Chamil1983/SM-GE3222M-Smart-Energy-Monitor/Examples/README.md

**SM-GE3222M ESP32 ATM90E32/ATM90E36 Smart IoT Power Energy Monitor**

------------

**NEW FIRMWARE**: [**Released**](https://github.com/Chamil1983/SM-GE3222M-Smart-Energy-Monitor/blob/main/Firmware_Released/) is an Integrated Firmware for SM-GE3222M Power Energy Monitor SDK Boards

*** IMPORTANT: This folder contains the IPEM Example Source Code. This is not the real Code Only for Reference

  Remember!
  - Set the BOARD to ESP32, 'WEMOS D1 MINI ESP32' DEV Module (or similar).
  - You may set the BAUD rate to 921600 to speed up flashing.
  - The SDK does NOT need external power to flash.  It will take Power from the USB 5V.

  This test code is OPEN SOURCE and formatted for easier viewing.  Although it is not intended for real-world use, it may be freely used, or modified as needed.
  It is distributed on an "AS IS" BASIS, WITHOUT WARRANTIES OR CONDITIONS OF ANY KIND, either express or implied.

We value our Customers, Users of our designs, and STEM Communities, all over the World. Should you have any other questions, or feedback to share with others, please feel free to:

***Chamil Vithanage, Microcode Embedded Solutions, Australia.***

Electronics Engineer | Software Developer | R&D Support | RF Engineering | Product Certification and Testing
