Chamil1983/SM-GE3222M-Smart-Energy-Monitor/Firmware_Released/SM_GE3222M_V2_Project_Scope_Architecture.docx

SM-GE3222M Smart Energy Monitor
V2.0 Firmware & VB.NET Integration Scope

Project Scope and Architecture Definition (Pre-Implementation)
Date: 20 Feb 2026

# 1. Purpose and Scope

This document defines the complete end-to-end scope for the ESP32-based SM-GE3222M Energy Meter V2.0 firmware and its VB.NET application integration. It is intended to be finalized before coding begins, ensuring consistent architecture, interfaces, register maps, and validation/diagnostics behavior.

- Firmware target: ESP32 (Arduino framework, FreeRTOS tasks).
- Energy IC driver: EnergyATM90E36.h/.cpp MUST remain unchanged from V1.0.
- Hardware configuration and calibration defaults MUST match V1.0 Definitions.h baseline.
- Modbus TCP is removed completely. Modbus RTU only.
- Ethernet TCP/IP is used for general TCP JSON communications today; future BACnet/IP will reuse Ethernet stack.
- Web UI is optional but supported; it must consume the same runtime data model as Modbus and TCP.

# 2. Key Design Constraints

- Do not modify EnergyATM90E36.h/.cpp (bit-identical to V1.0).
- SPI pins for ATM90E36: CS=GPIO5, SCK=GPIO18, MISO=GPIO19, MOSI=GPIO23.
- MCP23017 I2C address 0x20 with interrupt outputs: INT_A=GPIO25, INT_B=GPIO26.
- DHT22 sensor input: DHTPIN=GPIO4.
- DC voltage sensing (ADC1): DCV_IN=GPIO36.
- LCD: 20x4 LiquidCrystal_I2C address 0x27.
- Stable networking priority: Ethernet -> WiFi STA-only -> AP-only fallback (no mode flapping).
- Single source of truth runtime data model shared across LCD, Web, TCP JSON, and Modbus RTU.

# 3. Hardware Configuration

All pins and peripherals below are authoritative for V2.0 and must match the V1.0 baseline where applicable.

Subsystem | Device / Interface | Pins / Address | Notes / Ownership
MCU | ESP32 | - | Arduino framework, FreeRTOS tasks
Energy IC | ATM90E36 (SPI) | CS=5, SCK=18, MISO=19, MOSI=23 | SPIBus initializes pins; driver unchanged
I/O Expander | MCP23017 (I2C) | Addr 0x20; INT_A=25; INT_B=26 | All expander IO via MCP23017Hal
LCD | LiquidCrystal_I2C | Addr 0x27; 20x4 | LCDManager uses shared I2C bus
Sensor | DHT22 | GPIO4 | DHT22Service only; timed reads (>=2s)
Analog Sense | DC Voltage ADC | GPIO36 (ADC1) | DcVoltageService + AdcHal; filtered & scaled
Buttons | Mode, Set | GPIO32, GPIO33 | Debounced; UI events
Ethernet | W5500 (SPI or dedicated) | per board | General TCP/IP today; future BACnet/IP
Wi-Fi | ESP32 radio | - | STA-only or AP-only; no dual mode

MCP23017 logical channel assignment (example as per V1 baseline):

MCP Pin Index | Signal | Direction / Use
0 | RELAY_2 | Output
1 | RELAY_1 | Output
2 | WIFI_LED | Output
3 | RUN_LED | Output
4 | FLT_LED | Output
5 | MODBUS_LED | Output
11 | CF4 | Input (pulse)
12 | CF3 | Input (pulse)
13 | CF2 | Input (pulse)
14 | CF1 | Input (pulse)

# 4. Proposed Firmware Directory Structure

The V2.0 project remains within the existing Arduino sketch structure and adds modular code under src/.

SM_GE3222M/
SM_GE3222M.ino (thin: boot + scheduler start)
Definitions.h (V1 baseline: calibration + hardware constants)
EnergyATM90E36.h/.cpp (UNTOUCHED driver)
data/ (SPIFFS web assets)
include/
PinMap.h
GlobalTypes.h
Version.h
ModbusRegMap.h (constants only)
src/
core/
SystemManager.h/.cpp (boot phases, SAFE MODE, orchestrator)
TaskScheduler.h/.cpp (cooperative tick scheduler)
TimerManager.h/.cpp
EventBus.h/.cpp (optional)
hal/
BoardConfig.h/.cpp (authoritative pins/feature flags)
SPIBus.h/.cpp (SPI pin init: 18/19/23 + CS5)
I2CBus.h/.cpp (shared Wire + mutex)
MCP23017Hal.h/.cpp (IO + interrupt capture)
AdcHal.h/.cpp (ADC1 reads + filtering helpers)
GPIOManager.h/.cpp (buttons, esp gpio)
energy/
EnergyMeter.h/.cpp (wraps unchanged driver; validates readings)
Calibration.h/.cpp (apply + store validation)
EnergyAccumulator.h/.cpp (persistent totals)
sensors/
DHT22Service.h/.cpp (GPIO4)
DcVoltageService.h/.cpp (GPIO36)
comm/
EthernetManager.h/.cpp (general TCP/IP + link status)
WiFiManager.h/.cpp (STA-only/AP-only; fallback policy)
TcpJsonLinkService.h/.cpp (ESP32 <-> VB TCP JSON)
ModbusRTUServer.h/.cpp (Modbus RTU only; no Modbus TCP)
ModbusMap.h/.cpp (getters/setters wired to SystemContext)
WebServerManager.h/.cpp (optional HTTP/WS)
APIServer.h/.cpp (JSON endpoints for Web)
display/
LCDManager.h/.cpp (LiquidCrystal_I2C 0x27, 20x4)
LEDIndicator.h/.cpp (status patterns)
storage/
SPIFFSManager.h/.cpp (mount + file helpers)
ConfigManager.h/.cpp (/config.txt compatible)
NVStorage.h/.cpp (optional NVS mirror)
DataLogger.h/.cpp (event log ring buffer)
diagnostics/
Logger.h/.cpp (ring buffer + levels)
ErrorHandler.h/.cpp (codes, severity, recovery policy)
HealthMonitor.h/.cpp (reboot loop detect, heap checks)
WatchdogManager.h/.cpp (task liveness + WDT feed)

# 5. Proposed V2.0 Firmware Architecture

Architecture is layered to prevent cross-coupling, eliminate blocking behavior, and ensure one data model feeds all interfaces.

+--------------------------------------------------------------+
| Application Layer |
| LCD UI | Web UI (optional) | TCP JSON Link | Modbus RTU |
+-------------------------+------------------------------------+
| Services Layer |
| EnergyService | SensorServices | ConfigStore | Diagnostics |
+-------------------------+------------------------------------+
| Hardware Abstraction Layer |
| SPIBus | I2CBus | MCP23017Hal | AdcHal | GPIOManager |
+-------------------------+------------------------------------+
| Platform / OS (ESP32 Arduino) |
| FreeRTOS tasks, WDT, WiFi/Ethernet stacks, SPIFFS |
+--------------------------------------------------------------+

Key rules:

- Only HAL modules access hardware buses (SPI/I2C/ADC/GPIO).
- Only service modules update the SystemContext runtime model.
- UI and protocols are read-only consumers of SystemContext except via controlled command APIs.
- No I2C or SPI operations inside ISRs; ISRs only set flags for tasks.

# 6. Firmware Data Flow Block Diagram

+--------------------+
| ConfigManager |
| /config.txt + CRC |
+----------+---------+
|
v
+-------------+ +--------------+--------------+ +------------------+
| ATM90E36 IC | --> | EnergyMeter (driver wrapper) | --> | |
+-------------+ +--------------+--------------+ | |
| | |
v | |
+-------------+ +--------------+--------------+ | SystemContext |--> LCDManager
| DHT22 | --> | DHT22Service (timed reads) | ----> | (single truth) |--> WebServer/APIServer
+-------------+ +--------------+--------------+ | |--> TcpJsonLinkService
| | |--> ModbusRTUServer
v | |
+-------------+ +--------------+--------------+ | |
| ADC GPIO36 | --> | DcVoltageService (filter) | ----> | |
+-------------+ +--------------+--------------+ +------------------+
^
|
+--------------+--------------+
| MCP23017Hal (INTA/INTB) |
| pulse + DI capture + DO set |
+-----------------------------+

Data update policy: energy/sensors/network tasks write to SystemContext; protocol/UI tasks read only.

# 7. Communication Protocol V2 (TCP JSON, Backward Compatible)

TCP protocol is newline-delimited JSON frames. It remains backward compatible by preserving existing keys used by the VB.NET application, while adding optional V2 fields.

- Transport: TCP socket over Ethernet or WiFi (STA/AP).
- Framing: UTF-8 JSON per line (\n). No binary framing required.
- Compatibility: V1 keys are preserved; V2 adds optional fields under 'v2' object where needed.
- Reliability: sequence counters + acknowledgements for commands; reconnect safe.

Message types (minimum set):

Type | Direction | Purpose | Required Fields
hello | ESP32 -> VB | Device identity and capabilities | fw, hw, mac, mode, features
status | ESP32 -> VB | Network + health snapshot | uptime, net, rssi, heap, errors
readings | ESP32 -> VB | Energy + sensor readings | seq, ts, energy{}, sensors{}
config | VB -> ESP32 / ESP32 -> VB | Get/set config snapshot | action=get|set, payload{}
cmd | VB -> ESP32 | Command execution | id, name, args{}
ack | ESP32 -> VB | Acknowledgement for cmd/config | id, ok, code, msg
error | ESP32 -> VB | Asynchronous fault notification | code, severity, where

## 7.1 TCP Protocol Sequence Diagram (ESP32 ↔ VB.NET)

VB.NET ESP32
| |
|--- TCP connect ------------------------------->|
|<-- hello {fw,hw,mac,features} -----------------|
|--- config {action:'get'} --------------------->|
|<-- config {action:'snapshot',payload:{...}} ---|
| |
|<-- status {net,heap,uptime,errors[]} ----------| (periodic 1-5s)
|<-- readings {seq,ts,energy{},sensors{}} -------| (periodic publish interval)
| |
|--- cmd {id:101,name:'setRelay',args:{...}} --->|
|<-- ack {id:101,ok:true} ----------------------|
| |
|--- cmd {id:102,name:'saveConfig'} ------------>|
|<-- ack {id:102,ok:true} ----------------------|
| |
|<-- error {code:'NET-002',severity:'WARN'} -----| (async if needed)
| |
|--- TCP close / reconnect --------------------->|

## 7.2 Multi-Client Architecture (Normal Operation)

+-------------------+
| VB.NET Client |
+---------+---------+
| TCP JSON
v
+----------------------+------------------------+
| ESP32 Communication Layer |
| TcpJsonLinkService | ModbusRTUServer | WebUI |
+-----------+-------------------+---------------+
| |
v v
SystemContext SPIFFS/Web assets
^
|
Energy/Sensors/Network tasks

# 8. Configuration & Storage Architecture

Configuration storage is designed for safety (CRC + validation), backward compatibility (same filenames), and low risk of corruption.

- Primary store: SPIFFS files (same filenames as V1): /config.txt, /Calibration_1.txt.. /Calibration_4.txt.
- Each file includes a V2 header (version + CRC) while preserving V1 key names and layout.
- Validation and defaulting: missing keys -> defaults; invalid keys -> revert default + raise CFG warning/error.
- Optional NVS mirror (NVStorage) may cache validated config for quicker boot; SPIFFS remains authoritative for export/import.

SPIFFS
/config.txt
- device settings (network, ports, publish interval, feature enables)
- V2 header: version, CRC32, timestamp
/Calibration_1..4.txt
- calibration blocks (register-style values)
- V2 header: version, CRC32, timestamp
/eventlog.bin (optional)
- ring buffer of diagnostics/events
/totals.bin (optional)
- persistent energy totals + CRC

Write policy to reduce wear:

- Only write on explicit user command (save config) or controlled periodic commit for totals (e.g., every 5-15 minutes).
- Atomic update pattern: write temp file then rename to target to avoid partial writes.
- CRC check on read; if CRC fails -> load defaults and set persistent error flag.

# 9. Error Handling & Diagnostics Architecture

V2 introduces structured error codes, severity levels, recovery policies, and observability across LCD, Modbus, and TCP JSON.

Category | Examples | Severity | Recovery Policy
BOOT | boot timeout, reboot loop | FATAL/ERROR | enter SAFE MODE; limit services; require manual reset for some
CFG | missing key, CRC fail | WARN/ERROR | default values; persist error; continue
ENERGY | ATM90E36 init fail, invalid readings | ERROR/FATAL | retry with backoff; degrade mode; show error
NET | STA connect fail, ETH link down | WARN | fallback policy: ETH->STA->AP
I2C/SPI | bus timeout, MCP missing | ERROR | retry; isolate IO; continue with limited function
MODBUS | RTU framing errors, overload | WARN | throttle; increment counters
SENS | DHT timeout, ADC overrange | WARN | keep last valid; mark stale

Error source -> ErrorHandler (code + severity + context)
-> Logger (ring buffer)
-> HealthMonitor (counters, reboot loop detect)
-> Expose to:
- LCD status page (human readable)
- Modbus IR: last_error_code, boot_phase, counters
- TCP JSON: async 'error' frames

# 10. FreeRTOS Task Architecture

Tasks are non-blocking and use a cooperative scheduler tick where possible; long operations are broken into state machines.

Task | Owner Module | Priority | Period/Trigger | Core | Notes
BootTask | core/SystemManager | High | One-shot state machine | Any | Phased init with timeouts
MCPInterruptTask | hal/MCP23017Hal | High | INT_A/INT_B flags | Any | Reads INTCAP; updates DI/pulses
EnergyReadTask | energy/EnergyMeter | Med-High | 200-500 ms | Any | Updates MeterReadings
DHT22Task | sensors/DHT22Service | Low | 2 s | Any | Timed reads; no blocking loops
DCVTask | sensors/DcVoltageService | Low-Med | 200-500 ms | Any | ADC oversample + filter
NetworkTask | comm/*Manager | Med | State machine | Any | ETH->STA->AP fallback
TcpJsonTask | comm/TcpJsonLinkService | Med | Publish interval + socket events | Any | Frames + ACK
ModbusRTUTask | comm/ModbusRTUServer | Med | 10-50 ms tick | Any | RTU only
WebTask (optional) | comm/WebServerManager | Low-Med | event-driven | Any | HTTP endpoints
LCDTask | display/LCDManager | Low | 250-500 ms | Any | Draw diffs only
HealthTask | diagnostics/HealthMonitor | Low | 1-5 s | Any | Heap + reboot loop detect
WDTFeedTask | diagnostics/WatchdogManager | High | 100-250 ms | Any | Feeds only if tasks healthy

# 11. Boot Sequence Diagram

PHASE 0 Reset reason + minimal logger
PHASE 1 SPIFFS mount + load config + load calibration (CRC validate)
PHASE 2 HAL init (SPI pins, I2C, ADC, GPIO, attach INT_A/INT_B)
PHASE 3 MCP23017 init + interrupt-on-change setup + clear captures
PHASE 4 LCD init (0x27, 20x4) + buttons + boot UI
PHASE 5 Energy IC init (unchanged driver) + retry/backoff + safe mode rules
PHASE 6 Sensors start (DHT22 + DCV)
PHASE 7 Network start (ETH -> STA -> AP fallback)
PHASE 8 Start services: TCP JSON, Modbus RTU, optional Web UI
RUN Periodic read/update + diagnostics + watchdog

SAFE MODE entry conditions (examples):

- Energy IC fails init after N retries OR repeated reboot loop detected.
- SPIFFS mount fails or configuration CRC repeatedly invalid.
- In SAFE MODE: allow AP-only + minimal web/config + diagnostics; disable high-rate sampling; keep Modbus RTU optional.

# 12. Modbus RTU Register Map Overview

Modbus TCP is removed. This map is for Modbus RTU using emelianov/modbus-esp8266. Encoding follows V1-style scaled int32 across 2 registers.

- Float-style values: int32 scaled by 10 across two 16-bit registers (low word first).
- uint32 counters: two registers (low word first).
- Bitfields: uint16.
- IPv4: two registers (A<<8|B, C<<8|D).
- MAC: three registers.

Block | Type | Range (hex) | Contents
Input Registers | 3x (RO) | 0x0000-0x009F | V1 energy + RMS/THD/angles (unchanged)
Input Registers | 3x (RO) | 0x00B0-0x00BF | Sensors: DHT22, DCV, statuses
Input Registers | 3x (RO) | 0x00C0-0x00CF | IO: relays/DI bitmaps, CF pulse counters
Input Registers | 3x (RO) | 0x00D0-0x00DF | Network runtime: mode, IPs, RSSI
Input Registers | 3x (RO) | 0x00E0-0x00EF | Diagnostics: uptime, heap, last error
Holding Registers | 4x (RW) | 0x0000-0x0048 | Calibration arrays (stride=2)
Holding Registers | 4x (RW) | 0x0080-0x0088 | Calibration config (MMode0/1 thresholds)
Holding Registers | 4x (RW) | 0x0200-0x0210 | Modbus RTU & COM settings
Holding Registers | 4x (RW) | 0x0300-0x0384 | Identity strings + MAC + board features
Holding Registers | 4x (RW) | 0x0400-0x040C | Ethernet config (DHCP/static, port)
Holding Registers | 4x (RW) | 0x0500-0x052C | WiFi STA config (SSID/pass + IP)
Holding Registers | 4x (RW) | 0x0600-0x0623 | WiFi AP config (SSID/pass + channel + IP)
Holding Registers | 4x (RW) | 0x0700-0x0704 | Web + TCP JSON link settings
Holding Registers | 4x (RW) | 0x0800-0x0849 | Logging, commands, event log window
Holding Registers | 4x (RW) | 0x0850-0x0854 | Pulse output settings (V1 compatible)

Detailed constants are implemented in include/ModbusRegMap.h and consumed by src/comm/ModbusMap.* getters/setters.

# 13. Implementation Scope & Feature Matrix (V1.0 → V2.0)

Area | V1.0 | V2.0 Target | Status in V2 Plan | Notes
Energy IC driver | Working but tightly coupled | Driver unchanged; wrapper + validation | Must keep driver identical | EnergyATM90E36.* untouched
Calibration | SPIFFS text, limited validation | CRC + versioning + atomic writes | Planned | Backward compatible filenames
Networking | Unstable switching | ETH -> STA-only -> AP-only stable | Planned | No mode flapping
Web UI | Partial/unstable | Optional HTTP using shared model | Planned | No blocking in web task
VB comms | Mixed / evolving | TCP JSON V2 + backward keys | Planned | Sequence + ACK
Modbus | RTU + sometimes TCP | RTU only (TCP removed) | Mandatory | Uses emelianov/modbus-esp8266
MCP23017 IO | Basic polling | Interrupt-driven capture + IO shadow | Planned | INT_A=25 INT_B=26
Sensors | Not unified | DHT22 + DCV via services | Added | GPIO4 + GPIO36
Diagnostics | Ad-hoc logs | Error codes + health monitor + event log | Added | Exposed via Modbus + TCP
WDT stability | WDT triggers observed | Non-blocking state machines + liveness checks | Key goal | WatchdogManager gates feed

# 14. Implementation Roadmap

Roadmap is phased to deliver stability first, then features, while keeping the driver unchanged.

Phase | Primary Deliverables | Validation / Tests | Exit Criteria
Phase A - Foundations | Directory structure, SystemContext, Logger, ErrorHandler, SPIFFS config loader (CRC) | Boot without reset; config load + defaulting; basic serial logs | Stable boot, no WDT, correct pin init
Phase B - Hardware HAL + IO | SPIBus pins fixed; I2CBus; MCP23017Hal + INT handling; GPIO + buttons | Interrupt fires; pulse counters increment; outputs controllable | No I2C lockups; stable ISR->task handoff
Phase C - Energy layer | EnergyMeter wrapper, retries/backoff, reading validation; accumulator | Energy readings update at rate; invalid reads flagged; totals persist | No boot halt; readings consistent with V1
Phase D - Sensors | DHT22Service + DcVoltageService; add to model + Modbus | DHT reads every 2s without blocking; DCV filtered | Sensor statuses and values visible
Phase E - Comms | NetworkManager ETH->STA->AP; TCP JSON link; Modbus RTU map; optional Web | Reconnect tests; multi-client; command/ack tests; Modbus scan | VB stable connect; Modbus consistent; no resets
Phase F - Diagnostics hardening | HealthMonitor, WDT gating, event log; performance tuning | Soak test 24-72h; simulated network drops; heap stability | Meets metrics; no watchdog resets

# 15. Improvement Metrics Summary

Quantitative targets to confirm V2.0 improvements:

Metric | Baseline (V1 typical) | V2 Target | How to Measure
Boot time to stable services | Variable; may halt/reset | < 20 s to RUN state | Timestamp logs per boot phase
WDT resets | Observed in web/network tasks | 0 resets in 72h soak | Reset reason counter + event log
WiFi STA reconnect time | Unstable | < 10 s after AP/STA loss | NetworkTask timing + VB status frames
Ethernet link recovery | N/A/variable | < 5 s after link restore | ETH status + IP lease time
Heap minimum | Drops under load | > 40 KB minimum free heap | HealthMonitor min heap register
CPU load | High during polling | Stable under 60% peak | Profiler counters / loop timing
Energy read cadence | Jittery during comms | Consistent +/- 10% | Sequence timestamps

# 16. End-to-End Communication Sequence Diagrams

## 16.1 Normal Operation (ETH active)

BOOT -> NetworkTask selects Ethernet -> TCP JSON server starts -> Modbus RTU ready
VB connects:
1) hello + capabilities
2) config snapshot (optional)
3) periodic status + readings
Commands:
- VB sends cmd (e.g., set relay / save config)
- ESP32 validates -> applies -> ack
Modbus RTU:
- PLC/HMI polls energy (IR 0x0000..0x009F) and sensors/net/diag blocks
Web UI (optional):
- Browser reads /api/status and /api/readings (same SystemContext)

## 16.2 Multi-Client (VB + Web + Modbus RTU)

Clients:
- VB.NET (TCP JSON) (high-level control + config + graphs)
- PLC/HMI (Modbus RTU) (industrial integration)
- Browser (HTTP) optional (service UI)
All clients read the same SystemContext snapshot.
Write operations are serialized through command handlers:
VB cmd/config -> CommandQueue -> SystemManager applies -> ack -> optional persist

# Appendix A. JSON Frame Examples (V2 compatible)

hello:
{"type":"hello","fw":"2.0.0","hw":"GE3222M-A","mac":"C8:2E:A3:F5:7D:DC","features":{"eth":1,"wifi":1,"dht22":1,"dcv":1,"lcd":1,"mcp":1}}

readings:
{"type":"readings","seq":1234,"ts":1739960000,
"energy":{"uA":2305,"uB":2310,"uC":2298,"iA":120,"iB":110,"iC":98,"pT":3520},
"sensors":{"tC":285,"rh":520,"dcv":123}
}

cmd:
{"type":"cmd","id":101,"name":"setRelay","args":{"ch":1,"on":true}}

ack:
{"type":"ack","id":101,"ok":true}

# Appendix B. Modbus Blocks Summary

Use include/ModbusRegMap.h for full constants. Key blocks:

- IR 0x0000-0x009F: V1 energy block (unchanged).
- IR 0x00B0-0x00BF: sensors (DHT22, DCV).
- IR 0x00C0-0x00CF: IO (bitmaps + CF pulse counters).
- IR 0x00D0-0x00DF: network runtime.
- IR 0x00E0-0x00EF: diagnostics.
- HR blocks: calibration (0x0000+), config, identity, network settings, logging, commands.

End of document.
