Chamil1983/SM-GE3222M-Smart-Energy-Monitor/Firmware_Released/Updated_Implementation_Plan_SM_GE3222M_V2_W5500_BACnet.docx

Updated Implementation Plan for SM_GE3222M_V2

W5500 EthernetManager + BACnet/IP Integration + Device/Binary/Analog Object Extensions

This document captures the updated implementation plan for integrating a W5500 Ethernet module, BACnet/IP services, expanded BACnet Device metadata, additional Binary Input and Binary Output object mappings, GPIO36 ADC-based DC voltage monitoring, RTC/time exposure, and communication interface configuration and monitoring for the SM_GE3222M_V2 energy meter firmware project.

The plan is designed to fit within the current project structure, protect existing Web UI behavior, and preserve overall firmware stability under continuous load.

# 1. Scope Update Summary

The implementation scope includes the following major additions and updates:

- New EthernetManager.h/.cpp for W5500 Ethernet on shared SPI bus (MISO GPIO19, MOSI GPIO23, SCK GPIO18, CS GPIO14; INT and RST not connected).
- BACnet/IP over W5500 Ethernet (UDP port 47808) with transport health monitoring, auto-rebind, and load-safe processing.
- Refactored BACnetDriver and BACnetIntegration layers aligned to the SM_GE3222M_V2 project architecture.
- Expanded BACnet Device Object metadata including identity, firmware/application versions, and Object_List.
- Custom MESA vendor properties for device identity, network addressing, AP details, and runtime service information.
- Additional Binary Output objects for MCP Port-A LEDs (WiFi, Run, Fault, Modbus Activity).
- Additional Binary Input objects for MCP Port-B signals (IRQ1, IRQ2, ATM_WARN, CF1, CF2, CF3, CF4).
- New Analog Input object for scaled DC voltage at GPIO36 (VP / ADC1_CH0).
- RTC/time exposure using ESP32 system time and existing NTP synchronization infrastructure.
- Communication interface configuration and monitoring section for Modbus, WiFi (Station and AP), and Ethernet settings, including IP/Subnet/Gateway/DNS and MAC addresses.

# 2. Design Goals and Constraints

The design goal is to add Ethernet and BACnet/IP functionality without destabilizing existing energy meter sampling, logging, Modbus services, or Web UI behavior.

- No changes to frontend Web UI files (data/index.html, dashboard.js, style.css).
- No forced migration of existing Web or TCP JSON services to Ethernet in this phase.
- BACnet/IP must remain stable under continuous polling and mixed traffic.
- W5500 and ATM90E36 share the SPI bus and must be synchronized to prevent transaction collisions.
- Implementation should be project-native and compatible with the current task and module structure.

# 3. Critical Hardware and Bus Considerations

The W5500 Ethernet controller shares the SPI bus with the ATM90E36 metering IC. The ATM90E36 uses one SPI mode/speed profile while W5500 typically uses a different profile. Unsynchronized access can corrupt meter reads or network transfers.

Planned mitigation: extend and reuse the existing SPIBus arbitration (mutex-based) so all W5500 transactions are protected by the same SPI bus lock mechanism used by the meter path.

Signal | Pin | Notes
SPI MISO | GPIO19 | Shared SPI bus line
SPI MOSI | GPIO23 | Shared SPI bus line
SPI SCK | GPIO18 | Shared SPI bus line
W5500 CS | GPIO14 | Ethernet chip select
W5500 INT | Not connected | Polling mode only
W5500 RESET | Not connected | Software recovery only

# 4. Architecture Overview

The architecture is split into a transport manager, a BACnet core driver, and a project-specific integration layer.

- EthernetManager: initializes and supervises W5500, tracks link/IP state, manages UDP socket lifecycle for BACnet, and performs software recovery.
- BACnetDriver: handles BACnet/IP packet processing, discovery (Who-Is / I-Am), property read/write services, request validation, and runtime statistics.
- BACnetIntegration: maps SM_GE3222M_V2 data structures and hardware status/control points to BACnet Device/AI/BI/BO objects, including new LEDs, diagnostic inputs, and GPIO36 DC voltage AI.
- RTC / Time Layer: uses ESP32 system time and existing NTPSync infrastructure to provide timestamps and BACnet time properties.

# 5. EthernetManager.h/.cpp Implementation Plan

EthernetManager will be a project-native driver wrapper for the W5500 Ethernet controller using the Arduino Ethernet and EthernetUDP APIs, with explicit SPI protection and state recovery.

## 5.1 Primary Responsibilities

- Initialize SPI and W5500 with project pin definitions from PinMap.h (CS on GPIO14).
- Support DHCP and static addressing modes.
- Detect link status and debounce link changes.
- Track valid IP state and detect IP changes (especially after DHCP renewal).
- Provide BACnet UDP bind/read/write wrappers and socket restart logic.
- Implement software recovery when link/IP/UDP failures persist (no hardware reset pin available).
- Expose runtime status and counters for diagnostics and BACnet vendor properties.

## 5.2 Proposed Public API

Representative interface (planned):

bool begin(const EthernetConfig& cfg);
void update();

bool isInitialized() const;
bool isLinkUp() const;
bool isIpReady() const;

IPAddress localIP() const;
IPAddress subnetMask() const;
IPAddress gatewayIP() const;
IPAddress dnsServerIP() const;
String macAddressString() const;

bool ensureBacnetUdpBound(uint16_t port);
void closeBacnetUdp();
int bacnetUdpRead(uint8_t* buf, size_t len, IPAddress& remoteIp, uint16_t& remotePort);
bool bacnetUdpSend(const uint8_t* data, size_t len, const IPAddress& dstIp, uint16_t dstPort);

bool consumeLinkChangedFlag();
bool consumeIpChangedFlag();

const EthernetStatus& status() const;

## 5.3 Recovery Strategy

- Poll Ethernet.linkStatus() and IP state in update().
- If link drops: mark UDP as invalid, increment counters, and wait for link restoration.
- If link restores: verify IP (DHCP or static), rebind BACnet UDP, and notify BACnet layer to re-announce I-Am.
- If UDP bind fails repeatedly: close socket, reinitialize Ethernet interface, and retry with backoff.
- All SPI operations are guarded by SPIBus lock/unlock to prevent conflicts with metering operations.

# 6. BACnetDriver Refactor Plan (SM_GE3222M_V2)

The attached BACnetDriver developed previously will be refactored to remove KC868-specific assumptions and align to the SM_GE3222M_V2 architecture and data model.

## 6.1 Refactor Objectives

- Remove legacy project dependencies and direct global references.
- Use EthernetManager as the transport provider for BACnet/IP over W5500.
- Retain useful BACnet features: Who-Is, I-Am, ReadProperty, WriteProperty (for supported objects), duplicate request cache, and vendor properties.
- Ensure non-blocking packet processing and bounded work per cycle to remain watchdog-safe under continuous load.
- Expose runtime statistics (rx, tx, errors, duplicate hits, last client address, restarts).

## 6.2 BACnet Services in This Phase

Service | Support | Notes
Who-Is | Yes | Respond with I-Am when device instance matches / unicast or broadcast request
I-Am | Yes | On discovery and periodic announce (configurable interval)
ReadProperty | Yes | Device, AI, BI, BO core properties and custom MESA vendor properties
WriteProperty | Partial | BO Present_Value writes (relay and LED objects), selected writable vendor properties
COV / SubscribeCOV | No (Phase 2) | Can be added later if required for true asynchronous updates

## 6.3 Continuous Load Stability Measures

- Bound max processed packets per cycle (configurable, e.g. 4).
- Drop oversized or malformed packets with error counters.
- Use duplicate request cache to avoid repeated heavy processing.
- Rebind UDP on Ethernet link/IP change events.
- Periodic I-Am re-announcement after transport recovery.

# 7. BACnetIntegration Plan (Project Mapping Layer)

BACnetIntegration is the project-specific adapter that maps energy meter measurements, GPIO states, network status, and time information into BACnet objects and properties.

## 7.1 Data Sources

- EnergyMeter snapshot (phase voltages, currents, powers, frequency, power factor, energy totals).
- GPIOManager (relays, MCP Port-A LED states, MCP Port-B diagnostic inputs).
- SMNetworkManager (WiFi station/AP state and addresses).
- EthernetManager (Ethernet MAC/IP/Subnet/Gateway/DNS, link state, health counters).
- NTPSync / ESP32 system time (time validity and formatted date/time).
- ADC reader for GPIO36 (scaled DC voltage input).

## 7.2 Control Outputs (Writes)

- BO1..BO2 writes map to Relay 1 and Relay 2 via GPIOManager.
- BO3..BO6 writes map to MCP Port-A LED outputs (WiFi, Run, Fault, Modbus LED) when remote override is enabled.
- Future extension point for external time sync writes (e.g., from .NET application).

# 8. BACnet Device Object Plan (Expanded Metadata)

The Device object will expose both standard BACnet identity properties and custom MESA vendor properties for commissioning, diagnostics, and future .NET integration.

## 8.1 Standard Device Properties

Property | Source / Notes
Object_Identifier | Configurable BACnet device instance
Object_Name | Configurable via persistent settings
Description | Configurable via persistent settings
Location | Configurable via persistent settings
Vendor_Name | Constant: MESA / Microcode Embedded Systems and Automation
Vendor_Identifier | Configured constant
Model_Name | Constant or config (e.g. SM_GE3222M V2)
Serial_Number | Configurable or derived from unique ID / MAC fallback
Firmware_Revision | Firmware build/version constant
Application_Software_Version | Application version constant
Object_List | Generated from enabled objects at runtime
Protocol / APDU properties | Standard BACnet stack values

## 8.2 Custom MESA Vendor Properties (Expanded)

Vendor properties will be added on the Device object for easier integration with supervisory software and future .NET tooling.

Category | Vendor Property Examples | Notes
Identity | MAC Address, HW Version, Year Developed | Primary and interface-specific MACs can be exposed
Ethernet | IP, Subnet, Gateway, DNS1, DNS2, Link State | Updated live from EthernetManager
WiFi STA | STA MAC, STA IP, SSID, connection state | Read from SMNetworkManager
WiFi AP | AP SSID, AP Pass, AP IP, AP MAC | Security policy should mask password by default
BACnet | BACnet Port, Refresh Interval, Last Client IP, Health Summary | Useful for diagnostics
Time | DateTime string, Time Sync Status, Last Sync Unix | From system time / NTPSync

## 8.3 Security Note for AP Password Property

Exposing the AP password through BACnet is technically possible but sensitive. Recommended default behavior is to expose a masked string (e.g. ********) unless a commissioning-only configuration flag explicitly permits raw password readback.

# 9. BACnet Object Model (Updated)

The BACnet object model is meter-centric and extended with diagnostics and service indicators requested for this project.

## 9.1 Analog Input Objects (AI) - Core Meter Values

- AI1..AI3: Phase A/B/C Voltage
- AI11..AI13: Phase A/B/C Current
- AI21..AI23: Phase A/B/C Active Power
- AI31..AI33: Phase A/B/C Power Factor
- AI40..AI45: Total Power, Reactive Power, Apparent Power, Total PF, Frequency, Neutral Current
- AI50..AI52: Board / Ambient Temperature and Humidity (if available)
- AI60..AI63: Forward/Reverse Active and Reactive Energy totals

## 9.2 New Analog Input Object for DC Voltage

Object | Mapping | Type | Description
AI70 | GPIO36 (VP / ADC1_CH0) | Read-only Analog Input | Scaled DC voltage using divider ratio, gain, and offset calibration

AI70 will read raw ADC samples from GPIO36, apply averaging/filtering, convert to ADC pin voltage, and then apply divider and calibration factors to produce engineering units (Volts).

## 9.3 Binary Output Objects (Writable)

BO | Mapped Signal | Direction | Notes
BO1 | Relay 1 | Write/Read state | Maps to GPIOManager relay control
BO2 | Relay 2 | Write/Read state | Maps to GPIOManager relay control
BO3 | MCP_PORTA_WIFI_LED (GPA2) | Write/Read state | WiFi Status LED
BO4 | MCP_PORTA_RUN_LED (GPA3) | Write/Read state | Running LED (Green)
BO5 | MCP_PORTA_FLT_LED (GPA4) | Write/Read state | Fault LED (Red)
BO6 | MCP_PORTA_MODBUS_LED (GPA5) | Write/Read state | Modbus Activity LED

Recommended default behavior: LED BO writes are accepted only when a BACnet configuration flag (ledRemoteOverrideEnable) is enabled, so firmware-controlled status indication remains intact unless intentionally overridden.

## 9.4 Binary Input Objects (Read-only Status)

BI | Mapped Signal | Notes
BI1..BI8 | System / network / service status | Meter valid, WiFi connected, AP active, Ethernet link, BACnet active, Modbus active, time sync valid, etc.
BI20 | MCP_PORTB_IRQ_1 (GPB0) | Diagnostic input status
BI21 | MCP_PORTB_IRQ_2 (GPB1) | Diagnostic input status
BI22 | MCP_PORTB_ATM_WARN (GPB2) | ATM90E36 warning input
BI23 | MCP_PORTB_CF1 (GPB3) | Pulse state (read-only level)
BI24 | MCP_PORTB_CF2 (GPB4) | Pulse state (read-only level)
BI25 | MCP_PORTB_CF3 (GPB5) | Pulse state (read-only level)
BI26 | MCP_PORTB_CF4 (GPB6) | Pulse state (read-only level)

CF1..CF4 are exposed as level/status inputs in this phase. If pulse counting is required later, a Phase-2 extension can add counters or accumulator objects.

# 10. Data Structures (Additive, Project-safe)

To avoid breaking current firmware modules, the plan uses additive configuration and runtime structures. These can be added to DataTypes.h and persisted through ConfigManager as needed.

## 10.1 DeviceIdentityConfig

Planned structure:

struct DeviceIdentityConfig {
char objectName[48];
char description[96];
char location[64];

char vendorName[32];
uint16_t vendorIdentifier;

char modelName[32];
char serialNumber[32];

char firmwareRevision[24];
char appSoftwareVersion[24];

char hwVersion[16];
uint16_t yearDeveloped;
};

## 10.2 EthernetConfig and EthernetStatus

EthernetConfig stores persistent Ethernet and BACnet-over-Ethernet settings. EthernetStatus stores runtime state and counters (link, IP, UDP bound, recovery counts, and current addressing).

Representative fields (summary):

struct EthernetConfig {
bool enabled;
bool useDHCP;
char macAddress[18];
char ip[16];
char subnet[16];
char gateway[16];
char dns1[16];
char dns2[16];
bool bacnetEnabled;
uint16_t bacnetPort;
uint16_t bacnetRefreshMs;
bool bacnetBroadcastIAm;
uint16_t bacnetIAmIntervalSec;
};

struct EthernetStatus {
bool initialized;
bool hardwareDetected;
bool linkUp;
bool ipReady;
bool udpBound;
bool dhcpActive;
uint32_t lastLinkChangeMs;
uint32_t lastIpChangeMs;
uint32_t lastRecoveryMs;
uint16_t recoveryCount;
uint16_t linkDropCount;
uint16_t udpRebindCount;
uint16_t errorCount;
char macAddress[18];
char ip[16];
char gateway[16];
char subnet[16];
char dns1[16];
};

## 10.3 BACnetConfig (Extended)

Planned fields:

struct BACnetConfig {
bool enabled;
uint32_t deviceInstance;
uint16_t udpPort;
uint16_t objectRefreshMs;
bool periodicIAmEnabled;
uint16_t periodicIAmSec;
bool autoRecoverTransport;
uint16_t maxPacketsPerCycle;

bool exposeRawApPassword;
bool ledRemoteOverrideEnable;

bool enableDcVoltageAI;
bool enableMcpDiagnosticBIs;
bool enableLedBOs;
};

## 10.4 ADC Configuration and Runtime Data

Planned structures:

struct AdcConfig {
bool dcInputEnabled;
float dcAdcGain;
float dcAdcOffset;
float dcDividerRatio;
uint16_t dcFilterSamples;
};

struct AdcRuntimeData {
uint16_t raw;
float pinVoltage;
float scaledVoltage;
bool valid;
uint32_t lastUpdateMs;
};

## 10.5 RTC and BACnet Runtime Stats

RTCStatus tracks time validity, NTP state, and formatted date/time strings. BACnetRuntimeStats tracks packet counters, parse errors, duplicate request hits, and last client address.

Representative runtime stats (summary):

struct RTCStatus {
bool timeValid;
bool ntpEnabled;
bool ntpSynced;
uint32_t unixTime;
uint32_t uptimeSeconds;
char iso8601[25];
int16_t timezoneOffsetMin;
uint32_t lastSyncUnix;
};

struct BACnetRuntimeStats {
uint32_t rxPackets;
uint32_t txPackets;
uint32_t rxErrors;
uint32_t parseErrors;
uint32_t readPropertyCount;
uint32_t writePropertyCount;
uint32_t whoIsCount;
uint32_t iAmCount;
uint32_t duplicateReqHits;
uint32_t transportRestartCount;
uint32_t lastPacketMs;
uint32_t lastObjectRefreshMs;
char lastClientIP[16];
uint16_t lastClientPort;
};

# 11. RTC / Time Integration Plan

The project currently uses NTPSync and ESP32 system time rather than an external RTC IC. This is sufficient for Phase-1 BACnet time exposure and timestamped logging.

- Treat ESP32 system time + NTPSync as the firmware RTC source.
- Expose current date/time and sync status through BACnet vendor properties.
- Add timestamp fields (Unix time and ISO8601 string) to logs while keeping existing fields for backward compatibility.
- Reserve a future method for external time synchronization (e.g. from a .NET application).

# 12. Communication Interface Configuration and Monitoring Section (New)

A dedicated communication interface section will be added to the user-facing configuration/monitoring data model (backend-exposed and BACnet-readable in this phase) so operators can review and configure all active communications interfaces consistently.

## 12.1 Functional Goal

Provide one consolidated section where the user can configure and monitor all communication interfaces, including Modbus port parameters, WiFi station and AP settings, and Ethernet addressing details. This section also surfaces interface MAC addresses for Ethernet, WiFi Station, and WiFi AP.

## 12.2 Communication Interfaces Included

Interface | Configuration Items | Monitoring Items
Modbus Ports | Baud rate, parity, stop bits, slave ID, timeout, port enable, protocol mode | Link active, request count, error count, last activity, port status
WiFi Station (STA) | SSID, password, DHCP/static IP, subnet, gateway, DNS, hostname | Connected state, RSSI, IP, subnet, gateway, DNS, STA MAC, reconnect count
WiFi Access Point (AP) | AP SSID, AP password, AP IP, subnet, channel (if used), enable/disable | AP active state, client count (if available), AP IP, AP MAC
Ethernet (W5500) | DHCP/static IP, subnet, gateway, DNS1/DNS2, MAC address, BACnet port | Hardware detected, link state, IP state, Ethernet MAC, IP, subnet, gateway, DNS, recovery counters

## 12.3 BACnet Exposure Strategy for Communication Interface Section

In Phase-1, the communication interface section is primarily exposed for monitoring and partial configuration through BACnet vendor properties and Device object summaries. Full persistent write-back for every field can be completed in Phase-2.

- Read access: all interface status summaries and address information (including Ethernet / WiFi STA / WiFi AP MACs).
- Partial writes in Phase-1: selected BACnet settings and BO Present_Value controls.
- Phase-2 target: full writable and persistent communication settings through BACnet vendor properties and/or backend configuration endpoints, without changing existing Web UI frontend files.

## 12.4 Planned Data Model for Communication Section

Representative structure summary (conceptual):

struct CommInterfaceSummary {
// Modbus
bool modbusEnabled;
uint32_t modbusRxCount;
uint32_t modbusTxCount;
uint32_t modbusErrorCount;
uint32_t modbusLastActivityMs;
char modbusPortConfig[96];

// WiFi STA
bool staEnabled;
bool staConnected;
char staSSID[33];
char staIP[16];
char staSubnet[16];
char staGateway[16];
char staDNS1[16];
char staMac[18];
int8_t staRSSI;
uint32_t staReconnectCount;

// WiFi AP
bool apEnabled;
bool apActive;
char apSSID[33];
char apPassMasked[33];
char apIP[16];
char apMac[18];

// Ethernet
bool ethEnabled;
bool ethHardwareDetected;
bool ethLinkUp;
bool ethIpReady;
char ethIP[16];
char ethSubnet[16];
char ethGateway[16];
char ethDNS1[16];
char ethDNS2[16];
char ethMac[18];
uint16_t bacnetPort;
uint32_t ethRecoveryCount;
};

# 13. Configuration Storage Plan

Persistent settings should be extended in ConfigManager for BACnet identity, Ethernet settings, ADC calibration, and communication interface parameters.

- Device identity: Object Name, Description, Location, Vendor Identifier, Model Name, Serial Number, HW Version, Year Developed.
- BACnet behavior: device instance, UDP port, object refresh interval, periodic I-Am settings, packet-per-cycle limit, LED override flag, AP password exposure policy.
- Ethernet: enable, DHCP/static, IP/Subnet/Gateway/DNS, MAC (if user-configurable), BACnet port.
- ADC scaling: divider ratio, gain, offset, filter samples.
- Communication interface settings: Modbus port config, WiFi STA/AP config, and Ethernet config.

# 14. File-Level Implementation Plan

The following files are planned for addition or modification. All changes are backend/firmware side; Web UI frontend files remain untouched.

File | Action | Purpose
EthernetManager.h / EthernetManager.cpp | New | W5500 transport, link/IP state, UDP support, recovery
BACnetDriver.h / BACnetDriver.cpp | Revise | BACnet/IP core for SM_GE3222M_V2
BACnetIntegration.h / BACnetIntegration.cpp | Revise/New | Object mapping for meter data, LEDs, BIs, DC voltage AI, Device metadata
DataTypes.h | Revise (additive) | New config and runtime structs
ConfigManager.h / ConfigManager.cpp | Revise | Persistent storage for Ethernet/BACnet/identity/ADC settings
GPIOManager.h / GPIOManager.cpp | Revise | Helpers for MCP Port-A and Port-B read/write states
SPIBus.h / SPIBus.cpp | Revise | Explicit lock/unlock helpers for shared SPI transactions
TaskManager.h / TaskManager.cpp | Revise | Periodic service hooks for Ethernet and BACnet
SystemMonitor.h / SystemMonitor.cpp | Optional revise | Expose status and counters to diagnostics
DataLogger.h / DataLogger.cpp | Revise | Timestamp enhancements (Unix + ISO8601)
SM_GE3222M_V2.ino | Revise | Boot sequence init and periodic service calls
data/* (Web UI frontend) | No change | Preserve current UI files and behavior

# 15. Boot Sequence and Task Integration Plan

The implementation will be integrated into the existing phased boot structure without disrupting current WiFi/Web initialization.

## 15.1 Boot Phase Integration

- Phase 4 (Network): keep current WiFi STA/AP logic intact; initialize EthernetManager and report W5500 hardware/link/IP status.
- Phase 5 (Communications): initialize BACnetIntegration and BACnetDriver only when Ethernet is enabled and IP is ready; bind UDP port 47808.
- Loop / Task service: call EthernetManager.update() and BACnetIntegration/BACnetDriver update methods periodically with watchdog-safe timing.

## 15.2 Runtime Event Handling

- On Ethernet link change: update status, mark transport state changed, and request BACnet UDP rebind if needed.
- On IP change: refresh vendor properties and communication section summaries, then re-announce BACnet I-Am.
- On BACnet write to BOs: validate object and property, apply through GPIOManager, update object cache, and log write event.

# 16. Default Configuration Recommendations

Setting | Recommended Default | Rationale
Ethernet enabled | true | Enable W5500 path for BACnet/IP
Ethernet addressing | DHCP | Simplifies commissioning
BACnet enabled | true | Core feature target
BACnet UDP port | 47808 | Standard BAC0
Object refresh interval | 500 ms | Balance freshness and CPU load
Periodic I-Am | Enabled, 60 s | Discovery and health visibility
Max packets per cycle | 4 | Watchdog-safe under heavy polling
LED remote override | false | Preserve firmware-owned status indicators
Expose raw AP password | false | Security-safe default
DC voltage AI enabled | true | Useful diagnostic analog point

# 17. Testing and Validation Plan

Validation will focus on transport stability, SPI coexistence, BACnet behavior, and hardware mapping correctness.

1. Boot and detect W5500 hardware, verify link status, and confirm DHCP/static IP acquisition.
2. Stress concurrent meter reading and BACnet polling to confirm SPI arbitration prevents data corruption or timeouts.
3. Verify BACnet discovery (Who-Is / I-Am) using a BACnet explorer or .NET test client.
4. Verify ReadProperty for Device metadata, AI/BI/BO values, and custom MESA vendor properties.
5. Verify WriteProperty for BO1..BO6 behavior (with LED override policy enforced).
6. Verify MCP Port-B BI status mapping (IRQ1/2, ATM_WARN, CF1..CF4) against actual signal states.
7. Verify GPIO36 DC voltage AI scaling and calibration behavior.
8. Test Ethernet unplug/replug recovery, UDP rebind, and periodic I-Am after recovery.
9. Verify timestamp exposure (DateTime, sync status) and timestamped logging behavior.
10. Verify communication interface monitoring summaries show Modbus, WiFi, and Ethernet settings/status correctly.

# 18. Phased Implementation Plan

Phase | Focus | Deliverables
Phase A | Ethernet foundation | EthernetManager with W5500 init, link/IP monitoring, UDP bind support, recovery
Phase B | BACnet core refactor | SM_GE3222M_V2-aligned BACnetDriver with Who-Is/I-Am/ReadProperty/WriteProperty
Phase C | Project object mapping | BACnetIntegration for meter AIs, relay BOs, LED BOs, MCP diagnostic BIs, DC Voltage AI
Phase D | Device metadata and vendor properties | Expanded Device object and MESA properties (network, identity, AP, time)
Phase E | RTC and logging polish | Time validity, timestamp fields, runtime summaries
Phase F (optional) | Full comm settings persistence | Writable persistent Modbus/WiFi/Ethernet configuration via BACnet/backend APIs

# 19. What Will Not Change in This Plan

- No redesign or modification of existing Web UI frontend files.
- No removal of current WiFi AP/STA setup behavior.
- No forced conversion of Web services to Ethernet path in this phase.
- No COV implementation in Phase-1 unless explicitly requested later.

# 20. Summary

This updated implementation plan provides a structured path to integrate W5500 Ethernet and BACnet/IP into the SM_GE3222M_V2 energy meter firmware while preserving current project architecture and Web UI behavior. The plan expands the BACnet Device object metadata, adds LED and diagnostic GPIO mappings, introduces a scaled DC voltage analog input, and defines a communication interface configuration and monitoring section that covers Modbus, WiFi (Station and AP), and Ethernet settings and MAC addresses.

The approach is intentionally phased to reduce risk: transport stability and SPI arbitration first, BACnet core refactor second, project mapping and metadata next, then configuration persistence and advanced features.
