Chamil1983/SM-GE3222M-Smart-Energy-Monitor/Firmware_Released/GE3222M_LCD_20x4_UI_Page_Profile.pdf

# 20x4 I2C LCD UI Page Profile GE3222M Energy Meter (ESP32)

Buttons: MODE (GPIO32), SET (GPIO33)
Version: Proposal v1.1 | Date: 14 Feb 2026

### 1. Purpose

This document defines an efficient LCD page sequence, button behavior, timing, and operating steps for a 20x4 I2C LCD integrated into the GE3222M ESP32 energy metering firmware. The goal is fast field usability, minimal flicker, safe settings access with only two buttons, and clear guidance for boot/status/error display.

### 2. Hardware Mapping

Item | Signal | Notes
LCD | 20x4 HD44780 over I2C (PCF8574) | Typical address 0x27 or 0x3F; I2C speed 100 kHz recommended
MODE Button | GPIO32 (Mode_Button) | Active-low to GND with internal pull-up; short=next page, long=menu
SET Button | GPIO33 (Set_Button) | Active-low to GND with internal pull-up; short=toggle/edit, long=save/confirm

### 3. Button Behavior

### 3.1 Press Types and Debounce

- Debounce: 40 ms (edge-based press event)
- Short press: 40 ms to 1.2 s
- Long press: >= 1.2 s
- Combo hold (MODE + SET): 3.0 s (quick action)

### 3.2 RUN Mode Actions

Input | Action
MODE short | Next page
MODE long | | Enter Settings/Menu mode (or exit back to RUN if already in menu)
SET short | | Page-specific toggle (e.g., kW/kVA/kvar)
SET long | | Page-specific confirm action (used sparingly
in RUN mode)
MODE+SET hold 3 s | | Quick Action: Reset Trip Energy (kWh trip) via confirmation screen

### 3.3 SETTINGS Mode Actions

- MODE short: move selection down / next item
- SET short: select item / enter edit / increment toggle
- SET long: save / confirm
- MODE long: exit Settings (prompts to save if there are unsaved changes)

### 4. LCD Refresh Timing and Anti-Flicker Rules

To avoid flicker on HD44780 LCDs, redraw only the lines that changed (string cache per row). Use timed refresh windows per page type and force redraw on button events.

### 4.1 Recommended Refresh Intervals

Page Type | Update Interval | Notes
Live measurements (V/I/P/PF/F) | 250-500 ms | Fast but stable; consider smoothing P and I
Energy totals / counters | 1 s | kWh changes slowly; reduces I2C traffic
Network / system health | 1-2 s | IP/MAC/heap do not need fast refresh
Settings/menu pages | Event-driven | Redraw immediately after button event

### 4.2 Screen Timeout Rules

- If no button press for 60 s in Settings, auto-return to RUN without saving (unless user confirmed save).
- If a confirmation screen is open, timeout after 15 s and cancel automatically.

### 5. RUN Mode Page Sequence (20x4 Layouts)

Pages are ordered by typical field usage. MODE short cycles through pages in a loop. Line 1 is a compact header (device + state + time).

### 5.1 Page 1: Live Summary (Default)

GE3222M RUN 12:34

V:230.4 I: 5.23A

P: 1.20kW PF:0.98

E:1234.56kWh F:50.0

Button | Behavior
MODE short | Next page
SET short | Toggle P view: kW -> kVA -> kvar (cycles)

Notes:

- Default after boot and after Settings timeout.
- If a value is invalid, display '--' placeholders.

### 5.2 Page 2: Phase Detail (L1/L2/L3 or Single Phase)

PHASE L1 (rot 2s)

V:231.2 I:3.10A

P:0.71kW PF:0.95

THD-V:2.1 THD-I:3.6

Button | Behavior

MODE short | Next page
SET short | Freeze/unfreeze phase rotation

Notes:

- If 3-phase: rotate L1/L2/L3 every 2 s unless frozen.
- If single-phase: always show L1.

### 5.3 Page 3: Energy Totals

ENERGY TOTALS

Import: 1234.56 kWh

Export: 12.34 kWh

Today: 3.21 kWh

Button | Behavior
MODE short | Next page
SET short | Toggle counter: Today -> Week -> Month
SET long | Reset selected counter (opens confirmation screen)

Notes:

- Counters are software totals derived from daily snapshots.
- If export energy is unused, show 0.00 or hide the line.

### 5.4 Page 4: Demand and Peaks

DEMAND / PEAKS

Pavg(15m): 0.95kW

Pmax Today:1.80kW

Imax Today:8.20A

Button | Behavior
MODE short | Next page
SET short | Change averaging window: 5m -> 15m -> 30m

Notes:

- Track peaks with timestamps in NVS if available.

### 5.5 Page 5: I/O Status (Relays / Inputs / Alarm)

I/O STATUS

DO:1=ON 2=OFF 3=ON 4=OFF

DI:1=0 2=1 3=0 4=0

Alarm: NONE

Button | Behavior
MODE short | Next page
SET short | Toggle view set if needed (DO1-8 <-> DO9-16)

Notes:

- RUN mode is view-only for outputs for safety.
- If outputs > 4, rotate display sets every 2 s.

### 5.6 Page 6: Network Status

NETWORK

ETH:192.168.1.50 UP

WiFi:OFF AP:OFF

VB:TCP8088 OK MQTT:OFF

Button | Behavior

MODE short | Next page
SET short | Toggle info view (IP/MAC/Ports)

Notes:

- Show one active primary link (Ethernet preferred).
- If disconnected, show DOWN + last error code.

### 5.7 Page 7: System Health

SYSTEM

Uptime: 02:15:33

Heap: 142k Min:120k

WDT:OK Log:128/200

Button | Behavior
MODE short | Next page
SET short | Clear Last Error display (if implemented)

Notes:

- Heap and min-heap are key for diagnosing resets.
- Log usage must match configured ring buffer capacity.

### 6. SETTINGS Mode (Menu + Edit + Confirm)

Settings mode is entered using MODE long press. Editing is guarded because only two buttons are available.

### 6.1 State Model

- RUN: normal operation pages
- MENU: list of categories
- EDIT: editing a field
- CONFIRM: destructive actions (hold-to-confirm)

### 6.2 Menu Layout Example

SETTINGS > NETWORK

### 1 DHCP: ON

### 2 IP: 192.168.1.50

### 3 Port: 8088 4 Back

Interaction:

- MODE short: move highlight
- SET short: toggle/select
- SET long: save (in EDIT)
- MODE long: exit (save prompt if dirty)

### 6.3 Confirmation Screen (Safety)

RESET TRIP ENERGY?

Hold SET 3s to confirm

MODE = Cancel

### 7. Step-by-Step User Operation with Timing

Step | Action | Timing | LCD Feedback
1 | Cycle pages (RUN) | MODE short (<1.2 s) | Header updates instantly; data updates per page interval
2 | Enter Settings | MODE long (>=1.2 s) | Header changes to SETTINGS; highlight item 1
3 | Navigate menu | MODE short | Highlight moves to next item
4 | Select item / edit | SET short | Enter EDIT or toggle field
5 | Save edit | SET long (>=1.2 s) | Show 'Saved' for 1 s

then return to MENU

6 | Cancel / Exit | MODE long | Return to RUN; if dirty, prompt Save/Discard
7 | Quick reset trip | MODE+SET hold 3 s | Open confirmation screen

### 8 Confirm destructive

| action | Hold SET 3 s on confirm screen | Perform action; show 'Done' for 1 s

### 8. Boot-Up LCD Display Sequence (Recommended)

A clear boot sequence helps installers confirm hardware state without a serial monitor.

Phase | LCD Lines (Example) | Duration | Notes
Splash | GE3222M BOOT FW:vX.Y Build:yyyy Init... | 800 ms | Show product + firmware version
Storage | Loading Config... NVS: OK
| 500-1500 ms | If NVS error: show NVS FAIL and continue with defaults
Meter IC | ATM90E36 Init... METER: OK
| 500-2000 ms | If fail: show SAFE MODE and continue UI/network
Network | ETH:UP 192.168.1.50 WiFi:OFF AP:OFF
| 800-1500 ms | Show active primary link
Services | WEB:80 TCP:8088 MQTT:OFF
| 800-1500 ms | Confirm VB connection port
Run | Switch to RUN page 1 Immediate | Default operational display

### 9. Error and Alarm Display Rules

When errors occur, keep the UI readable and actionable.

- Non-fatal errors: display a short message on the bottom line for 3 s, then return to normal page rendering.
- Fatal errors should be avoided; prefer SAFE MODE with network + UI available.
- Alarm present: show 'Alarm: <code>' on Page 5 and add a small '!' indicator in the header of all pages.
Condition | Message (20x4) | Display Time | Recommended Action
ATM90E36 init fail | METER FAIL SAFE MODE | Sticky | Check SPI wiring/power; allow UI/network to remain active
NVS open fail | NVS FAIL Defaults used | 3 s | Recreate namespaces; optionally erase NVS on next boot
VB link down | VB: DOWN | 3 s | Verify IP/port and client/server direction
MQTT connect fail | MQTT: FAIL | 3 s | Auto-retry in background; check broker settings

### 10. Formatting Guidelines (20 characters per line)

- Use fixed field widths to keep values aligned (e.g., 'V:230.4' and 'I: 5.23A').
- Right-align units where possible; avoid long labels.
- Use placeholders for invalid values: '--.-', '--.--', or '---' to indicate missing data.
- Avoid full-screen clears; update only the changed lines.

### 11. Implementation Notes (Recommended Firmware Structure)

- ButtonManager: debounced edge detection + long-press timers
- LCDManager: setLine(row, text) with per-row cache to avoid flicker
- UIStateMachine: RUN/MENU/EDIT/CONFIRM states
- Metering task updates a MeterSnapshot structure; UI reads snapshots only (no SPI reads in UI).

### 12. Appendix: Suggested Abbreviations

Label | Meaning

V Voltage (Vrms)

I Current (Arms)

P Active power (kW)

PF | Power factor

E Energy (kWh)

THD | Total Harmonic Distortion (%)
Pavg | Average power (demand window)
