Chamil1983/SM-GE3222M-Smart-Energy-Monitor/Pictures/Main Board.pdf

Current Transformers Can be Used:
20A/25mA SCT-006

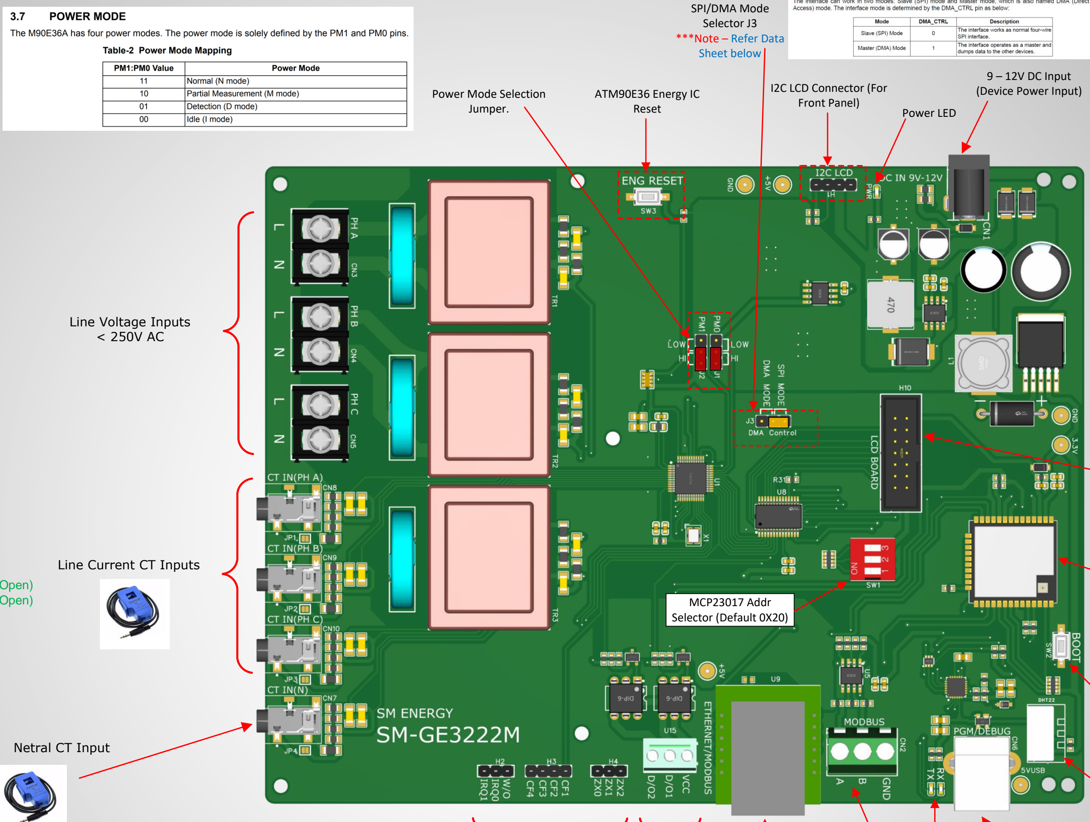
[picture p8: figure]
Line Voltage Inputs < 250V AC; Line Current CT Inputs; Netral CT Input; I2C LCD Connector (For Front Panel); 9 – 12V DC Input (Device Power Input); Power LED; ATM90E36 Energy IC Reset; SPI/DMA Mode Selector J3 ***Note – Refer Data Sheet below; Power Mode Selection Jumper.; MCP23017 Addr Selector (Default 0X20)

30A/1V SCT-013-030 (JP1,JP2 and JP3 jumper Should be Open) 50A/1V SCT-013-050 (JP1,JP2 and JP3 jumper Should be Open) 80A/26.6mA SCT-010
100A/50mA SCT-013-000
120A/40mA: SCT-016
200A/100mA SCT-024
200A/50mA SCT-024

*** Note: JP1,JP2 and JP3 jumper Links Should be open When using Voltage output type current sensors. For Current Output types above jumpers should be shorted.

ATM90E36 Interrupts
For External System
Refer Data Sheet below

*** Note: Refer Atmel M90E36A Datasheet for more information.Use the Link below https://ww1.microchip.com/downloads/en/DeviceDoc/Atmel-46004-SE-M90E36A-Datasheet.pdf

Meter Digital Outputs
For External System
***VCC < 80V DC

USB Connector (Programming and Debugging With Arduino) MODBUS Connector

Ethernet/MODBUS Interface
Connector
Can be configured with ARDUINO or Meter software

USB TX/RX Status
LEDs

DHT22 Temperature
and Humidity Sensor

ESP32 GPIO0
Boot (Programming/
Firmware Update)

ESP32 Module

Front Panel IDC
connector

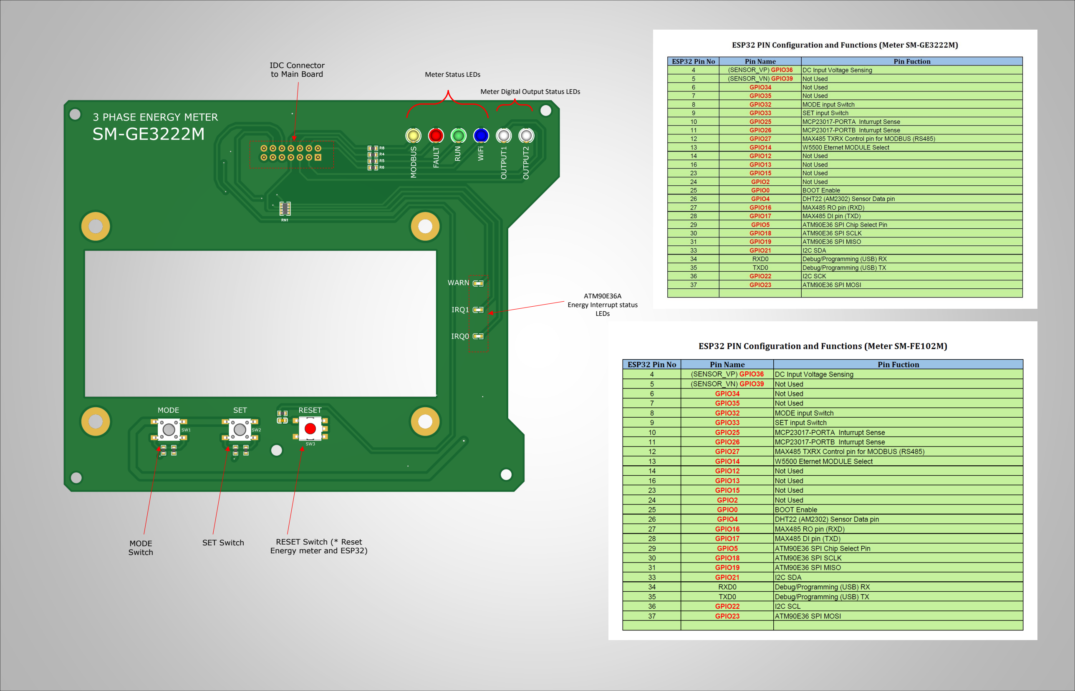
[picture p9: page 2]

MODE
Switch
SET Switch | RESET Switch (* Reset Energy meter and ESP32)

ATM90E36A
Energy Interrupt status
LEDs

IDC Connector
to Main Board | Meter Status LEDs

Meter Digital Output Status LEDs
