Chamil1983/SM-GE3222M-Smart-Energy-Monitor/Pictures/3D_PCB_Energy Meter SM-GE3222M V1.0_2024-06-16.png

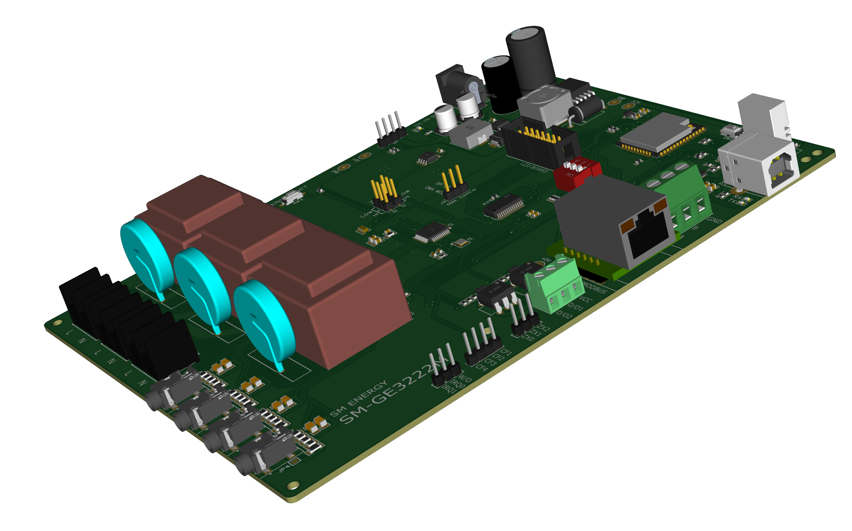
Pictures/3D_PCB_Energy Meter SM-GE3222M V1.0_2024-06-16.png
