Chamil1983/SM-GE3222M-Smart-Energy-Monitor/Pictures/3D_PCB_SM-GE3222M Front Panel_1.png

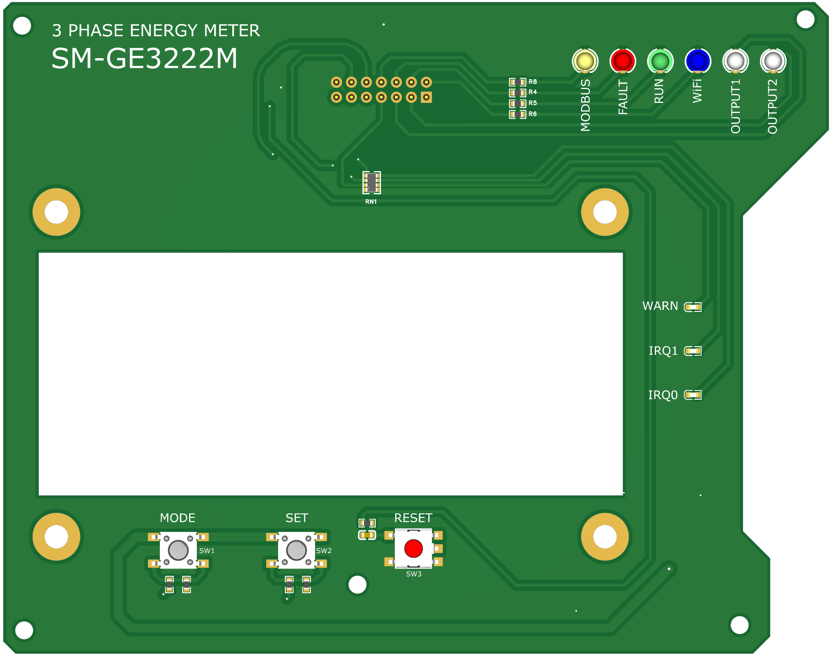
Pictures/3D_PCB_SM-GE3222M Front Panel_1.png
