Chamil1983/SM-GE3222M-Smart-Energy-Monitor/Pictures/20240523_065521.jpg

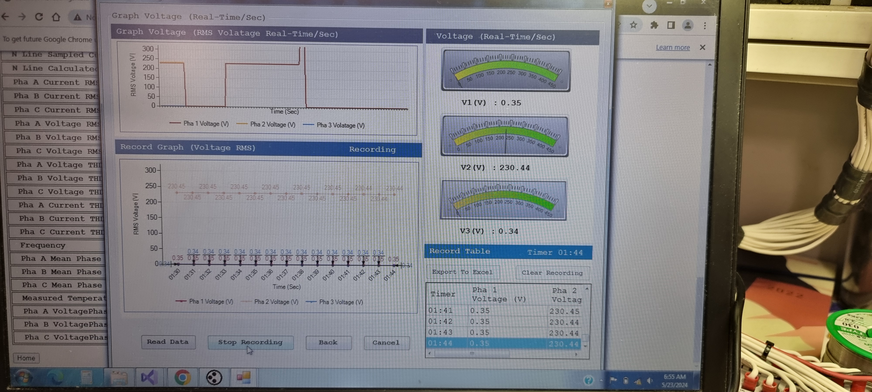
Pictures/20240523_065521.jpg
