Chamil1983/SM-GE3222M-Smart-Energy-Monitor/Pictures/ESP32 Pin Config.png

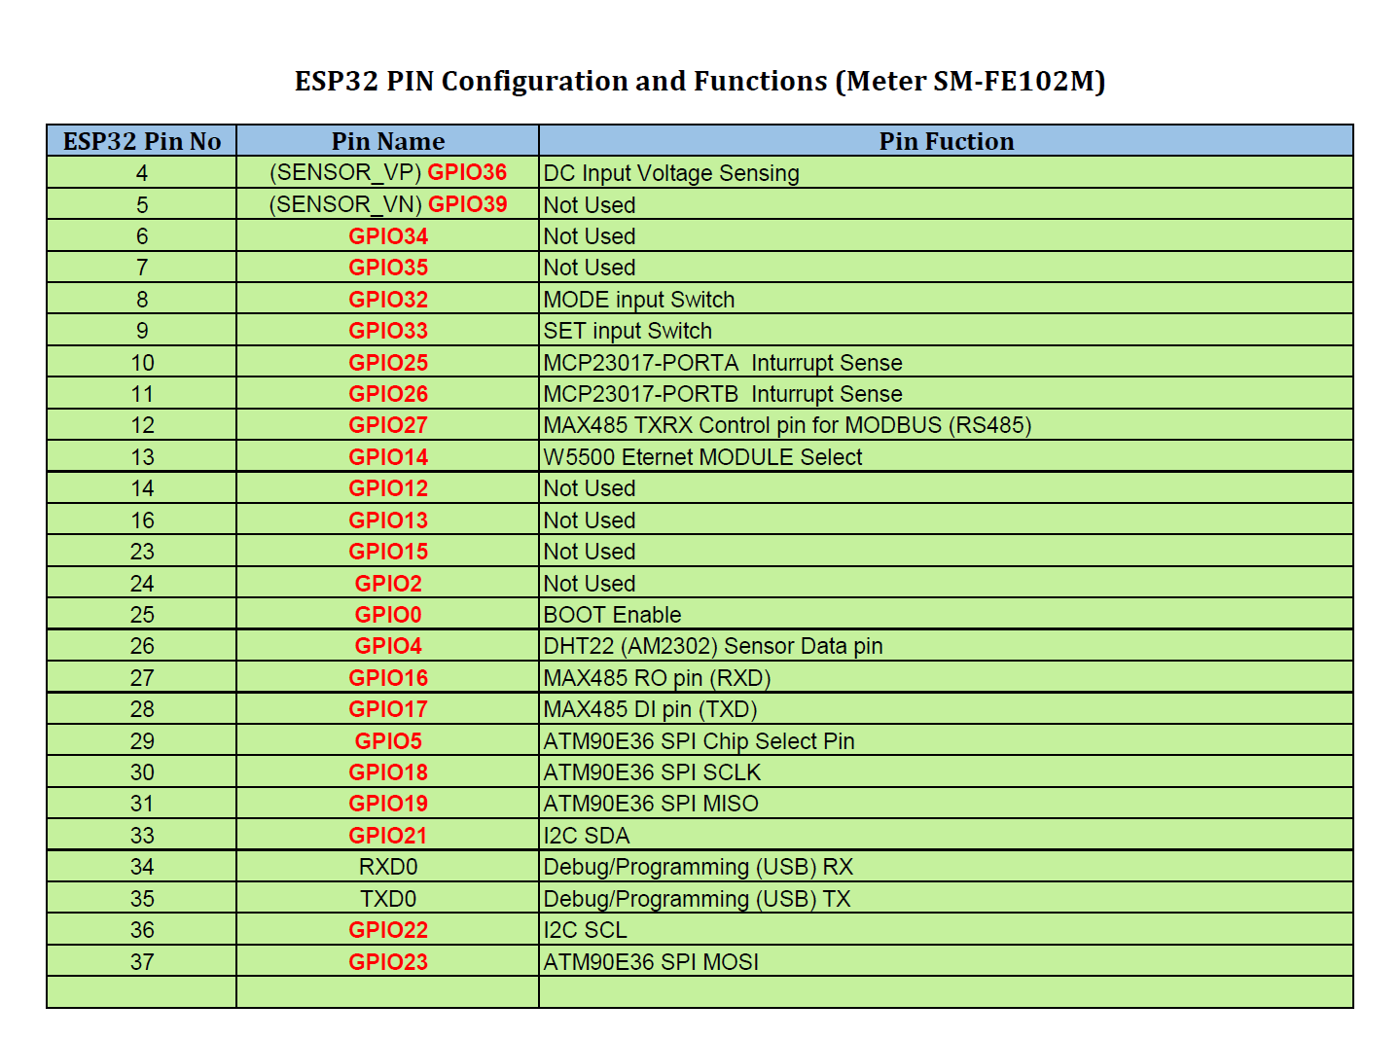
Pictures/ESP32 Pin Config.png
