Chamil1983/SM-GE3222M-Smart-Energy-Monitor/Pictures/IMG_1.jpg

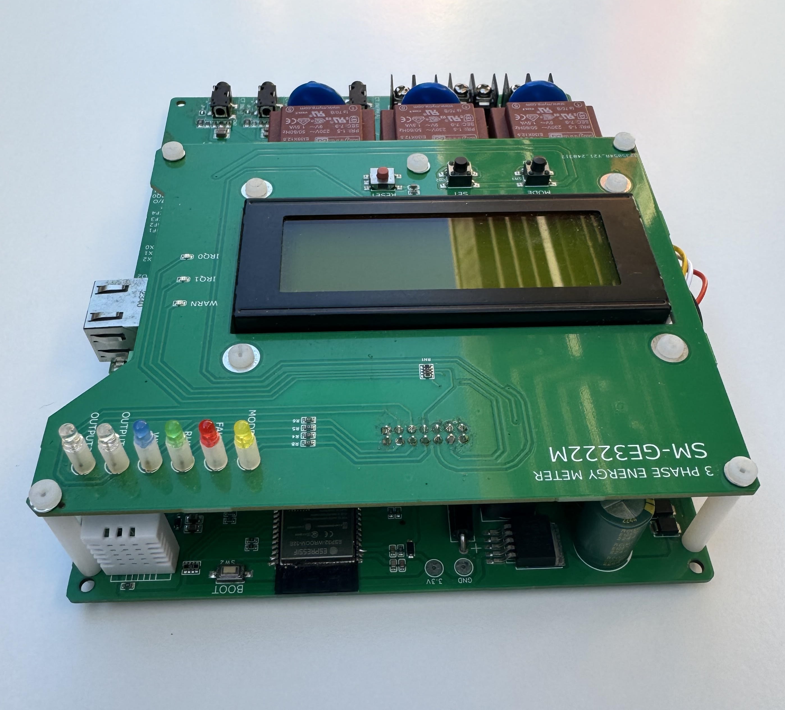
Pictures/IMG_1.jpg
