Chamil1983/SM-GE3222M-Smart-Energy-Monitor/Pictures/IMG_2.jpg

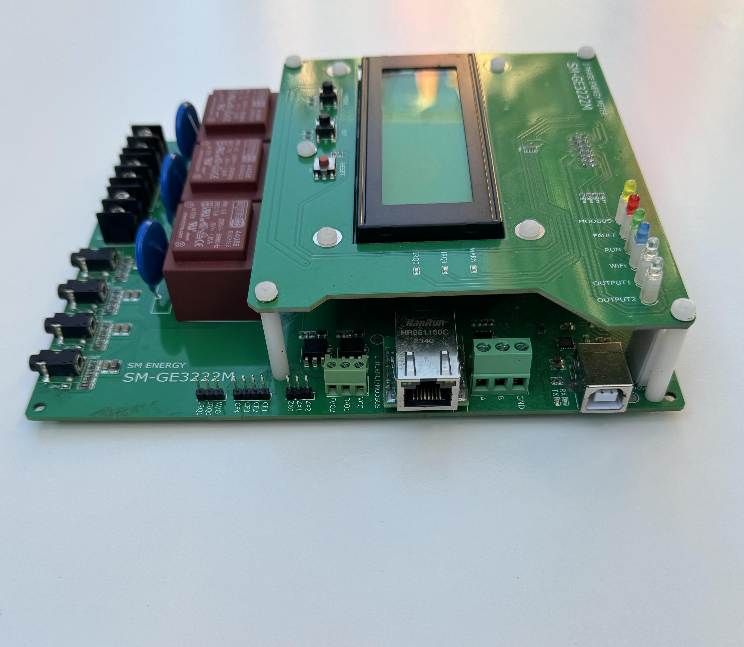
Pictures/IMG_2.jpg
