Chamil1983/SM-GE3222M-Smart-Energy-Monitor/Pictures/IMG_4783.jpg

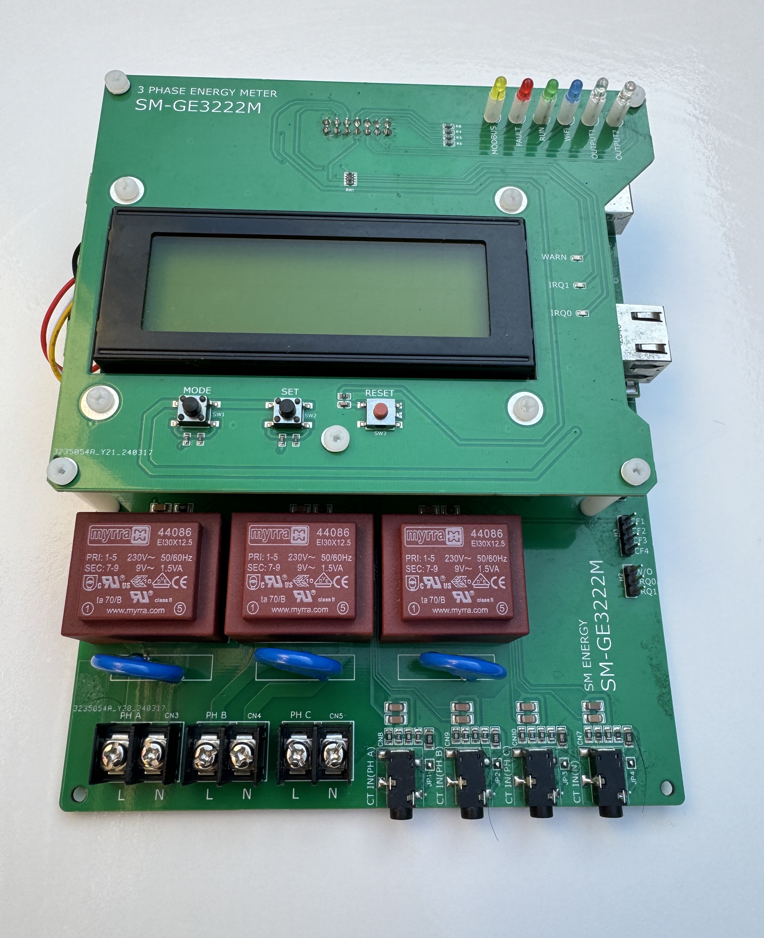
Pictures/IMG_4783.jpg
