Chamil1983/SM-GE3222M-Smart-Energy-Monitor/Pictures/IMG_4796.jpg

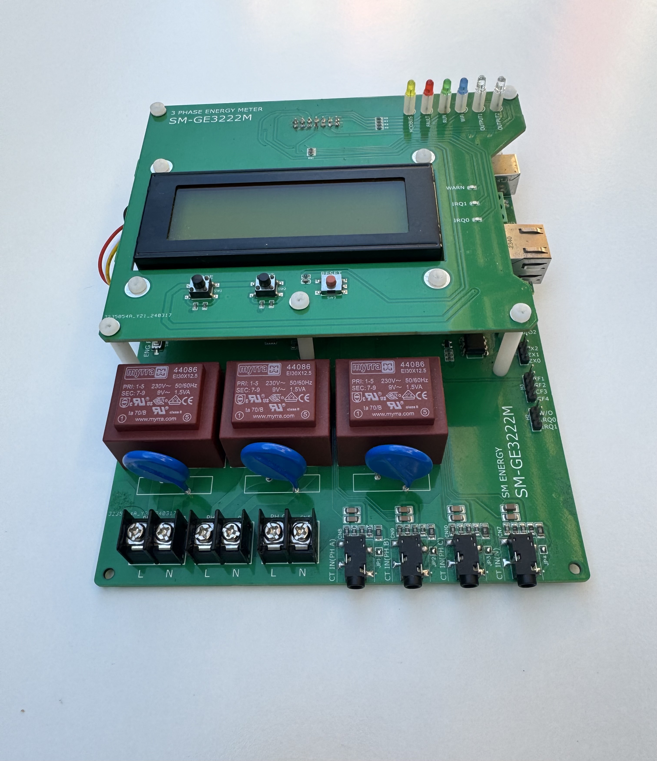
Pictures/IMG_4796.jpg
