Chamil1983/SM-GE3222M-Smart-Energy-Monitor/Pictures/M90E36A POWER MODE.png

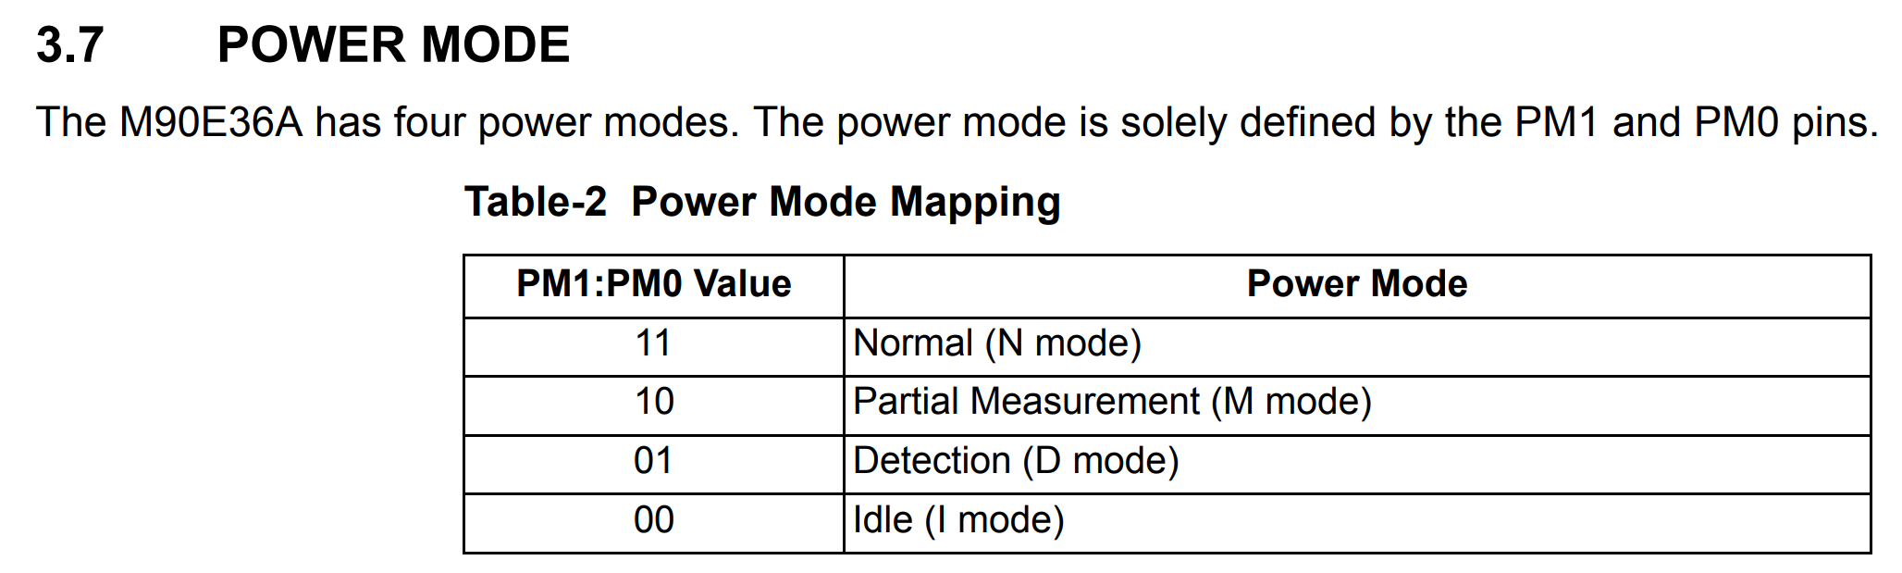
Pictures/M90E36A POWER MODE.png
