Chamil1983/SM-GE3222M-Smart-Energy-Monitor/Pictures/MCP23017 Configurations.jpg

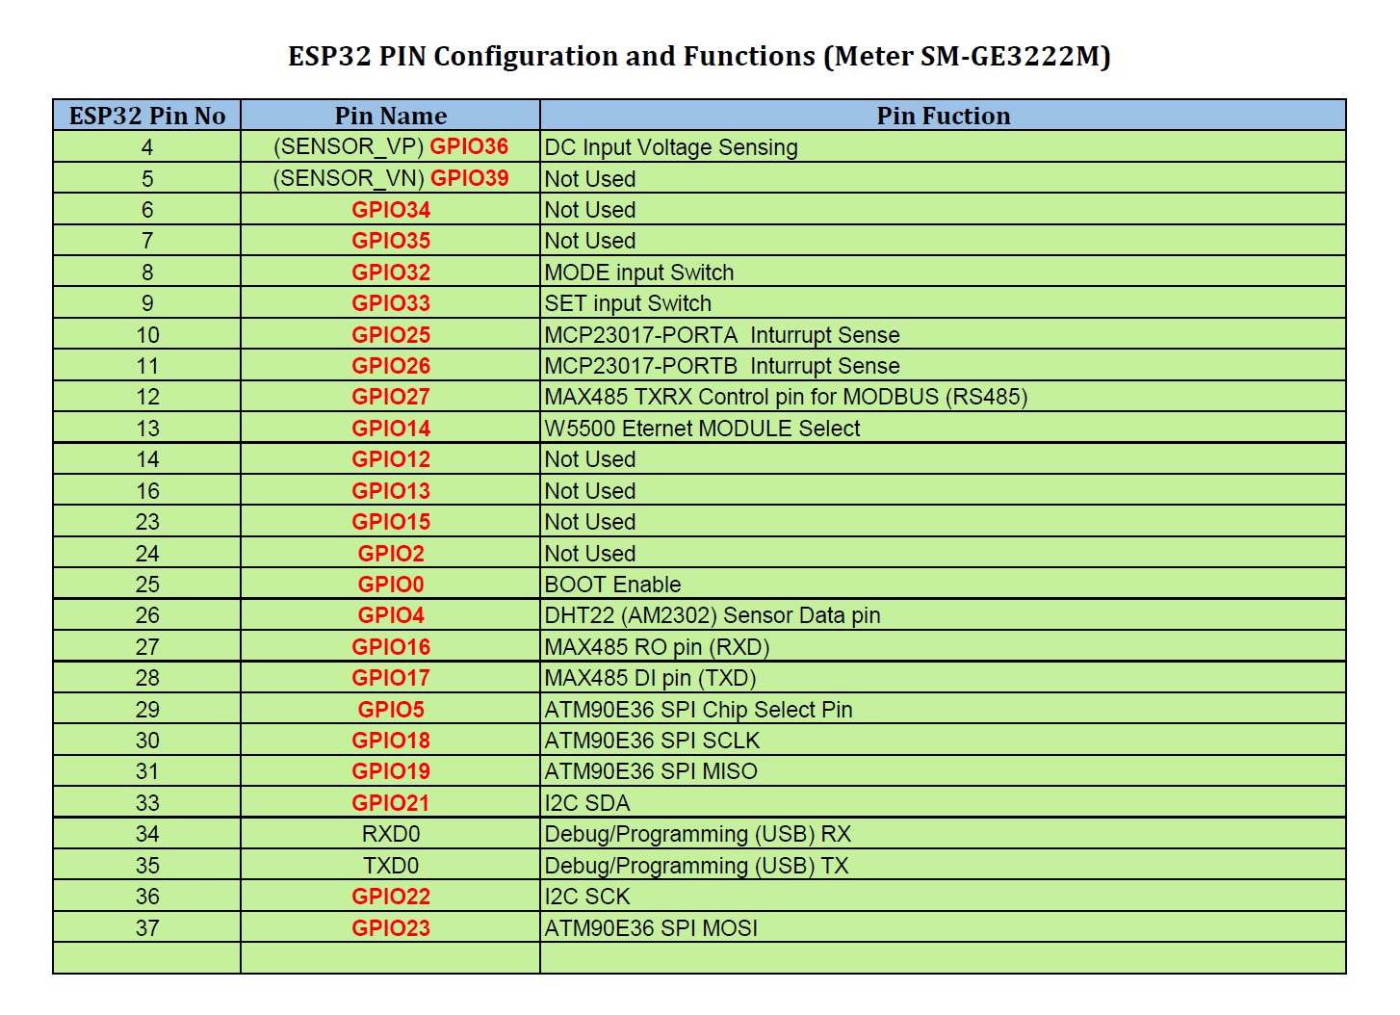
Pictures/MCP23017 Configurations.jpg
