Chamil1983/SM-GE3222M-Smart-Energy-Monitor/Pictures/SPI_ DMA INTERFACE.png

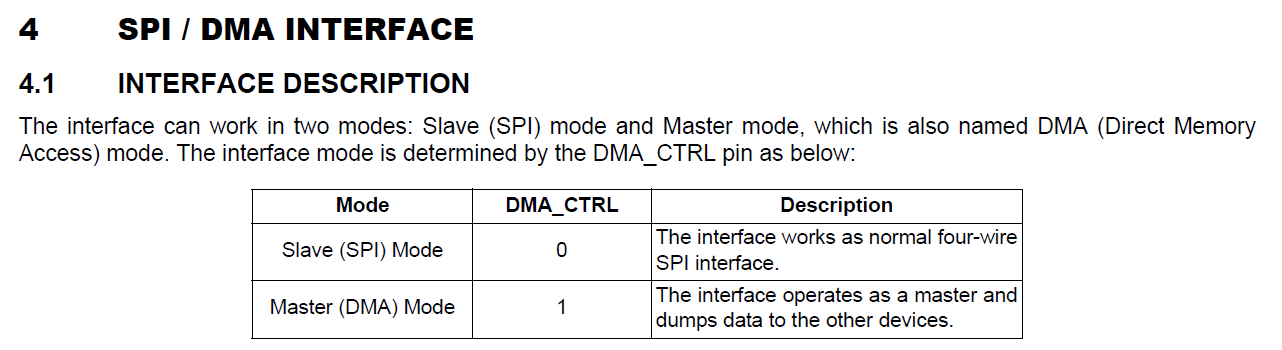
Pictures/SPI_ DMA INTERFACE.png
