Chamil1983/SM-GE3222M-Smart-Energy-Monitor/Health, Safety, and Production Improvement Framework for an Electronic Relay Manufacturing Facility.docx

# Health, Safety, and Production Improvement Framework for an RMS Production Facility

## Executive summary

This report synthesizes Australian work health and safety (WHS) guidance and relevant IEC/ISO/AS/NZS standards into a practical control framework for an electronic relay manufacturing site with a Relay Testing Center (ATEs, high-voltage/high-current supplies, HV test sets, instruments), multiple assembly areas (relay, PCB, case), a loading section, and an isolated machine area. The highest-consequence risks typically sit in the Testing Center (electric shock, arc flash/arc blast, stored energy, and inadvertent energization) and in the machine area (unguarded motion, entanglement/crush, unexpected startup). A robust baseline is built around: (1) prohibiting energized electrical work unless tightly justified and controlled; (2) formal isolation/Lockout-Tagout (LOTO) that controls all hazardous energy, including capacitor banks and stored energy; and (3) engineered guarding/interlocks and reliable emergency stop (E‑stop) systems. [1] (https://www.safeworkaustralia.gov.au/system/files/documents/1810/model-cop-managing-electrical-risks-in-the-workplace.pdf)

For manufacturing reliability and measurement integrity, electromagnetic compatibility (EMC) matters in two ways: regulatory emissions compliance in Australia (EMC regulatory arrangements and mandated standards) and site-level electromagnetic interference (EMI) that can create false failures, intermittent ATE faults, nuisance trips, or unsafe control behavior. IEC’s product-family EMC standard for measurement/test/control equipment provides a strong technical reference point for instrument immunity and emissions expectations, while Australia’s ACMA framework focuses on limiting interference risk and mandating emissions requirements. [2] (https://webstore.iec.ch/en/publication/62793)

Production improvements that also strengthen safety include: standardized test benches and fixtures (reducing setup variability), preventive maintenance and calibration discipline (reducing downtime and retest loops), digitized test logs/traceability (faster fault triage), and structured Lean methods (5S workplace organization, SMED/quick changeover, poka‑yoke mistake-proofing) to reduce wasted motion, rework, and defect escapes. [3] (https://www.standards.org.au/blog/spotlight-on-in-service-safety-inspection-and-testing-of-electrical-equipment-and-rcds)

Assumptions: shift patterns, staffing numbers, equipment models, specific relay families, and current control maturity are unknown; recommendations are therefore structured as a “controls blueprint” that should be finalized through site risk assessment, verification testing, and competency-based authorization. [4] (https://www.safeworkaustralia.gov.au/sites/default/files/2024-11/model_code_of_practice-how_to_manage_work_health_and_safety_risks-nov24.pdf)

## Standards and regulatory sources

Australian WHS expectations are typically implemented through jurisdictional WHS laws and supporting Codes of Practice. Codes of Practice are practical guidance for meeting WHS duties and are commonly referenced by regulators and may be used as evidence of what is known and “reasonably practicable” in court proceedings. [5] (https://www.safeworkaustralia.gov.au/system/files/documents/1810/model-cop-managing-electrical-risks-in-the-workplace.pdf)

Key WHS Codes and regulator guidance relevant to this facility profile include: - Electrical risk controls and limits on energized electrical work: Managing electrical risks in the workplace (model Code of Practice). [6] (https://www.safeworkaustralia.gov.au/system/files/documents/1810/model-cop-managing-electrical-risks-in-the-workplace.pdf)
- Plant, guarding, interlocks, E‑stops, and isolation/LOTO expectations: Managing the risks of plant in the workplace (Code of Practice, incl. explicit lock-out process steps and emergency stop characteristics). [7] (https://www.safeworkaustralia.gov.au/sites/default/files/2023-12/dec_2023_-_code_of_practice_-_managing_the_risks_of_plant_in_the_workplace.pdf)
- Chemical management, SDS, labeling, storage, and exposure control: Managing the risks of hazardous chemicals in the workplace (Code of Practice). [8] (https://www.safeworkaustralia.gov.au/sites/default/files/2023-06/model_code_of_practice_managing_the_risks_of_hazardous_chemicals_in_the_workplace.pdf)
- Ergonomics/manual handling risk management: Hazardous manual tasks (Code of Practice). [9] (https://www.safeworkaustralia.gov.au/system/files/documents/1905/model-cop-hazardous-manual-tasks.pdf)
- General WHS risk management and hierarchy of controls: How to manage work health and safety risks (Code of Practice). [10] (https://www.safeworkaustralia.gov.au/sites/default/files/2024-11/model_code_of_practice-how_to_manage_work_health_and_safety_risks-nov24.pdf)
- Emergency planning and preparedness: emergency plan expectations and typical emergency types. [11] (https://www.safeworkaustralia.gov.au/system/files/documents/1702/emergency_plans_fact_sheet.pdf)
- Training/competency duty for PCBUs: requirement to provide information, training, instruction, and supervision. [12] (https://www.safeworkaustralia.gov.au/safety-topic/managing-health-and-safety/training-and-supporting-your-workers-stay-safe-work)
- Incident notification duties: notifiable incident guidance (model WHS Act). [13] (https://www.safeworkaustralia.gov.au/safety-topic/managing-health-and-safety/incident-notification/incident-notification-requirements-under-model-whs-act)

Technical standards most relevant to the described equipment mix (prioritizing Australian/IEC/ISO/AS/NZS) include: - AS/NZS 3000 (Wiring Rules) as the core technical rule set for electrical installation design, construction, and verification (earthing/bonding foundations for safe operation). [14] (https://www.standards.org.au/flagship-projects/wiring-rules?utm_source=chatgpt.com)
- AS/NZS 4836 for safe working on/near low-voltage and extra-low voltage installations/equipment, explicitly addressing hazards such as arc flash/arc blast and electric shock (useful for procedures, risk assessment expectations, and PPE selection logic). [15] (https://store.standards.org.au/product/as-nzs-4836-2023?utm_source=chatgpt.com)
- AS/NZS 3760 for in-service inspection/testing of electrical equipment and RCDs (test-and-tag approach, competency expectations, records). [16] (https://www.standards.org.au/blog/spotlight-on-in-service-safety-inspection-and-testing-of-electrical-equipment-and-rcds)
- Safety of machinery / machine guarding and controls (AS/NZS 4024 series) as the primary reference family aligned to ISO/EN machinery safety expectations. [17] (https://store.standards.org.au/product/as-nzs-4024-2019-series?utm_source=chatgpt.com)
- Safety signage standard (AS 1319) to standardize warning/prohibition/mandatory/emergency information signs in the occupational environment. [18] (https://www.worksafe.act.gov.au/health-and-safety-portal/managing-safety/signage)
- Fire and emergency standards frequently referenced in facilities: AS 3745 (emergency planning/evacuation control concepts) plus related servicing and extinguisher placement standards AS 1851 and AS 2444. [19] (https://www.standards.org.au/standards-catalogue/standard-details?designation=as-3745-2010)
- IEC 61010-1 for safety requirements of electrical measurement/test/control/lab equipment—highly relevant to benches, ATE racks, and HV test instrumentation selection and safe integration. [20] (https://webstore.iec.ch/en/publication/4279)
- IEC 61326-1 as the EMC requirements baseline for electrical measurement/test/control/lab equipment (immunity + emissions expectations at the equipment level). [21] (https://webstore.iec.ch/en/publication/62793)
- Australian EMC regulatory context: Australia’s framework to minimize unintended interference, supported by ACMA mandated standards lists and compliance requirements (emissions-focused). [22] (https://www.acma.gov.au/sites/default/files/2025-09/EVC%20Code%20of%20Practice%20for%20EMC.pdf)
- IEC 61340-5-1 for an ESD control program across manufacturing/assembly/test/handling of ESDS items (program requirements and verification concepts). [23] (https://webstore.iec.ch/en/publication/74748)
- Management systems that make improvements “stick”: AS/NZS ISO 45001 for OH&S management systems and AS/NZS ISO 9001 for quality management systems; ISO/IEC 17025 for calibration/testing competence principles (useful even if not seeking accreditation). [24] (https://www.standards.org.au/standards-catalogue/standard-details?designation=as-nzs-iso-45001-2018)

Named sources referenced in this section: Safe Work Australia[25] (https://www.worksafe.wa.gov.au/system/files/migrated/sites/default/files/atoms/files/guide-soldering_and_rosin_fluxes.pdf), Standards Australia[26] (https://www.standards.org.au/blog/spotlight-on-in-service-safety-inspection-and-testing-of-electrical-equipment-and-rcds), International Electrotechnical Commission[27] (https://www.acma.gov.au/sites/default/files/2025-09/EVC%20Code%20of%20Practice%20for%20EMC.pdf), International Organization for Standardization[28] (https://www.safeworkaustralia.gov.au/sites/default/files/2023-06/model_code_of_practice_managing_the_risks_of_hazardous_chemicals_in_the_workplace.pdf), Australian Communications and Media Authority[29] (https://www.standards.org.au/blog/spotlight-on-in-service-safety-inspection-and-testing-of-electrical-equipment-and-rcds), WorkSafe Victoria[30] (https://www.safeworkaustralia.gov.au/sites/default/files/2023-12/dec_2023_-_code_of_practice_-_managing_the_risks_of_plant_in_the_workplace.pdf), WorkSafe Queensland[31] (https://www.safeworkaustralia.gov.au/system/files/documents/1810/model-cop-managing-electrical-risks-in-the-workplace.pdf), Energy Safe Victoria[32] (https://www.iso.org/ISO-IEC-17025-testing-and-calibration-laboratories.html?utm_source=chatgpt.com), National Association of Testing Authorities[33] (https://www.safeworkaustralia.gov.au/system/files/documents/1702/emergency_plans_fact_sheet.pdf). [34] (https://www.acma.gov.au/sites/default/files/2025-09/EVC%20Code%20of%20Practice%20for%20EMC.pdf)

## Hazard profile by area

The facility layout described implies multiple risk “zones” with different dominant hazards. A core analytical point is that controls should be zoned and layered: eliminate/minimize risk via engineering controls first (enclosures, interlocks, guarding, isolation) and then reinforce with administrative controls and PPE under a formal risk management process. [35] (https://www.safeworkaustralia.gov.au/safety-topic/managing-health-and-safety/identify-assess-and-control-hazards/managing-risks)

Relay Testing Center (ATE + HV/HV current supplies + instruments): - Dominant hazards: electric shock, arc flash/arc blast exposure, and stored-energy discharge events (capacitors, internal energy storage in power supplies, and energized conductors or fixtures). The model electrical risks code emphasizes prohibiting energized electrical work except in limited circumstances and treating exposed parts as energized until isolated and proven otherwise, with high-voltage exposed parts earthed after de-energization. [36] (https://www.safeworkaustralia.gov.au/system/files/documents/1810/model-cop-managing-electrical-risks-in-the-workplace.pdf)
- High reliability controls depend on preventing inadvertent re-energization and aligning test/fault-finding practices to “de-energized first” wherever feasible. [36] (https://www.safeworkaustralia.gov.au/system/files/documents/1810/model-cop-managing-electrical-risks-in-the-workplace.pdf)
- Instrumentation safety expectations (design + integration) are well anchored by IEC 61010-1 for measurement/test/control equipment. [20] (https://webstore.iec.ch/en/publication/4279)

Relay/PCB/Case assembly areas: - Dominant hazards: ESD damage risk (quality loss and rework), soldering fumes (especially rosin/colophony flux fume leading to irritation/asthma risk), burns from hot tools, and use of solvents/cleaners/adhesives requiring SDS-based control. [37] (https://webstore.iec.ch/en/publication/74748)
- Engineering ventilation (local exhaust ventilation at source) is a widely recommended control to reduce airborne contaminant exposure, with regulator guidance explaining LEV as an engineering control that captures contaminants at source. [38] (https://www.worksafe.qld.gov.au/safety-and-prevention/creating-safe-work/managing-risks/local-exhaust-ventilation-lev)

Isolated machine area (plant/machinery): - Dominant hazards: moving parts (entanglement, crush, shear, pinch), unplanned movement, and unexpected startup. The plant code provides explicit guidance for interlocked guards (prevent operation until closed, optionally locked with delay), perimeter guarding, and E‑stop requirements (prominent, durable marking, immediate accessibility, red actuator, and behavior that avoids restart on reset). [39] (https://www.safeworkaustralia.gov.au/sites/default/files/2023-12/dec_2023_-_code_of_practice_-_managing_the_risks_of_plant_in_the_workplace.pdf)
- Isolation/LOTO is critical: the plant code’s lock-out process explicitly includes identifying all energy sources, isolating, controlling stored energy, locking isolation points, tagging, and “try/test” to verify isolation. [40] (https://www.safeworkaustralia.gov.au/sites/default/files/2023-12/dec_2023_-_code_of_practice_-_managing_the_risks_of_plant_in_the_workplace.pdf)

Loading/dispatch area: - Dominant hazards typically include manual handling strain, collision/impact risks, and mixed pedestrian-material flow. The hazardous manual tasks code sets expectations for identifying and managing tasks that can cause musculoskeletal disorders. [9] (https://www.safeworkaustralia.gov.au/system/files/documents/1905/model-cop-hazardous-manual-tasks.pdf)

EMI/EMC as a cross-cutting risk to safety + productivity: - EMI can degrade measurement integrity (false fails, intermittent faults) and can also affect control electronics if immunity is inadequate. IEC 61326-1 provides the baseline EMC framework for measurement/test/control equipment (immunity + emissions). [21] (https://webstore.iec.ch/en/publication/62793)
- Australia’s EMC arrangements (administered by ACMA) are structured to minimize the risk of unintentional electromagnetic interference impacting other devices or radiocommunications, with mandated standards lists and compliance/record concepts. [41] (https://www.acma.gov.au/sites/default/files/2025-09/EVC%20Code%20of%20Practice%20for%20EMC.pdf)

## Health and safety improvement factors for safety meeting

These are intentionally brief, meeting-ready points (action-oriented). They are written to map directly to common WHS expectations for electrical work, plant safety, storage/chemicals, emergency readiness, and competency/authorization. [42] (https://www.safeworkaustralia.gov.au/system/files/documents/1810/model-cop-managing-electrical-risks-in-the-workplace.pdf)

- HV & high-current controls
- Define a dedicated HV test zone (controlled access, barriers, marked floor boundary, warning beacons).
- Confirm interlocked test enclosures: no energization with doors open; forced discharge when opened (where practicable).
- Add/verify visible “HV ON” indicators and “test in progress” status at entry points.
- Implement stored-energy control: discharge tools, bleed resistors where appropriate, and “verify zero energy” steps before contact.
- Require 2-person rule or spotter for defined HV/high-energy tasks (risk-based criterion).
- Standardize finger-safe connectors, shrouded leads, correct CAT ratings, and routine inspection of test leads/tools. [43] (https://webstore.iec.ch/en/publication/4279)
- LOTO and prevention of unintended energization
- Deploy a single LOTO procedure standard across plant + test center (electrical, pneumatic, hydraulic, gravity, springs, capacitor banks).
- Use a verified lock-out sequence: stop → identify energy → isolate → control stored energy → lock → tag → “try/test” → work. [40] (https://www.safeworkaustralia.gov.au/sites/default/files/2023-12/dec_2023_-_code_of_practice_-_managing_the_risks_of_plant_in_the_workplace.pdf)
- Enforce that tags are informational and are not a substitute for locks. [44] (https://www.safeworkaustralia.gov.au/sites/default/files/2023-12/dec_2023_-_code_of_practice_-_managing_the_risks_of_plant_in_the_workplace.pdf)
- Ensure only the applier (or controlled supervisory process) removes locks/tags. [45] (https://www.safeworkaustralia.gov.au/sites/default/files/2023-12/dec_2023_-_code_of_practice_-_managing_the_risks_of_plant_in_the_workplace.pdf)
- Interlocks, E-stops, guarding, and machine-area controls
- Audit all guards: fixed guards, interlocked doors/gates, and any presence-sensing devices—no bypassing.
- Validate E‑stops: prominent, durable marking, red actuator, immediately accessible; reset does not restart. [46] (https://www.safeworkaustralia.gov.au/sites/default/files/2023-12/dec_2023_-_code_of_practice_-_managing_the_risks_of_plant_in_the_workplace.pdf)
- Introduce a “machine area entry” rule: LOTO + verified stop before access beyond guarding. [47] (https://www.safeworkaustralia.gov.au/sites/default/files/2023-12/dec_2023_-_code_of_practice_-_managing_the_risks_of_plant_in_the_workplace.pdf)
- Signage and visual safety controls
- Standardize safety signs (danger/warning/mandatory/emergency) to AS 1319 conventions and apply consistently at HV zones, machine area, chemical storage, and emergency gear points. [18] (https://www.worksafe.act.gov.au/health-and-safety-portal/managing-safety/signage)
- PPE and task-based authorization
- Define minimum PPE by zone (testing / assembly / machine / loading) and task (HV switching, fault-finding, soldering, chemical handling).
- Require PPE selection to be task + risk based, aligned to electrical work guidance and documented in SWMS where applicable. [48] (https://www.worksafe.vic.gov.au/preventing-electric-shocks-electricians)
- RCDs, earthing/bonding, and electrical installation integrity
- Confirm protective earthing/bonding integrity and correct installation control (Wiring Rules foundations).
- Implement/refresh RCD testing: regular tests by a competent person and record retention. [49] (https://www.safeworkaustralia.gov.au/system/files/documents/1702/electrical-risks.pdf)
- Instrument calibration, test-and-tag, and equipment integrity
- Reinforce AS/NZS 3760-based inspection/testing framework for portable equipment and RCDs; ensure tags show test/next test; keep records. [16] (https://www.standards.org.au/blog/spotlight-on-in-service-safety-inspection-and-testing-of-electrical-equipment-and-rcds)
- Establish calibration governance for bench standards/meters/ATE measurement chains (traceability and competence principles). [50] (https://www.iso.org/ISO-IEC-17025-testing-and-calibration-laboratories.html?utm_source=chatgpt.com)
- EMI/EMC mitigation and periodic EMI testing
- Perform baseline/periodic EMI surveys in the Testing Center (radiated + conducted checks) and after major layout/equipment changes.
- Apply wiring/cabling discipline: segregate power vs signal, improve shielding/bonding, reduce ground loops, and add filtering where needed.
- Tie instrument immunity expectations to IEC 61326-1 (measurement/test/control equipment EMC) and ensure internal controls support reliable test results. [51] (https://webstore.iec.ch/en/publication/62793)
- ESD controls (PCB + relay assembly + test fixtures)
- Implement an ESD control program aligned to IEC 61340-5-1: defined EPA zones, grounding, verification testing, packaging controls, and audits. [23] (https://webstore.iec.ch/en/publication/74748)
- Soldering fumes, LEV, and chemicals
- Verify fume extraction at source for soldering/rework; prioritize LEV capture close to the work. [38] (https://www.worksafe.qld.gov.au/safety-and-prevention/creating-safe-work/managing-risks/local-exhaust-ventilation-lev)
- Address rosin/colophony fume hazards explicitly (health impacts and controls for frequent soldering). [52] (https://www.worksafe.wa.gov.au/system/files/migrated/sites/default/files/atoms/files/guide-soldering_and_rosin_fluxes.pdf)
- Confirm SDS availability, labeling, storage segregation, and spill readiness for all hazardous chemicals/cleaners/fluxes. [8] (https://www.safeworkaustralia.gov.au/sites/default/files/2023-06/model_code_of_practice_managing_the_risks_of_hazardous_chemicals_in_the_workplace.pdf)
- Ergonomics and manual handling
- Run a manual-task risk review: bench height, reach distances, repetitive assembly motions, loading lift points, and tool balancing. [9] (https://www.safeworkaustralia.gov.au/system/files/documents/1905/model-cop-hazardous-manual-tasks.pdf)
- Fire safety, emergency response, and first aid
- Review emergency plan coverage (fire, chemical incident, medical emergency, rescue scenarios) and drill schedule. [53] (https://www.safeworkaustralia.gov.au/system/files/documents/1702/emergency_plans_fact_sheet.pdf)
- Confirm extinguisher selection/location (AS 2444) and servicing regime (AS 1851). [54] (https://store.standards.org.au/product/as-2444-2001?utm_source=chatgpt.com)
- Reinforce first-aid response expectations: ensure electrical shock incidents trigger prompt medical assessment guidance and safe scene management. [55] (https://www.anzcor.org/home/basic-life-support/guideline-2-managing-an-emergency/downloadpdf)
- Training, authorization, and visitor/contractor induction
- Define “who is authorized” for HV testing, energized fault-finding, machine-area intervention, and chemical handling; enforce competency refreshers. [56] (https://www.safeworkaustralia.gov.au/safety-topic/managing-health-and-safety/training-and-supporting-your-workers-stay-safe-work)
- Enforce visitor/contractor induction with zone restrictions and escort rules in HV and machine areas (duty of care + risk management). [57] (https://www.safeworkaustralia.gov.au/sites/default/files/2024-11/model_code_of_practice-how_to_manage_work_health_and_safety_risks-nov24.pdf)
- Incident reporting and learning system
- Refresh notifiable incident decision logic and internal near-miss reporting workflow; publish “how to report” and close-the-loop timelines. [58] (https://www.safeworkaustralia.gov.au/sites/default/files/2022-09/Incident-notification-fact-sheet-2015%20UD.PDF)

## Production improvement factors

Production gains are most durable when they reduce variation and increase first-pass yield, not when they simply push speed. Many of the items below also reduce safety exposure by shortening time spent in hazardous states (e.g., less time in active HV test, fewer troubleshooting cycles, fewer rework solder operations). [59] (https://www.safeworkaustralia.gov.au/safety-topic/managing-health-and-safety/identify-assess-and-control-hazards/managing-risks)

Testing Center throughput and reliability - Standardize test benches and rack layouts: same connector conventions, labeled leads, consistent instrument positioning, and standardized safety barriers (reduces setup errors and accelerates training). (Alignment with structured in-service equipment management supports reliability.) [60] (https://www.standards.org.au/blog/spotlight-on-in-service-safety-inspection-and-testing-of-electrical-equipment-and-rcds)
- Quick-change fixtures using SMED concepts: convert setup steps to external/offline tasks, simplify remaining steps, and target “single-digit minute” changeover where feasible. [61] (https://www.lean.org/lexicon-terms/single-minute-exchange-of-die/?utm_source=chatgpt.com)
- Workflow separation: explicitly segment Pre-test → Full-test → Fault diagnosis lanes; minimize “context switching” at ATE stations. - Preventive maintenance for ATE/HV gear: planned downtime beats unplanned downtime; include cable/connector wear and interlock verification in PM checklists. [62] (https://www.safeworkaustralia.gov.au/sites/default/files/2023-12/dec_2023_-_code_of_practice_-_managing_the_risks_of_plant_in_the_workplace.pdf)
- Digitized test logs and auto-capture (where feasible): attach test result + instrument ID + firmware/version + operator + fixture ID to each serial number; accelerates root cause analysis and reduces repeat testing. (Strengthens traceability consistent with quality system principles.) [63] (https://www.iso.org/standard/62085.html?utm_source=chatgpt.com)
- Spare critical instruments / spare fixture parts: create a small “hot spares” policy for high-failure/high-impact items (meters, HV probes/leads, contactors, ATE I/O cards) to avoid downtime cascades.

Assembly, PCB, and case build performance - Implement 5S (Sort, Straighten/Set in order, Shine, Standardize, Sustain; often extended with Safety): improves search time, reduces mix-ups, supports safer and more predictable work. [64] (https://www.lean.org/lexicon-terms/five-s/?utm_source=chatgpt.com)
- Add poka‑yoke features on common defect modes: connector keying, polarity enforcement, torque-limited drivers with verification, fixture-based orientation controls, and label/part mismatch checks. [65] (https://asq.org/quality-resources/mistake-proofing)
- Line balancing: rebalance tasks across relay assembly, PCB assembly, case assembly, and loading so that the constraint is explicit and managed (reduces WIP buildup and rushed work). - Standard work + visual work instructions: use photo-based build steps for each relay family; incorporate “critical-to-quality” and “critical-to-safety” checkpoints. - ESD discipline as a yield lever: verify ESD program controls using IEC 61340-5-1 concepts; ESD failures often appear as intermittent test failures and late defects. [23] (https://webstore.iec.ch/en/publication/74748)

Performance management and control of drift - Create a KPI dashboard using standardized definitions (ISO 22400 provides KPI definitions for manufacturing operations management; adopt a small subset). [66] (https://www.iso.org/standard/54497.html?utm_source=chatgpt.com)
- Minimum KPI set that supports both safety and production: - First-pass yield (FPY) by stage (assembly / pre-test / full-test) - ATE utilization and top 5 downtime codes - Rework rate + top rework causes - Overtime hours (fatigue proxy) and training completion - Near-miss volume and time-to-close corrective actions (learning rate) [67] (https://www.safeworkaustralia.gov.au/safety-topic/managing-health-and-safety/training-and-supporting-your-workers-stay-safe-work)

## Practical tools and templates

### Suggested EMI and EMC periodic test checklist

This checklist is designed for site EMI (“keep the testing stable”) and awareness of EMC compliance expectations for equipment used/supplied in Australia. It is not a substitute for formal compliance testing, but it structures an internal “EMI hygiene” program that aligns with the idea of verifying immunity/emissions expectations for measurement/control equipment. [51] (https://webstore.iec.ch/en/publication/62793)

Scope and frequency - Establish a baseline EMI map once, then repeat quarterly (or after any major change: new HV supply, new ATE rack, rearranged cable trays, new motors/VFDs, new welders/large loads). - Define priority locations: ATE analog measurement points, HV switch nodes, high-current supply outputs, DUT fixture interfaces, and instrument reference standards bench.

Preparation - Confirm instrument calibration status and that sensitive measurements are tied to stable reference points (calibration competence principles are central to consistent results). [50] (https://www.iso.org/ISO-IEC-17025-testing-and-calibration-laboratories.html?utm_source=chatgpt.com)
- Document the test state: - “All off / idle” (background) - “Typical production load” - “Worst case” (HV switching, max current ramps)

Radiated EMI quick survey (practical) - Use spectrum analyzer + near-field probes (H-field and E-field) around: - HV power supply enclosures and output leads - ATE racks (especially harness exits) - DUT fixture wiring bundles - Record top peaks (frequency + amplitude + location) and compare to baseline trend.

Conducted EMI quick checks (practical) - Use a clamp-on current probe to scan: - supply mains feeding ATE racks and HV supplies - protective earth conductors (look for unusual HF current paths indicating bonding/ground loop issues) - Note correlation between peaks and test failures/nuisance faults.

Immunity stress “sanity checks” for instruments (non-destructive, controlled) - Repeat a stable reference measurement (golden unit / known source) while: - cycling nearby high-current loads - switching HV states - running motors/compressors (if applicable) - Pass condition: measurement stays within defined tolerance band; if not, treat as an EMC/grounding/cabling defect to correct.

Mitigation checklist if issues are found - Separate signal and power cable runs; shorten loop areas; twist pairs where appropriate. - Improve shielding termination and bonding consistency; avoid “pigtail” shield connections for high-frequency noise. - Add ferrites, filters, or feed-through capacitors where recurring peaks are traced to specific lines. - Confirm protective earthing/bonding strategy remains compliant and consistent with installation rules. [68] (https://www.standards.org.au/flagship-projects/wiring-rules?utm_source=chatgpt.com)

Regulatory awareness - If RMS supplies equipment to the Australian market, note that ACMA’s EMC arrangements focus on mandatory emissions requirements under the mandated standards framework; maintain compliance records where applicable. [69] (https://www.acma.gov.au/sites/default/files/2019-08/ACMA-mandated%20EMC%20standards.pdf)

### Test workflow separation flowchart

flowchart TD
A[Unit received / job traveler] --> B[Pre-test check]
B --> B1[Visual inspection + labeling check]
B --> B2[ESD controls verified for handling]
B --> B3[Fixture selection + safety interlocks verified]
B --> C{Pre-test OK?}

C -- No --> D[Quarantine / rework queue]
D --> D1[Repair action]
D --> B

C -- Yes --> E[Full-test lane]

E --> E2[HV / insulation / current tests (as applicable)]
E --> E1[ATE functional test]

E --> F{Pass?}

F -- Yes --> G[Release to packing / loading]
G --> H[Ship / store]

F -- No --> I[Fault-diagnosis lane]
I --> I1[De-energized diagnostics first]
I --> I2[If energized testing required: authorized procedure + controls]
I --> J{Correctable?}

J -- Yes --> D
J -- No --> K[Engineering review / scrap disposition]

[1] (https://www.safeworkaustralia.gov.au/system/files/documents/1810/model-cop-managing-electrical-risks-in-the-workplace.pdf) [5] (https://www.safeworkaustralia.gov.au/system/files/documents/1810/model-cop-managing-electrical-risks-in-the-workplace.pdf) [6] (https://www.safeworkaustralia.gov.au/system/files/documents/1810/model-cop-managing-electrical-risks-in-the-workplace.pdf) [31] (https://www.safeworkaustralia.gov.au/system/files/documents/1810/model-cop-managing-electrical-risks-in-the-workplace.pdf) [36] (https://www.safeworkaustralia.gov.au/system/files/documents/1810/model-cop-managing-electrical-risks-in-the-workplace.pdf) [42] (https://www.safeworkaustralia.gov.au/system/files/documents/1810/model-cop-managing-electrical-risks-in-the-workplace.pdf) Model Code of Practice: Managing electrical risks in the workplace

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

[2] (https://webstore.iec.ch/en/publication/62793) [21] (https://webstore.iec.ch/en/publication/62793) [51] (https://webstore.iec.ch/en/publication/62793) IEC 61326-1:2020 | IEC

https://webstore.iec.ch/en/publication/62793

[3] (https://www.standards.org.au/blog/spotlight-on-in-service-safety-inspection-and-testing-of-electrical-equipment-and-rcds) [16] (https://www.standards.org.au/blog/spotlight-on-in-service-safety-inspection-and-testing-of-electrical-equipment-and-rcds) [26] (https://www.standards.org.au/blog/spotlight-on-in-service-safety-inspection-and-testing-of-electrical-equipment-and-rcds) [29] (https://www.standards.org.au/blog/spotlight-on-in-service-safety-inspection-and-testing-of-electrical-equipment-and-rcds) [60] (https://www.standards.org.au/blog/spotlight-on-in-service-safety-inspection-and-testing-of-electrical-equipment-and-rcds) Spotlight on: AS/NZS 3760:2022, In-service safety inspection and testing of electrical equipment and RCDs - Standards Australia

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

[4] (https://www.safeworkaustralia.gov.au/sites/default/files/2024-11/model_code_of_practice-how_to_manage_work_health_and_safety_risks-nov24.pdf) [10] (https://www.safeworkaustralia.gov.au/sites/default/files/2024-11/model_code_of_practice-how_to_manage_work_health_and_safety_risks-nov24.pdf) [57] (https://www.safeworkaustralia.gov.au/sites/default/files/2024-11/model_code_of_practice-how_to_manage_work_health_and_safety_risks-nov24.pdf) How to manage work health and safety risks

https://www.safeworkaustralia.gov.au/sites/default/files/2024-11/model_code_of_practice-how_to_manage_work_health_and_safety_risks-nov24.pdf

[7] (https://www.safeworkaustralia.gov.au/sites/default/files/2023-12/dec_2023_-_code_of_practice_-_managing_the_risks_of_plant_in_the_workplace.pdf) [30] (https://www.safeworkaustralia.gov.au/sites/default/files/2023-12/dec_2023_-_code_of_practice_-_managing_the_risks_of_plant_in_the_workplace.pdf) [39] (https://www.safeworkaustralia.gov.au/sites/default/files/2023-12/dec_2023_-_code_of_practice_-_managing_the_risks_of_plant_in_the_workplace.pdf) [40] (https://www.safeworkaustralia.gov.au/sites/default/files/2023-12/dec_2023_-_code_of_practice_-_managing_the_risks_of_plant_in_the_workplace.pdf) [44] (https://www.safeworkaustralia.gov.au/sites/default/files/2023-12/dec_2023_-_code_of_practice_-_managing_the_risks_of_plant_in_the_workplace.pdf) [45] (https://www.safeworkaustralia.gov.au/sites/default/files/2023-12/dec_2023_-_code_of_practice_-_managing_the_risks_of_plant_in_the_workplace.pdf) [46] (https://www.safeworkaustralia.gov.au/sites/default/files/2023-12/dec_2023_-_code_of_practice_-_managing_the_risks_of_plant_in_the_workplace.pdf) [47] (https://www.safeworkaustralia.gov.au/sites/default/files/2023-12/dec_2023_-_code_of_practice_-_managing_the_risks_of_plant_in_the_workplace.pdf) [62] (https://www.safeworkaustralia.gov.au/sites/default/files/2023-12/dec_2023_-_code_of_practice_-_managing_the_risks_of_plant_in_the_workplace.pdf) [70] (https://www.safeworkaustralia.gov.au/sites/default/files/2023-12/dec_2023_-_code_of_practice_-_managing_the_risks_of_plant_in_the_workplace.pdf) Dec 2023 - Code of Practice - Managing the risks of plant in the workplace

https://www.safeworkaustralia.gov.au/sites/default/files/2023-12/dec_2023_-_code_of_practice_-_managing_the_risks_of_plant_in_the_workplace.pdf

[8] (https://www.safeworkaustralia.gov.au/sites/default/files/2023-06/model_code_of_practice_managing_the_risks_of_hazardous_chemicals_in_the_workplace.pdf) [28] (https://www.safeworkaustralia.gov.au/sites/default/files/2023-06/model_code_of_practice_managing_the_risks_of_hazardous_chemicals_in_the_workplace.pdf) safeworkaustralia.gov.au

https://www.safeworkaustralia.gov.au/sites/default/files/2023-06/model_code_of_practice_managing_the_risks_of_hazardous_chemicals_in_the_workplace.pdf

[9] (https://www.safeworkaustralia.gov.au/system/files/documents/1905/model-cop-hazardous-manual-tasks.pdf) Model Code of Practice: Hazardous manual tasks

https://www.safeworkaustralia.gov.au/system/files/documents/1905/model-cop-hazardous-manual-tasks.pdf

[11] (https://www.safeworkaustralia.gov.au/system/files/documents/1702/emergency_plans_fact_sheet.pdf) [33] (https://www.safeworkaustralia.gov.au/system/files/documents/1702/emergency_plans_fact_sheet.pdf) [53] (https://www.safeworkaustralia.gov.au/system/files/documents/1702/emergency_plans_fact_sheet.pdf) EMERGENCY PLANS

https://www.safeworkaustralia.gov.au/system/files/documents/1702/emergency_plans_fact_sheet.pdf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

[12] (https://www.safeworkaustralia.gov.au/safety-topic/managing-health-and-safety/training-and-supporting-your-workers-stay-safe-work) [56] (https://www.safeworkaustralia.gov.au/safety-topic/managing-health-and-safety/training-and-supporting-your-workers-stay-safe-work) [67] (https://www.safeworkaustralia.gov.au/safety-topic/managing-health-and-safety/training-and-supporting-your-workers-stay-safe-work) Training and supporting your workers to stay safe at work

https://www.safeworkaustralia.gov.au/safety-topic/managing-health-and-safety/training-and-supporting-your-workers-stay-safe-work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

[13] (https://www.safeworkaustralia.gov.au/safety-topic/managing-health-and-safety/incident-notification/incident-notification-requirements-under-model-whs-act) Incident notification requirements under the model WHS Act

https://www.safeworkaustralia.gov.au/safety-topic/managing-health-and-safety/incident-notification/incident-notification-requirements-under-model-whs-act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

[14] (https://www.standards.org.au/flagship-projects/wiring-rules?utm_source=chatgpt.com) [68] (https://www.standards.org.au/flagship-projects/wiring-rules?utm_source=chatgpt.com) Wiring Rules

https://www.standards.org.au/flagship-projects/wiring-rules?utm_source=chatgpt.com

[15] (https://store.standards.org.au/product/as-nzs-4836-2023?utm_source=chatgpt.com) AS/NZS 4836:2023

https://store.standards.org.au/product/as-nzs-4836-2023?utm_source=chatgpt.com

[17] (https://store.standards.org.au/product/as-nzs-4024-2019-series?utm_source=chatgpt.com) AS/NZS 4024:2019 Series - Safety of machinery

https://store.standards.org.au/product/as-nzs-4024-2019-series?utm_source=chatgpt.com

[18] (https://www.worksafe.act.gov.au/health-and-safety-portal/managing-safety/signage) Signage

https://www.worksafe.act.gov.au/health-and-safety-portal/managing-safety/signage?utm_source=chatgpt.com

[19] (https://www.standards.org.au/standards-catalogue/standard-details?designation=as-3745-2010) AS 3745-2010

https://www.standards.org.au/standards-catalogue/standard-details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

[20] (https://webstore.iec.ch/en/publication/4279) [43] (https://webstore.iec.ch/en/publication/4279) IEC 61010-1:2010 | IEC

https://webstore.iec.ch/en/publication/4279

[22] (https://www.acma.gov.au/sites/default/files/2025-09/EVC%20Code%20of%20Practice%20for%20EMC.pdf) [27] (https://www.acma.gov.au/sites/default/files/2025-09/EVC%20Code%20of%20Practice%20for%20EMC.pdf) [34] (https://www.acma.gov.au/sites/default/files/2025-09/EVC%20Code%20of%20Practice%20for%20EMC.pdf) [41] (https://www.acma.gov.au/sites/default/files/2025-09/EVC%20Code%20of%20Practice%20for%20EMC.pdf) acma.gov.au

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

[23] (https://webstore.iec.ch/en/publication/74748) [37] (https://webstore.iec.ch/en/publication/74748) IEC 61340-5-1:2024 | IEC

https://webstore.iec.ch/en/publication/74748

[24] (https://www.standards.org.au/standards-catalogue/standard-details?designation=as-nzs-iso-45001-2018) AS/NZS ISO 45001:2018

https://www.standards.org.au/standards-catalogue/standard-details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

[25] (https://www.worksafe.wa.gov.au/system/files/migrated/sites/default/files/atoms/files/guide-soldering_and_rosin_fluxes.pdf) [52] (https://www.worksafe.wa.gov.au/system/files/migrated/sites/default/files/atoms/files/guide-soldering_and_rosin_fluxes.pdf) Guidance note - Soldering in the workplace: Rosin fluxes

https://www.worksafe.wa.gov.au/system/files/migrated/sites/default/files/atoms/files/guide-soldering_and_rosin_fluxes.pdf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

[32] (https://www.iso.org/ISO-IEC-17025-testing-and-calibration-laboratories.html?utm_source=chatgpt.com) [50] (https://www.iso.org/ISO-IEC-17025-testing-and-calibration-laboratories.html?utm_source=chatgpt.com) ISO - ISO/IEC 17025 — Testing and calibration laboratories

https://www.iso.org/ISO-IEC-17025-testing-and-calibration-laboratories.html?utm_source=chatgpt.com

[35] (https://www.safeworkaustralia.gov.au/safety-topic/managing-health-and-safety/identify-assess-and-control-hazards/managing-risks) [59] (https://www.safeworkaustralia.gov.au/safety-topic/managing-health-and-safety/identify-assess-and-control-hazards/managing-risks) Identify, assess and control hazards - Managing risks

https://www.safeworkaustralia.gov.au/safety-topic/managing-health-and-safety/identify-assess-and-control-hazards/managing-risks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

[38] (https://www.worksafe.qld.gov.au/safety-and-prevention/creating-safe-work/managing-risks/local-exhaust-ventilation-lev) Local exhaust ventilation (LEV)

https://www.worksafe.qld.gov.au/safety-and-prevention/creating-safe-work/managing-risks/local-exhaust-ventilation-lev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

[48] (https://www.worksafe.vic.gov.au/preventing-electric-shocks-electricians) Preventing electric shocks to electricians | WorkSafe Victoria

https://www.worksafe.vic.gov.au/preventing-electric-shocks-electricians

[49] (https://www.safeworkaustralia.gov.au/system/files/documents/1702/electrical-risks.pdf) safeworkaustralia.gov.au

https://www.safeworkaustralia.gov.au/system/files/documents/1702/electrical-risks.pdf

[54] (https://store.standards.org.au/product/as-2444-2001?utm_source=chatgpt.com) AS 2444-2001

https://store.standards.org.au/product/as-2444-2001?utm_source=chatgpt.com

[55] (https://www.anzcor.org/home/basic-life-support/guideline-2-managing-an-emergency/downloadpdf) Guideline 2 – Managing an Emergency

https://www.anzcor.org/home/basic-life-support/guideline-2-managing-an-emergency/downloadpdf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

[58] (https://www.safeworkaustralia.gov.au/sites/default/files/2022-09/Incident-notification-fact-sheet-2015%20UD.PDF) Incident notification fact sheet

https://www.safeworkaustralia.gov.au/sites/default/files/2022-09/Incident-notification-fact-sheet-2015%20UD.PDF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

[61] (https://www.lean.org/lexicon-terms/single-minute-exchange-of-die/?utm_source=chatgpt.com) Single Minute Exchange of Die

https://www.lean.org/lexicon-terms/single-minute-exchange-of-die/?utm_source=chatgpt.com

[63] (https://www.iso.org/standard/62085.html?utm_source=chatgpt.com) ISO 9001:2015 - Quality management systems

https://www.iso.org/standard/62085.html?utm_source=chatgpt.com

[64] (https://www.lean.org/lexicon-terms/five-s/?utm_source=chatgpt.com) 5S - What is it? | Lean Enterprise Institute

https://www.lean.org/lexicon-terms/five-s/?utm_source=chatgpt.com

[65] (https://asq.org/quality-resources/mistake-proofing) What is Poka-Yoke? Mistake & Error Proofing

https://asq.org/quality-resources/mistake-proofing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

[66] (https://www.iso.org/standard/54497.html?utm_source=chatgpt.com) ISO 22400-2:2014 - Automation systems and integration ...

https://www.iso.org/standard/54497.html?utm_source=chatgpt.com

[69] (https://www.acma.gov.au/sites/default/files/2019-08/ACMA-mandated%20EMC%20standards.pdf) ACMA-mandated EMC standards

https://www.acma.gov.au/sites/default/files/2019-08/ACMA-mandated%20EMC%20standards.pdf
