Chamil1983/SM-GE3222M-Smart-Energy-Monitor/Examples/IPEM_1_Test_Code_ATM90E32_ATM90E36/src/main.cpp

/*
  
  IPEM-1 ESP32 ATM90E32 ATM90E36 IoT Power Energy Monitoring Energy Monitor v1.0
  Features include ESP32 IPEM ESP32 ATM90E32 ATM90E36 16bit ADC EEPROM 3Phase 3+1 CT-Clamps Current Voltage Frequency Power Factor GPIO I2C OLED SMPS D1 USB
  PCA 1.2302-20x - Test Code Firmware v1 - Development Code - WORK-IN-PROGRESS - 16th June 2023

  The purpose of this test code is to cycle through the various main functions of the board, as shown below, as part of board bring-up testing.


  This software has expanded way past it's original bring-up task and is now quite comprehensive.  It can now be, as is, used for both bring-up, final use, and publishing. Otherwise, simply use the bits you like!

  Several software switches are used, throughout.  The defaults are listed below.  You shold be able just to compile this current version to an IPEM ATM90E32 and see some valid results in the serial monitor / OLED.

  Board Bring Up Test - ATM90E3x Test Routines (Output sent to the Serial Print - ONLY ON BOOT! Press RESET or HOLD USR Button to REFRESH)

  Base 90E32/36 register formulation based on the excellent groundwork from Dave Williams, Tisham Dhar, whatnick | ATM90E32 ATM90E36 Energy Monitor Core

   **CONFIGURATION** (Setup for bring-up testing of the board)

  This version of firmware code is by default, configured for:
  * ATM90E32 (ATM90DEVICE ATM90E32_DEVICE)
  * CT4 Configured to ESP32 ADC (CT4_CONFIG CT4_ESP)
  * CT4 Input - Enabled (CT4_ENABLED true)
  * PWM Output on Default GPIO Port GP17 (EnablePWMLocal false EnablePWMRemote false EnablePWMTestOutput false)
  * DAC Output. Port TBD (EnableDACLocal false EnableDACRemote false EnableDACTestOutput false)
  * Multi-Voltage Input (ATM_SINGLEVOLTAGE true)
  * Split-Phase USA - Disabled (ATM_SPLITPHASE false)
  * Hardware Test - Enabled (DisableHardwareTest false)
  * Display of Board Configuration (EnableDisplayBoardConfiguration true)
  * Domoticz Publishing - Disabled (EnableDomoticz false)
  * MQTT Publishing - Disabled (EnableMQTT false)
  * Loop Refreshing Terminal Output (EnableBasicLoop false) - Display Info ONCE uppon Reset.
  * Value Outputs are filtered through a Sofware Noise Filter / Comparator / Squelch (EnableNoiseFilterSquelch true)
  * When Publising to Domoticz - Mute Detailed Output to Serial (Loop)
  * OLED 0.6" Display SSD1306 128x32.  (EnableOLEDLoop true)
  * Board Location and Firmware Version to OLED and Serial Monitor
  * IP Address Defaults to DHCP.  Static IP Address Configuration in WiFi-OTA.h

  **CALIBRATION** (This should be minimal - based on the below)

  This version of firmware has been setup for ATM90E32 and CT4 to ESP32 ADC.
  * Current Clamp default example settings are based on SCT-013-000 100A/50mA.
  * Voltages default example settings are based on Single/Three Phase Voltage Inputs from a Greenbrook DAT01A (TC TR7) Transformer, set to 12V AC.
  * Current Clamps CT1, CT2 and CT3 are connected to the ATM90E3x. Calibration requirements should be minimal and board ready to use.
  * AC Voltage Inputs V1, V2 and V3 are connected to the ATM90E3x. Calibration requirements should be minimal and board ready to use.
  * Current Clamp CT4 is connected to the ESP32 ADC1 CH7. Software EmonLib calibratrion may be required.
  * You can update ATM90Ex calibration (if required), in IPEM_Hardware.h
  * You can update board ATM Configurations in ATM90E3x.h
  * You can update CT4 calibration in iPEM_Hardware.h - See EmonLib

  **WiFi and OTA Updates**

  * Setup WiFi
  * Configure Multi-WiFi SSID/PWD
  * Setup Optional Static IP address and Gateway (DHCP or Static)
  * Setup Preferred Hostname
  * Setup Serial Device over IP (Used for OTA)
  * Display WiFI Signal Meter
  * Web Server Information Page and Push OTA Updater
  * Web Listner
  * PWM Switches added: /pwm-local, /pwm-remote, /pwm-on, /pwm-off, /pwm-test
  * DAC Switches added: /dac-local, /dac-remote, /dac-on, /dac-off, /dac-test
  * Seperate switches dac-remote and pwm-remote, allow you to remotely send a fixed value to pwm / dac output.  Ideal for scenes etc.  Remote turns off or over-rides CT for pwm/dac.

  **DOMOTICZ**

  * Setup connection to Domoticz Home Automation
  * Configure Required Values to Publish to Domoticz Hardware Device Indexes

  **MQTT**

  * Setup connection to MQTT Broker / Home Automation
  * Configure Required Values to Publish to MQTT Broker

  **ThingSpeak**
  * Example Publish (play data), can be found on https://thingspeak.com/channels/2179490
  * Setup easy connection to ThingSpeak Cloud Base Server / Home Automation.  FREE Cloud Account.  View on Phone/Web.
  * Configure Required Values to Publish to ThingSpeak

  **PWM Duty Cycle Output**

  * PWM (On Default GPIO 17), which will track Power Usage (from Default Variable ActivePowerExportCT1)
  * Output Updated on Each DisplayRegisters Loop (Only if Value Changed)
  * WebServer /pwm-local, /pwm-remote, /pwm-on, /pwm-off, /pwm-test.  See https://github.com/DitroniX/IPEM-IoT-Power-Energy-Monitor/wiki/WebServer-Commands 
  * Ability to Enable and Disable PWM Local Readings
  * Ability to Enable and Disable PWM Remote Readings
  * Ability to Enable and Disable PWM Test Mode
  * Ability  to Set Fixed Power from Remote Value, or Leave to Dynamic CT Power Values (WIP)
  * Continuous PWM Cycle Test Mode Loop

  **DAC Voltage Output**

  * Fixed Voltage Output from DAC, tracking Power Usage (from Default Variable ActivePowerExportCT1)
  * Output Updated on Each DisplayRegisters Loop (Only if Value Changed)
  * WebServer /dac-local, /dac-remote, /dac-on, /dac-off, /dac-test.  See https://github.com/DitroniX/IPEM-IoT-Power-Energy-Monitor/wiki/WebServer-Commands
  * Ability to Enable and Disable DAC Local Readings
  * Ability to Enable and Disable DAC Remote Readings
  * Ability to Enable and Disable DAC Test Mode
  * Abilty to Set Fixed DAC Output from Remote Value, or Leave to Dynamic CT Power Values (WIP)
  * DAC Sinewave Test Mode Loop (Default 10 Hz)
  * DAC Stepped Voltages Test Mode Loop (Slow Staircase)

  Remember!
  * Set the BOARD to ESP32, 'WEMOS D1 MINI ESP32' DEV Module (or similar).
  * You may set the BAUD rate to 921600 to speed up flashing.
  * The SDK board does NOT need external power to flash.  It will take Power from the USB 5V.
  * You can safely connect both USB Power and PSU AC In, at the sme time (Makes development much easier).

  Note: In the default state, upon first power up and during reset, the Green LED may be partially lit. Once programmed and the GPIO defined, the Green LED will go off after power up.

  This test code is OPEN SOURCE and formatted for easier viewing.  Although is is not intended for real world use, it may be freely used, or modified as needed.
  It is distributed on an "AS IS" BASIS, WITHOUT WARRANTIES OR CONDITIONS OF ANY KIND, either express or implied.

  ***IMPORTANT: Please configure ESP PIN settings Before Start ***
  Refer ESP32 Pin Configuration File for referance
  
*/

// Libraries
#include <Arduino.h>
#include <SPI.h>
#include <Wire.h>
#include <driver/adc.h>
#include <ATM90E3x.h>
#include <IPEM_Hardware.h>
#include <WiFi-OTA.h>
#include <Domoticz.h>
#include <MQTT.h>
#include <ThingSpeakIoT.h>

// USER VARIABLES / DEFINES / STATIC / STRUCTURES / CONSTANTS -> Moved to IPEM_Hardware

// **************** FUNCTIONS AND ROUTINES ****************

// Return Register Values from the ATM90E32, or ATM90E36, - and Display
void DisplayRegisters(boolean DisplayFull = true)
{

  // PWM DutyCycle Output Pending Power Value. Test Usage: PWM_Power(2000)
  if (EnablePWMLocal == true && EnablePWMRemote == false && EnablePWMTestOutput == false)
    PWM_Power(ActivePowerExportCT1);

  if (EnablePWMLocal == false && EnablePWMRemote == true && EnablePWMTestOutput == false)
    PWM_Power(PWMRemotePower);

  // DAC Voltage Output Pending Power Value. Test Usage: DAC_Power(2000)
  if (EnableDACLocal == true && EnableDACRemote == false && EnableDACTestOutput == false)
    DAC_Power(ActivePowerExportCT1);

  if (EnableDACLocal == false && EnableDACRemote == true && EnableDACTestOutput == false)
    DAC_Power(PWMRemotePower);

  // if (DisplayFull == false) // Display Expanded Information
  //   Serial.println("\nDisplay Output (DisplayRegisters false), Set to Minimised");

  // Display Board Configuration
  if (EnableDisplayBoardConfiguration == true && DisplayFull == true)
    DisplayBoardConfiguration();

  // **************** VOLTAGE ****************

  // Get Mains Voltages
  LineVoltage1 = NoiseFilterSquelch(eic.GetLineVoltage1(), 1);
  LineVoltage2 = NoiseFilterSquelch(eic.GetLineVoltage2(), 1);
  LineVoltage3 = NoiseFilterSquelch(eic.GetLineVoltage3(), 1);
  LineVoltageAverage = 0;
  LineVoltageTotal = 0;

// Calculate Voltage
#if ATM_SINGLEVOLTAGE == true && ATM_SPLITPHASE == true
  Serial.println("* SOFTWARE CONFIGURATION ERROR *\n* You cannot have ATM_SINGLEVOLTAGE and ATM_SPLITPHASE, both Enabled.\n");
#else
#if ATM_SPLITPHASE == true
  LineVoltageTotal = (LineVoltage1 + LineVoltage3) / 2; // Split Single Phase configured, so only 120V per leg
#else
  LineVoltageAverage = (LineVoltage1 + LineVoltage2 + LineVoltage3) / 3; // Voltage should be around 110V, or 220-240, at the AC transformer primary.
#endif
#endif

  if (DisplayFull == true) // Display Expanded Information
  {

    // Mains RMS Voltage
    PrintUnderline("Mains RMS Voltage");

#if ATM_SINGLEVOLTAGE == false

    Serial.println("Voltage 1: " + String(LineVoltage1) + " V");

#if ATM_SPLITPHASE == false
    Serial.println("Voltage 2: " + String(LineVoltage2) + " V");
#endif

    Serial.println("Voltage 3: " + String(LineVoltage3) + " V");

#if ATM_SPLITPHASE == true
    PrintSeparator("Total Split Voltage: " + String(LineVoltageTotal) + " V (V1~X~V3)");
#else
    PrintSeparator("Average Voltage: " + String(LineVoltageAverage) + " V (V1~V2~V3)");
#endif

#else
    PrintSeparator("Voltage 1: " + String(LineVoltage1) + " V (Single Line Voltage Selected)");
#endif
  }

  // **************** CURRENT ****************

  // Get Total Current.  Ignore CT2 if Split Phase
  LineCurrentCT1 = NoiseFilterSquelch(eic.GetLineCurrentCT1());
#if ATM_SPLITPHASE == false
  LineCurrentCT2 = NoiseFilterSquelch(eic.GetLineCurrentCT2());
#else
  LineCurrentCT2 = 0;
#endif
  LineCurrentCT3 = NoiseFilterSquelch(eic.GetLineCurrentCT3());

  // Using ESP32 ADC for CT4 Current Input

#if ATM90DEVICE == ATM90E32_DEVICE || CT4_CONFIG == CT4_ESP
  ReadCT4Current();
#if CT4_ENABLED == true
  LineCurrentTotal = NoiseFilterSquelch(LineCurrentCT1 + LineCurrentCT2 + LineCurrentCT3 + LineCurrentCT4);
#else
  LineCurrentTotal = NoiseFilterSquelch(LineCurrentCT1 + LineCurrentCT2 + LineCurrentCT3);
#endif
#endif

// E36 Using I4N Input for Current
#if ATM90DEVICE == ATM90E36_DEVICE && CT4_CONFIG == CT4_ATM
  LineCurrentCTN = NoiseFilterSquelch(eic.GetLineCurrentCTN());
  LineCurrentTotal = NoiseFilterSquelch(LineCurrentCT1 + LineCurrentCT2 + LineCurrentCT3);
#endif

  if (DisplayFull == true) // Display Expanded Information
  {
    Serial.println("");

    // Mains RMS Current
    PrintUnderline("Mains RMS Current");
    Serial.println("Current CT1: " + String(LineCurrentCT1) + " A");

#if ATM_SPLITPHASE == false
    Serial.println("Current CT2: " + String(LineCurrentCT2) + " A");
#endif

    Serial.println("Current CT3: " + String(LineCurrentCT3) + " A");

#if ATM90DEVICE == ATM90E32_DEVICE && CT4_ENABLED == true || CT4_CONFIG == CT4_ESP && CT4_ENABLED == true
    Serial.println("Current CT4: " + String(LineCurrentCT4) + " A (ESP ADC1 CH7)");
#endif

#if ATM90DEVICE == ATM90E36_DEVICE && CT4_CONFIG == CT4_ATM
    Serial.println("Current CTN: " + String(LineCurrentCTN) + " A");
#endif

#if ATM_SPLITPHASE == true
    Serial.println("Actual Total Current: " + String(LineCurrentTotal) + " A (CT1~X~CT3)");
#else
#if CT4_ENABLED == true
    PrintSeparator("Actual Total Current: " + String(LineCurrentTotal) + " A (CT1~CT2~CT3~CT4)");
#else
    PrintSeparator("Actual Total Current: " + String(LineCurrentTotal) + " A (CT1~CT2~CT3)");
#endif
#endif

    Serial.println("");
  }

  // **************** POWER ****************

  // Calculated Power CT2ased on V*I
#if ATM_SINGLEVOLTAGE == true // Single Mains Voltage for all Current Measurements
  CalculatedPowerCT1 = LineVoltage1 * LineCurrentCT1;
  CalculatedPowerCT2 = LineVoltage1 * LineCurrentCT2;
  CalculatedPowerCT3 = LineVoltage1 * LineCurrentCT3;

#if ATM90DEVICE == ATM90E36_DEVICE
  CalculatedPowerCT4 = LineVoltage1 * LineCurrentCT4;
#endif

  if (DisplayFull == true) // Display Expanded Information
  {
    PrintUnderline("Calculated RMS Power");
    Serial.println("Power V1*I1: " + String(CalculatedPowerCT1) + " W");
    Serial.println("Power V1*I2: " + String(CalculatedPowerCT2) + " W");
    Serial.println("Power V1*I3: " + String(CalculatedPowerCT3) + " W");

#if ATM90DEVICE == ATM90E36_DEVICE
    Serial.println("Power V1*I4: " + String(CalculatedPowerCT4) + " W");
#endif
  }
#else // Seperate Mains Voltages for Current Measurements
  CalculatedPowerCT1 = LineVoltage1 * LineCurrentCT1;
  CalculatedPowerCT2 = LineVoltage2 * LineCurrentCT2;
  CalculatedPowerCT3 = LineVoltage3 * LineCurrentCT3;

#if ATM90DEVICE == ATM90E36_DEVICE
  CalculatedPowerCT4 = LineVoltage1 * LineCurrentCT4; // ESP32 ADC1 CH7 using V1
#endif

  if (DisplayFull == true) // Display Expanded Information
  {
    PrintUnderline("Calculated RMS Power");
    Serial.println("Power V1*I1: " + String(CalculatedPowerCT1) + " W");
    Serial.println("Power V2*I2: " + String(CalculatedPowerCT2) + " W");
    Serial.println("Power V3*I3: " + String(CalculatedPowerCT3) + " W");
  }
#if CT4_ENABLED == true && ATM90DEVICE == ATM90E36_DEVICE
  if (DisplayFull == true) // Display Expanded Information
  {
    Serial.println("Power V1*I4: " + String(CalculatedPowerCT4) + " W");
  }
#endif
#endif

// Calculate Total Watts
#if ATM_SPLITPHASE == true // USA 120+120
  CalculatedTotalPower = (LineVoltage1 * LineCurrentCT1) + (LineVoltage3 * LineCurrentCT3);

  if (DisplayFull == true) // Display Expanded Information
    PrintSeparator("Calculated Total Power: " + String(CalculatedTotalPower) + " W (CT1~X~CT3)");
#else // World
#if CT4_CONFIG == CT4_ESP && CT4_ENABLED == true
  CalculatedTotalPower = (LineVoltage1 * LineCurrentCT1) + (LineVoltage2 * LineCurrentCT2) + (LineVoltage3 * LineCurrentCT3) + (LineVoltage1 * LineCurrentCT4);

  if (DisplayFull == true) // Display Expanded Information
    PrintSeparator("Calculated Total Power: " + String(CalculatedTotalPower) + " W (CT1~CT2~CT3~CT4)");
#else
  CalculatedTotalPower = (LineVoltage1 * LineCurrentCT1) + (LineVoltage2 * LineCurrentCT2) + (LineVoltage3 * LineCurrentCT3);

  if (DisplayFull == true) // Display Expanded Information
    PrintSeparator("Calculated Total Power: " + String(CalculatedTotalPower) + " W (CT1~CT2~CT3)");
#endif
#endif

  if (DisplayFull == true) // Display Expanded Information
    Serial.println("");

  // Active Power.  Extra Import/Export values included to provide added detail for Home Automation logging
  String ActiveFlag = "";

  if (DisplayFull == true) // Display Expanded Information
    PrintUnderline("Active Power (Absorbed or Used by the Load)");

  // Active Power CT1 - Always a Postive Number
  ActivePowerCT1 = NoiseFilterSquelch(eic.GetActivePowerCT1(), 0.2);
  ActivePowerImportCT1 = 0;
  ActivePowerExportCT1 = 0;
  ActiveFlag = "";

  if (ActivePowerCT1 > 0)
  {
    ActivePowerImportCT1 = ActivePowerCT1;
    ActiveFlag = "(Import)";
  }

  if (ActivePowerCT1 < 0)
  {
    ActivePowerExportCT1 = -ActivePowerCT1;
    ActiveFlag = "(Export)";
  }

  if (DisplayFull == true) // Display Expanded Information
    Serial.println("Active Power CT1: " + String(ActivePowerCT1) + " W \t" + ActiveFlag);

  // Active Power CT2 - Always a Postive Number
  ActivePowerCT2 = NoiseFilterSquelch(eic.GetActivePowerCT2(), 0.2);
  ActivePowerImportCT2 = 0;
  ActivePowerExportCT2 = 0;
  ActiveFlag = "";

  if (ActivePowerCT2 > 0)
  {
    ActivePowerImportCT2 = ActivePowerCT2;
    ActiveFlag = "(Import)";
  }

  if (ActivePowerCT2 < 0)
  {
    ActivePowerExportCT2 = -ActivePowerCT2;
    ActiveFlag = "(Export)";
  }
  if (DisplayFull == true) // Display Expanded Information
    Serial.println("Active Power CT2: " + String(ActivePowerCT2) + " W \t" + ActiveFlag);

  // Active Power CT3 - Always a Postive Number
  ActivePowerCT3 = NoiseFilterSquelch(eic.GetActivePowerCT3(), 0.2);
  ActivePowerImportCT3 = 0;
  ActivePowerExportCT3 = 0;
  ActiveFlag = "";

  if (ActivePowerCT3 > 0)
  {
    ActivePowerImportCT3 = ActivePowerCT3;
    ActiveFlag = "(Import)";
  }

  if (ActivePowerCT3 < 0)
  {
    ActivePowerExportCT3 = -ActivePowerCT3;
    ActiveFlag = "(Export)";
  }

  if (DisplayFull == true) // Display Expanded Information
    Serial.println("Active Power CT3: " + String(ActivePowerCT3) + " W \t" + ActiveFlag);

  // Total Active Power
  TotalActivePower = NoiseFilterSquelch(eic.GetTotalActivePower(), 0.2);
  ActiveFlag = "";

  if (TotalActivePower > 0)
  {
    TotalActivePowerImport = TotalActivePower;
    ActiveFlag = "(Import)";
  }

  if (TotalActivePower < 0)
  {
    TotalActivePowerExport = -TotalActivePower;
    ActiveFlag = "(Export)";
  }

  CalculatedTotalActivePower = (ActivePowerCT1 + ActivePowerCT2 + ActivePowerCT3);

  if (DisplayFull == true) // Display Expanded Information
  {
    PrintSeparator("Total Active Power: " + String(TotalActivePower) + " W \t" + ActiveFlag);
    PrintSeparator("Calculated Total Active Power: " + String(CalculatedTotalActivePower) + " W (CT1~CT2~CT3)");
    Serial.println("");
  }

  // Re-Active Power
  ReactivePowerCT1 = NoiseFilterSquelch(eic.GetReactivePowerCT1());
  ReactivePowerCT2 = NoiseFilterSquelch(eic.GetReactivePowerCT2());
  ReactivePowerCT3 = NoiseFilterSquelch(eic.GetReactivePowerCT3());
  TotalReactivePower = NoiseFilterSquelch(eic.GetTotalReactivePower());
  CalculatedTotalReactivePower = (ReactivePowerCT1 + ReactivePowerCT2 + ReactivePowerCT3);

  if (DisplayFull == true) // Display Expanded Information
  {
    PrintUnderline("Re-Active Power");
    Serial.println("ReActive Power CT1: " + String(ReactivePowerCT1) + " VAR");
    Serial.println("ReActive Power CT2: " + String(ReactivePowerCT2) + " VAR");
    Serial.println("ReActive Power CT3: " + String(ReactivePowerCT3) + " VAR");
    PrintSeparator("Total ReActive Power: " + String(TotalReactivePower) + " VAR (CT1~CT2~CT3)");

    PrintSeparator("Calculated Total Reactive Power: " + String(CalculatedTotalReactivePower) + " W (CT1~CT2~CT3)");
    Serial.println("");
  }

  // Apparent Power Flowing - Voltage and Current (V * I)
  ApparentPowerCT1 = NoiseFilterSquelch(eic.GetApparentPowerCT1());
  ApparentPowerCT2 = NoiseFilterSquelch(eic.GetApparentPowerCT2());
  ApparentPowerCT3 = NoiseFilterSquelch(eic.GetApparentPowerCT3());
  TotalApparentPower = NoiseFilterSquelch(eic.GetTotalApparentPower());
  CalculatedTotalApparentPower = (ApparentPowerCT1 + ApparentPowerCT2 + ApparentPowerCT3);

  if (DisplayFull == true) // Display Expanded Information
  {
    PrintUnderline("Apparent Power (Total Amount of Power Flowing from Source to Load)");
    Serial.println("Apparent Power CT1: " + String(ApparentPowerCT1) + " VA");
    Serial.println("Apparent Power CT2: " + String(ApparentPowerCT2) + " VA");
    Serial.println("Apparent Power CT3: " + String(ApparentPowerCT3) + " VA");
    PrintSeparator("Total Apparent Power: " + String(TotalApparentPower) + " VA (CT1~CT2~CT3)");

    PrintSeparator("Calculated Total Apparent Power: " + String(CalculatedTotalApparentPower) + " W (CT1~CT2~CT3)");
    Serial.println("\n");
  }

#if ATM90DEVICE == ATM90E32_DEVICE
  if (DisplayFull == true) // Display Expanded Information
    PrintUnderline("Other Power Information");

  // Total Fundamental Power
  TotalActiveFundPower = NoiseFilterSquelch(eic.GetTotalActiveFundPower());
  if (DisplayFull == true) // Display Expanded Information
    Serial.println("Total Fundamental Power: " + String(TotalActiveFundPower) + " pH(t)\n");

  // Total Harmonic Power
  TotalActiveHarPower = NoiseFilterSquelch(eic.GetTotalActiveHarPower());
  if (DisplayFull == true) // Display Expanded Information
    Serial.println("Total Harmonic Power: " + String(TotalActiveHarPower) + " ");

#endif

  if (DisplayFull == true)
    Serial.println("");

  // **************** OTHER ****************

  // Power Factor
  PowerFactorCT1 = NoiseFilterSquelch(eic.GetPowerFactorCT1(), 0.01, false);
  PowerFactorCT2 = NoiseFilterSquelch(eic.GetPowerFactorCT2(), 0.01, false);
  PowerFactorCT3 = NoiseFilterSquelch(eic.GetPowerFactorCT3(), 0.01, false);
  TotalPowerFactor = NoiseFilterSquelch(eic.GetTotalPowerFactor(), 0, false);

  if (DisplayFull == true) // Display Expanded Information
  {
    PrintUnderline("Power Factor");
    Serial.println("Power Factor CT1: " + String(PowerFactorCT1) + " PF");
    Serial.println("Power Factor CT2: " + String(PowerFactorCT2) + " PF");
    Serial.println("Power Factor CT3: " + String(PowerFactorCT3) + " PF");
    PrintSeparator("Total Power Factor: " + String(TotalPowerFactor) + " PF");
    Serial.println("");
  }

  // Phase Angle
  PhaseAngleCT1 = NoiseFilterSquelch(eic.GetPhaseCT1(), 0, true, 180);
  PhaseAngleCT2 = NoiseFilterSquelch(eic.GetPhaseCT2(), 0, true, 180);
  PhaseAngleCT3 = NoiseFilterSquelch(eic.GetPhaseCT3(), 0, true, 180);

  if (DisplayFull == true) // Display Expanded Information
  {
    PrintUnderline("Phase Angle");
    Serial.println("Phase Angle CT1: " + String(PhaseAngleCT1));
    Serial.println("Phase Angle CT2: " + String(PhaseAngleCT2));
    Serial.println("Phase Angle CT3: " + String(PhaseAngleCT3));
    Serial.println("");
  }

  if (DisplayFull == true) // Display Expanded Information
    PrintUnderline("Other Information");

  // Chip Temperature
  ChipTemperature = NoiseFilterSquelch(eic.GetTemperature());

  if (DisplayFull == true) // Display Expanded Information
    Serial.println("Chip Temperature: " + String(ChipTemperature) + " °C\n");

  // Line Frequency
  LineFrequency = NoiseFilterSquelch(eic.GetFrequency());

  if (DisplayFull == true) // Display Expanded Information
    Serial.println("Mains Frequency: " + String(LineFrequency) + " Hz\n");

  // Read PCB NTC Temperature
  if (DisplayFull == true)
    ReadPCBTemperature(); // Read PCB NTC Temperature

  if (DisplayFull == true)
    Serial.println("");

  // Read PCB DCV_IN Voltage
  if (DisplayFull == true)
    ReadADCVoltage(); // Read AC>DC Input Voltage
}

// Display WiFI Status OLED
void DisplayOLEDWiFiStatus()
{
  // Firmware Version / Board Location - Display on OLED
  if (OLED_Enabled == true && EnableOLEDLoop == true)

  {

    // WiFi Connection Status - Display on OLED
    oled.clear();
    OLEDPrint(AppAcronym, 2, 0);
    OLEDPrint(LocationName, 2, 2);
    oled.update();
    delay(2000);

    oled.clear();
    OLEDPrint("Wi-Fi AP", 2, 0);
    if (WiFi.status() == WL_CONNECTED)
    {
      OLEDPrint("SSID:" + String(WiFi.SSID()), 1, 2);
      OLEDPrint(String(WiFi.RSSI()) + "dBm " + RSSI_Info(WiFi.RSSI()), 1, 3);
    }
    else
    {
      OLEDPrint("Not Connected", 1, 2);
      if (DisableWiFi == true)
      {
        OLEDPrint("Wi-Fi Force Disabled", 1, 3);
      }
    }

    oled.update();
    delay(2000);

    if (DisableWiFi == false)
    {
      oled.clear();
      OLEDPrint("Wi-Fi IP", 2, 0);
      if (WiFi.status() == WL_CONNECTED)
      {
        OLEDPrint(WiFi.localIP().toString().c_str(), 1, 2);
        OLEDPrint("Host:" + String(WiFi.getHostname()), 1, 3);
      }

      oled.update();
      delay(2000);
    }
    else
    {
      OLEDPrint("Not Connected", 1, 2);
    }
  }
} // DisplayOLEDWiFiStatus

// **************** SETUP ****************
void setup()
{

  // Stabalise
  delay(250);

  // Initialise UART
  Serial.begin(115200, SERIAL_8N1); // 115200
  while (!Serial)
    ;
  Serial.println("");

  // Application Info
  Serial.println("");
  Serial.println(AppName);
  Serial.println("");

  // Initialize OLED
  InitialiseOLED();

  // Initialise WiFi and WebServer/OTA
  if (DisableWiFi == false)
  {
    InitialiseWiFi();
    InitialiseWebServer();
    InitialiseMQTT();
    InitialiseThingSpeak();
  }
  else
  {
    Serial.println("Wi-Fi Force Disabled");
  }

  // Header
  Serial.println("Register Status and Startup Report");
  Serial.println("IPEM-1 ATM90E32 ATM90E36 IoT Power Energy Monitor");
  Serial.printf("ESP32 Serial ID: %04X", (uint16_t)(chipid >> 32));
  Serial.printf("%08X", (uint32_t)chipid);
  Serial.print("   Firmware Version: ");
  Serial.println(AppVersion);
  Serial.print("Board Location: ");
  Serial.println(LocationName);
  Serial.println("");

  PrintUnderline("Software Optons");

  // WiFi Integration Status
  if (WiFi.status() == WL_CONNECTED)
  {
    Serial.println("Wi-Fi is Enabled");
  }
  else
  {
    Serial.println("Wi-Fi is Disabled");
  }

  // Domoticz Integration Status
  if (EnableDomoticz == true && WiFi.status() == WL_CONNECTED)
  {
    Serial.println("Domoticz Enabled - Register Values Will be Published");
  }
  else
  {
    Serial.println("Domoticz Publishing is Disabled");
  }

  // MQTT Integration Status
  if (EnableMQTT == true && WiFi.status() == WL_CONNECTED)
  {
    Serial.println("MQTT Enabled - Register Values Will be Published");
  }
  else
  {
    Serial.println("MQTT Publishing is Disabled");
  }

  // ThingSpeak Integration Status
  if (EnableThingSpeak == true && WiFi.status() == WL_CONNECTED)
  {
    Serial.println("ThingSpeak Enabled - Register Values Will be Published");
  }
  else
  {
    Serial.println("ThingSpeak Publishing is Disabled");
  }

  // IPEM Board Port Configuration
  ConfigureBoard();

  // Hardware Tests
  if (DisableHardwareTest == false)
  {
    // Peripherals Test
    PrintUnderline("Peripherals Test");
    TestRGB(); // Cycle RGB LED
  }

  // Scan I2C Bus and Report Devices
  ScanI2CBus();

  // Check DCV_IN
  CheckDCVINVoltage();

  // DisplayOLEDWiFiStatus
  DisplayOLEDWiFiStatus();

// ****************  Initialise the ATM90E3x & Pass related calibrations to its library ****************

// LineFreq = lineFreq, PGAGain = pgagain, VoltageGainX = ugain, CurrentGainCT1 = igainA, CurrentGainCT2 = igainB, CurrentGainCT3 = igainC, CurrentGainCTN = igainN
#if ATM90DEVICE == ATM90E32_DEVICE && ATM_SPLITPHASE == true // Not Fully Tested.
// the 2nd (B) current channel is not used with the split phase meter
#if ATM_SINGLEVOLTAGE == true
  eic.begin(LineFreq, PGAGain, VoltageGain1, 0, 0, CurrentGainCT1, 0, CurrentGainCT2);
#else
  eic.begin(LineFreq, PGAGain, VoltageGain1, VoltageGain2, VoltageGain3, CurrentGainCT1, 0, CurrentGainCT2);
#endif
#endif

#if ATM90DEVICE == ATM90E32_DEVICE && ATM_SPLITPHASE == false
#if ATM_SINGLEVOLTAGE == true
  // eic.begin(LineFreq, PGAGain, VoltageGain1, 0, 0, CurrentGainCT1, CurrentGainCT2, CurrentGainCT3);
  eic.begin(LineFreq, PGAGain, VoltageGain1, VoltageGain1, VoltageGain1, CurrentGainCT1, CurrentGainCT2, CurrentGainCT3);
#else
  eic.begin(LineFreq, PGAGain, VoltageGain1, VoltageGain2, VoltageGain3, CurrentGainCT1, CurrentGainCT2, CurrentGainCT3);
#endif
#endif

#if ATM90DEVICE == ATM90E36_DEVICE && ATM_SPLITPHASE == false
#if ATM_SINGLEVOLTAGE == true
  // eic.begin(LineFreq, PGAGain, VoltageGain1, 0, 0, CurrentGainCT1, CurrentGainCT2, CurrentGainCT3, CurrentGainCTN);
  eic.begin(LineFreq, PGAGain, VoltageGain1, VoltageGain1, VoltageGain1, CurrentGainCT1, CurrentGainCT2, CurrentGainCT3, CurrentGainCTN);
#else
  eic.begin(LineFreq, PGAGain, VoltageGain1, VoltageGain2, VoltageGain3, CurrentGainCT1, CurrentGainCT2, CurrentGainCT3, CurrentGainCTN);
#endif
#endif

  Serial.println("IPEM Hardware Setup and Power-Up Test - Board Initialized");

  delay(1000);

  Serial.println("");

  DisplayRegisters(); // Display once

} // Setup

// **************** LOOP ****************
void loop() // Future - ISRs To Be Added
{

  String sDIR = "";

  // Basic Handler for WebServer
  CheckOTA();

  // Force Continuous Test PWM Cycle Loop. Force OFF EnablePWMLocal EnablePWMRemote
  if (EnablePWMTestOutput == true)
  {
    EnablePWMLocal = false;
    EnablePWMRemote = false;
    PWM_Test();
  }

  // Force Continuous Test DAC Sinewave Cycle Loop etc. Force OFF EnableDACLocal EnableDACRemote
  if (EnableDACTestOutput == true)
  {
    EnableDACLocal = false;
    EnableDACRemote = false;

    //  0 = Stepped Voltage  1 = SineWave @ 10Hz  2 = Fixed Output Voltage @ 1.5V
    DAC_Test(0); // Stepped Voltage Output.  Ramps up and Down
    // DAC_Test(1, 10);      // SineWave  // 1, 10, 50 Hz etc
    // DAC_Test(2, 1.5); // Fixed DAC Ouput Voltage.  Example 1.5V Output
  }

  // Simply DisplayRegisters on Loop if Enabled
  if (EnableBasicLoop == true)
  {
    DisplayRegisters();
    Serial.println("- - - / / - - -\n");
  }

  // Simple test for Loop to bypass EnableBasicLoop if User Button Pressed for ~ 1 Second.  Ignore if ESP32 DAC used.
  if (digitalRead(User_Button) == LOW && EnableDACTestOutput == false && EnablePWMLocal == false && EnableDACRemote == false)
  {
    DisplayRegisters();
    Serial.println("- - - / / - - -\n");
  }

  // Display Values to OLED Display
  if (EnableOLEDLoop == true || OLED_Enabled == true)
  {

    DisplayRegisters(false); // Refresh Values and Display.  Default false = Mute Expanded Info to Serial

    // Update the OLED Display
    oled.clear();
    oled.setScale(2);

    if (LineVoltageAverage > 100 || LineVoltage1 > 100) // Arbitrary Value
    {

      oled.setCursor(0, 2);

      // Reset Counter
      if (OLEDCount >= 3)
        OLEDCount = 0;

      OLEDCount++;

      // Check Active Power and Display on Each Channel
      oled.printf("%d: ", OLEDCount);

      switch (OLEDCount)
      {
      case 1:
        if (ActivePowerImportCT1 > 0)
        {
          oled.printf("%.0f W", ActivePowerImportCT1);
          sDIR = "Impt";
        }
        else if (ActivePowerExportCT1 > 0)
        {
          oled.printf("%.0f W", ActivePowerExportCT1);
          sDIR = "Expt";
        }
        else
        {
          oled.printf("0 W");
          sDIR = "Zero";
        }
        break;

      case 2:
        if (ActivePowerImportCT2 > 0)
        {
          oled.printf("%.0f W", ActivePowerImportCT2);
          sDIR = "Impt";
        }
        else if (ActivePowerExportCT2 > 0)
        {
          oled.printf("%.0f W", ActivePowerExportCT2);
          sDIR = "Expt";
        }
        else
        {
          oled.printf("0 W");
          sDIR = "Zero";
        }
        break;

      case 3:
        if (ActivePowerImportCT3 > 0)
        {
          oled.printf("%.0f W", ActivePowerImportCT3);
          sDIR = "Impt";
        }
        else if (ActivePowerExportCT3 > 0)
        {
          oled.printf("%.0f W", ActivePowerExportCT3);
          sDIR = "Expt";
        }
        else
        {
          oled.printf("0 W");
          sDIR = "Zero";
        }
        break;
      }

      // Header
      oled.setCursor(0, 0);
      oled.print(LineVoltage1, 0);
      oled.println(" V " + sDIR);
    }
    else
    {
      // Houston, We may have a probem
      oled.clear();
      OLEDPrint("Please Chk", 2, 0);
      OLEDPrint("Line Volts", 2, 2);
      oled.update();

      delay(1500);

      // DisplayOLEDWiFiStatus
      DisplayOLEDWiFiStatus();
    }

    // Write to OLED
    oled.update();
  }

  // Publish Values to Domoticz (Set WiFi and Indexes)
  if (EnableDomoticz == true && WiFi.status() == WL_CONNECTED)
  {
    DisplayRegisters(false); // Refresh Values and Display.  Default false = Mute Expanded Info to Serial
    PublishDomoticzValues(); // Publish Values to Domoticz
  }

  // Publish Values to MQTT (Set WiFi and Indexes)
  if (EnableMQTT == true && WiFi.status() == WL_CONNECTED)
  {
    DisplayRegisters(false); // Refresh Values and Display.  Default false = Mute Expanded Info to Serial
    PublishMQTTValues();     // Publish Values to MQTT
  }

  // Publish Values to ThingSpeak (Set WiFi and Indexes)
  if (EnableThingSpeak == true && WiFi.status() == WL_CONNECTED)
  {
    DisplayRegisters(false);   // Refresh Values and Display.  Default false = Mute Expanded Info to Serial
    PublishThingSpeakValues(); // Publish Values to ThingSpeak
  }

  // Heatbeat LED
  digitalWrite(LED_Blue, LOW);
  delay(50);
  digitalWrite(LED_Blue, HIGH);

  // Loop Delay
  delay(LoopDelay * 1000);
} // loop
