Chamil1983/SM-GE3222M-Smart-Energy-Monitor/Examples/IPEM_1_Test_Code_ATM90E32_ATM90E36/src/ATM90E3x.cpp

/*

  IPEM-1 ESP32 ATM90E32 ATM90E36 IoT Power Energy Monitoring Energy Monitor v1.0

  Full header information in main.cpp.

  This test code is OPEN SOURCE and formatted for easier viewing.  Although is is not intended for real world use, it may be freely used, or modified as needed.
  It is distributed on an "AS IS" BASIS, WITHOUT WARRANTIES OR CONDITIONS OF ANY KIND, either express or implied.

  Further information, details, and examples can be found on our Github https://github.com/Chamil1983/SM-GE3222M-Smart-Energy-Monitor
*/

// Libraries
#include <ATM90E3x.h>

ATM90E3x::ATM90E3x(void)
{
  // Begin
}

ATM90E3x::~ATM90E3x()
{
  // End
}

// **************** ATM90E - Communication Establishment ****************
/*
  - Defines Register Mask
  - Treats the Register and SPI Comms
  - Outputs the required value in the register
*/
unsigned short ATM90E3x::CommEnergyIC(unsigned char RW, unsigned short address, unsigned short val)
{
  unsigned char *data = (unsigned char *)&val;
  unsigned char *adata = (unsigned char *)&address;
  unsigned short output;
  unsigned short address1;

  // **************** SPI Settings ESP32 ****************
  SPISettings settings(200000, MSBFIRST, SPI_MODE3);

  // Switch MSB and LSB of value
  output = (val >> 8) | (val << 8);
  val = output;

  // Set R/W flag
  address |= RW << 15;

  // Swap byte address
  address1 = (address >> 8) | (address << 8);
  address = address1;

  // Transmit & Receive Data
  SPI.beginTransaction(settings);

  // Chip enable and wait for SPI activation
  digitalWrite(_cs, LOW);
  delayMicroseconds(10);

  // Write address byte by byte
  for (byte i = 0; i < 2; i++)
  {
    SPI.transfer(*adata);
    adata++;
  }

  /* Must wait 4 us for data to become valid */
  delayMicroseconds(4);

  // READ Data
  // Do for each byte in transfer
  if (RW)
  {
    for (byte i = 0; i < 2; i++)
    {
      *data = SPI.transfer(0x00);
      data++;
    }
  }
  else
  {
    for (byte i = 0; i < 2; i++)
    {
      SPI.transfer(*data);
      data++;
    }
  }

  // Chip enable and wait for transaction to end
  digitalWrite(_cs, HIGH);
  delayMicroseconds(10);

  SPI.endTransaction();

  output = (val >> 8) | (val << 8); // reverse MSB and LSB
  return output;
} // ATM90E3x::CommEnergyIC

// **************** REGISTER FUNCTIONS ****************

int ATM90E3x::Read32Register(signed short regh_addr, signed short regl_addr)
{
  int val, val_h, val_l;
  val_h = CommEnergyIC(READ, regh_addr, 0xFFFF);
  val_l = CommEnergyIC(READ, regl_addr, 0xFFFF);
  val = CommEnergyIC(READ, regh_addr, 0xFFFF);

  val = val_h << 16;
  val |= val_l; // concatenate the 2 registers to make 1 32 bit number

  return (val);
} // ATM90E3x::Read32Register

double ATM90E3x::CalculateVIOffset(unsigned short regh_addr, unsigned short regl_addr /*, unsigned short offset_reg*/)
{
  // for getting the lower registers of Voltage and Current and calculating the offset
  // should only be run when CT sensors are connected to the meter,
  // but not connected around wires
  uint32_t val, val_h, val_l;
  uint16_t offset;
  val_h = CommEnergyIC(READ, regh_addr, 0xFFFF);
  val_l = CommEnergyIC(READ, regl_addr, 0xFFFF);
  val = CommEnergyIC(READ, regh_addr, 0xFFFF);

  val = val_h << 16; // move high register up 16 bits
  val |= val_l;      // concatenate the 2 registers to make 1 32 bit number
  val = val >> 7;    // right shift 7 bits - lowest 7 get ignored - V & I registers need this
  val = (~val) + 1;  // 2s compliment

  offset = val; // keep lower 16 bits
  // CommEnergyIC(WRITE, offset_reg, (signed short)val);
  return uint16_t(offset);
} // ATM90E3x::CalculateVIOffset

double ATM90E3x::CalculatePowerOffset(unsigned short regh_addr, unsigned short regl_addr /*, unsigned short offset_reg*/)
{
  // for getting the lower registers of energy and calculating the offset
  // should only be run when CT sensors are connected to the meter,
  // but not connected around wires
  uint32_t val, val_h, val_l;
  uint16_t offset;
  val_h = CommEnergyIC(READ, regh_addr, 0xFFFF);
  val_l = CommEnergyIC(READ, regl_addr, 0xFFFF);
  val = CommEnergyIC(READ, regh_addr, 0xFFFF);

  val = val_h << 16; // move high register up 16 bits
  val |= val_l;      // concatenate the 2 registers to make 1 32 bit number
  val = (~val) + 1;  // 2s compliment

  offset = val; // keep lower 16 bits
  // CommEnergyIC(WRITE, offset_reg, (signed short)val);
  return uint16_t(offset);
} // ATM90E3x::CalculatePowerOffset

double ATM90E3x::CalibrateVI(unsigned short reg, unsigned short actualVal)
{
  // input the Voltage or Current register, and the actual value that it should be
  // actualVal can be from a calibration meter or known value from a power supply
  uint16_t gain, val, m, gainReg;
  // sample the reading
  val = CommEnergyIC(READ, reg, 0xFFFF);
  val += CommEnergyIC(READ, reg, 0xFFFF);
  val += CommEnergyIC(READ, reg, 0xFFFF);
  val += CommEnergyIC(READ, reg, 0xFFFF);

  // get value currently in gain register
  switch (reg)
  {
  case UrmsA:
  {
    gainReg = UgainA;
  }
  case UrmsB:
  {
    gainReg = UgainB;
  }
  case UrmsC:
  {
    gainReg = UgainC;
  }
  case IrmsA:
  {
    gainReg = IgainA;
  }
  case IrmsB:
  {
    gainReg = IgainB;
  }
  case IrmsC:
  {
    gainReg = IgainC;
  }
  }

  gain = CommEnergyIC(READ, gainReg, 0xFFFF);
  m = actualVal;
  m = ((m * gain) / val);
  gain = m;

  // write new value to gain register
  CommEnergyIC(WRITE, gainReg, gain);

  return (gain);
} // ATM90E3x::CalibrateVI

#if ATM90DEVICE == ATM90E36_DEVICE
/* Checksum Error Function */
bool ATM90E3x::calibrationError()
{
  bool CS0, CS1, CS2, CS3;
  unsigned short systemstatus0 = GetSysStatus0();

  if (systemstatus0 & 0x4000)
  {
    CS0 = true;
  }
  else
  {
    CS0 = false;
  }

  if (systemstatus0 & 0x1000) // DW Updated 15th June 23, thanks to AM for highlighing this possible typo in TD code.
  {
    CS1 = true;
  }
  else
  {
    CS1 = false;
  }
  if (systemstatus0 & 0x0400)
  {
    CS2 = true;
  }
  else
  {
    CS2 = false;
  }
  if (systemstatus0 & 0x0100)
  {
    CS3 = true;
  }
  else
  {
    CS3 = false;
  }

  Serial.print("Checksum 0: ");
  Serial.print(CS0);
  Serial.print("\tChecksum 1: ");
  Serial.println(CS1);
  Serial.print("Checksum 2: ");
  Serial.print(CS2);
  Serial.print("\tChecksum 3: ");
  Serial.println(CS3);

  if (CS0 || CS1 || CS2 || CS3)
    return (true);
  else
    return (false);
}
#endif

// **************** PARAMETER FUNCTIONS ****************
// Returns Main Electrical Parameters, such as: Voltage, Current, Power, Energy, and Frequency, and Temperature

// **************** VOLTAGE
double ATM90E3x::GetLineVoltage1()
{
  unsigned short voltage = CommEnergyIC(READ, UrmsA, 0xFFFF);
  return (double)voltage / 100;
}
double ATM90E3x::GetLineVoltage2()
{
  unsigned short voltage = CommEnergyIC(READ, UrmsB, 0xFFFF);
  return (double)voltage / 100;
}
double ATM90E3x::GetLineVoltage3()
{
  unsigned short voltage = CommEnergyIC(READ, UrmsC, 0xFFFF);
  return (double)voltage / 100;
}

// **************** CURRENT
double ATM90E3x::GetLineCurrentCT1()
{
  unsigned short current = CommEnergyIC(READ, IrmsA, 0xFFFF);
  return (double)current / 1000;
}
double ATM90E3x::GetLineCurrentCT2()
{
  unsigned short current = CommEnergyIC(READ, IrmsB, 0xFFFF);
  return (double)current / 1000;
}
double ATM90E3x::GetLineCurrentCT3()
{
  unsigned short current = CommEnergyIC(READ, IrmsC, 0xFFFF);
  return (double)current / 1000;
}

double ATM90E3x::GetLineCurrentCTN()
{
  unsigned short current = CommEnergyIC(READ, IrmsN, 0xFFFF);
  return (double)current / 1000;
}

// **************** ACTIVE POWER
double ATM90E3x::GetActivePowerCT1()
{
  int val = Read32Register(PmeanA, PmeanALSB);
  return (double)val * 0.00032;
}
double ATM90E3x::GetActivePowerCT2()
{
  int val = Read32Register(PmeanB, PmeanBLSB);
  return (double)val * 0.00032;
}
double ATM90E3x::GetActivePowerCT3()
{
  int val = Read32Register(PmeanC, PmeanCLSB);
  return (double)val * 0.00032;
}
double ATM90E3x::GetTotalActivePower()
{
  int val = Read32Register(PmeanT, PmeanTLSB);
  return (double)val * 0.00032;
}

#if ATM90DEVICE == ATM90E32_DEVICE

// Active Fundamental Power
double ATM90E3x::GetTotalActiveFundPower()
{
  int val = Read32Register(PmeanTF, PmeanTFLSB);
  return (double)val * 0.00032;
}

// Active Harmonic Power
double ATM90E3x::GetTotalActiveHarPower()
{
  int val = Read32Register(PmeanTH, PmeanTHLSB);
  return (double)val * 0.00032;
}
#endif

// **************** REACTIVE POWER ****************
double ATM90E3x::GetReactivePowerCT1()
{
  int val = Read32Register(QmeanA, QmeanALSB);
  return (double)val * 0.00032;
}
double ATM90E3x::GetReactivePowerCT2()
{
  int val = Read32Register(QmeanB, QmeanBLSB);
  return (double)val * 0.00032;
}
double ATM90E3x::GetReactivePowerCT3()
{
  int val = Read32Register(QmeanC, QmeanCLSB);
  return (double)val * 0.00032;
}
double ATM90E3x::GetTotalReactivePower()
{
  int val = Read32Register(QmeanT, QmeanTLSB);
  return (double)val * 0.00032;
}

// **************** APPARENT POWER ****************
double ATM90E3x::GetApparentPowerCT1()
{
  int val = Read32Register(SmeanA, SmeanALSB);
  return (double)val * 0.00032;
}
double ATM90E3x::GetApparentPowerCT2()
{
  int val = Read32Register(SmeanB, SmeanBLSB);
  return (double)val * 0.00032;
}
double ATM90E3x::GetApparentPowerCT3()
{
  int val = Read32Register(SmeanC, SmeanCLSB);
  return (double)val * 0.00032;
}
double ATM90E3x::GetTotalApparentPower()
{
  int val = Read32Register(SmeanT, SAmeanTLSB);
  return (double)val * 0.00032;
}

// **************** FREQUENCY ****************
double ATM90E3x::GetFrequency()
{
  unsigned short freq = CommEnergyIC(READ, Freq, 0xFFFF);
  return (double)freq / 100;
}

// **************** POWER FACTOR ****************
double ATM90E3x::GetPowerFactorCT1()
{
  signed short pf = (signed short)CommEnergyIC(READ, PFmeanA, 0xFFFF);
  return (double)pf / 1000;
}
double ATM90E3x::GetPowerFactorCT2()
{
  signed short pf = (signed short)CommEnergyIC(READ, PFmeanB, 0xFFFF);
  return (double)pf / 1000;
}
double ATM90E3x::GetPowerFactorCT3()
{
  signed short pf = (signed short)CommEnergyIC(READ, PFmeanC, 0xFFFF);
  return (double)pf / 1000;
}
double ATM90E3x::GetTotalPowerFactor()
{
  signed short pf = (signed short)CommEnergyIC(READ, PFmeanT, 0xFFFF);
  return (double)pf / 1000;
}

// **************** MEAN PHASE ANGLE ****************
double ATM90E3x::GetPhaseCT1()
{
  unsigned short angleA = (unsigned short)CommEnergyIC(READ, PAngleA, 0xFFFF);
  return (double)angleA / 10;
}
double ATM90E3x::GetPhaseCT2()
{
  unsigned short angleB = (unsigned short)CommEnergyIC(READ, PAngleB, 0xFFFF);
  return (double)angleB / 10;
}
double ATM90E3x::GetPhaseCT3()
{
  unsigned short angleC = (unsigned short)CommEnergyIC(READ, PAngleC, 0xFFFF);
  return (double)angleC / 10;
}

// **************** TEMPERATURE ****************
double ATM90E3x::GetTemperature()
{
  short int atemp = (short int)CommEnergyIC(READ, Temp, 0xFFFF);
  return (double)atemp;
}

// **************** GET REGISTER VALUE ****************
double ATM90E3x::GetValueRegister(unsigned short registerRead)
{
  return (double)CommEnergyIC(READ, registerRead, 0xFFFF); // returns value register
}

// REGULAR ENERGY MEASUREMENT

// **************** FORWARD ACTIVE ENERGY ****************
// these registers accumulate energy and are cleared after being read
double ATM90E3x::GetImportEnergy()
{
  unsigned short ienergyT = CommEnergyIC(READ, APenergyT, 0xFFFF);
  return (double)ienergyT / 100 / 3200; // returns kWh
}
// unsigned short ienergyA = CommEnergyIC(READ, APenergyA, 0xFFFF);
// unsigned short ienergyB = CommEnergyIC(READ, APenergyB, 0xFFFF);
// unsigned short ienergyC = CommEnergyIC(READ, APenergyC, 0xFFFF);

// **************** FORWARD REACTIVE ENERGY ****************
#if ATM90DEVICE == ATM90E32_DEVICE
double ATM90E3x::GetImportReactiveEnergy()
{
  unsigned short renergyT = CommEnergyIC(READ, RPenergyT, 0xFFFF);
  return (double)renergyT / 100 / 3200; // returns kWh
}
// unsigned short renergyA = CommEnergyIC(READ, RPenergyA, 0xFFFF);
// unsigned short renergyB = CommEnergyIC(READ, RPenergyB, 0xFFFF);
// unsigned short renergyC = CommEnergyIC(READ, RPenergyC, 0xFFFF);

// **************** APPARENT ENERGY ****************
double ATM90E3x::GetImportApparentEnergy()
{
  unsigned short senergyT = CommEnergyIC(READ, SAenergyT, 0xFFFF);
  return (double)senergyT / 100 / 3200; // returns kWh
}
// unsigned short senergyA = CommEnergyIC(READ, SenergyA, 0xFFFF);
// unsigned short senergyB = CommEnergyIC(READ, SenergyB, 0xFFFF);
// unsigned short senergyC = CommEnergyIC(READ, SenergyC, 0xFFFF);
#endif

// **************** REVERSE ACTIVE ENERGY ****************
double ATM90E3x::GetExportEnergy()
{
  unsigned short eenergyT = CommEnergyIC(READ, ANenergyT, 0xFFFF);
  return (double)eenergyT / 100 / 3200; // returns kWh
}
// unsigned short eenergyA = CommEnergyIC(READ, ANenergyA, 0xFFFF);
// unsigned short eenergyB = CommEnergyIC(READ, ANenergyB, 0xFFFF);
// unsigned short eenergyC = CommEnergyIC(READ, ANenergyC, 0xFFFF);

// **************** REVERSE REACTIVE ENERGY ****************
#if ATM90DEVICE == ATM90E32_DEVICE
double ATM90E3x::GetExportReactiveEnergy()
{
  unsigned short reenergyT = CommEnergyIC(READ, RNenergyT, 0xFFFF);
  return (double)reenergyT / 100 / 3200; // returns kWh
}
// unsigned short reenergyA = CommEnergyIC(READ, RNenergyA, 0xFFFF);
// unsigned short reenergyB = CommEnergyIC(READ, RNenergyB, 0xFFFF);
// unsigned short reenergyC = CommEnergyIC(READ, RNenergyC, 0xFFFF);
#endif

// **************** System Status Registers ****************
#if ATM90DEVICE == ATM90E32_DEVICE
unsigned short ATM90E3x::GetSysStatus0()
{
  return CommEnergyIC(READ, EMMIntState0, 0xFFFF);
}
unsigned short ATM90E3x::GetSysStatus1()
{
  return CommEnergyIC(READ, EMMIntState1, 0xFFFF);
}
unsigned short ATM90E3x::GetMeterStatus0()
{
  return CommEnergyIC(READ, EMMState0, 0xFFFF);
}
unsigned short ATM90E3x::GetMeterStatus1()
{
  return CommEnergyIC(READ, EMMState1, 0xFFFF);
}
#endif

#if ATM90DEVICE == ATM90E36_DEVICE
unsigned short ATM90E3x::GetSysStatus0()
{
  return CommEnergyIC(READ, SysStatus0, 0xFFFF);
}
unsigned short ATM90E3x::GetSysStatus1()
{
  return CommEnergyIC(READ, SysStatus1, 0xFFFF);
}
unsigned short ATM90E3x::GetMeterStatus0()
{
  return CommEnergyIC(READ, EnStatus0, 0xFFFF);
}
unsigned short ATM90E3x::GetMeterStatus1()
{
  return CommEnergyIC(READ, EnStatus1, 0xFFFF);
}
#endif

// **************** Configuration ****************
// Use SPI MODE 0 for the ATM90E3x ??????

#if ATM90DEVICE == ATM90E32_DEVICE || ATM_SPLITPHASE == true
void ATM90E3x::begin(unsigned short lineFreq, unsigned short pgagain, unsigned short ugain1, unsigned short ugain2, unsigned short ugain3, unsigned short igainA, unsigned short igainB, unsigned short igainC)
#endif

#if ATM90DEVICE == ATM90E36_DEVICE && ATM_SPLITPHASE == false
    void ATM90E3x::begin(unsigned short lineFreq, unsigned short pgagain, unsigned short ugain1, unsigned short ugain2, unsigned short ugain3, unsigned short igainA, unsigned short igainB, unsigned short igainC, unsigned short igainN)
#endif
{
  _cs = 5;              // SS IPEM = GP5
  _lineFreq = lineFreq; // frequency of power
  _pgagain = pgagain;   // PGA Gain for current channels#

#if ATM_SINGLEVOLTAGE == true
  _ugain1 = ugain1; // Voltage RMS Gain
  _ugain2 = ugain1; // Duplicate ugain1 Values to _ugain2 and _ugain3.
  _ugain3 = ugain1; // Duplicate ugain1 Values to _ugain2 and _ugain3.
#else
  _ugain1 = ugain1; // Voltage 1 RMS Gain
  _ugain2 = ugain2; // Voltage 2 RMS Gain
  _ugain3 = ugain3; // Voltage 3 RMS Gain
#endif

  _igainA = igainA; // CT1
  _igainB = igainB; // CT2 - not used for single split phase meter
  _igainC = igainC; // CT3 or CT2 for single split phase meter

#if ATM90DEVICE == ATM90E36_DEVICE && ATM_SPLITPHASE == false
  _igainN = igainN; // CTN (Used on the ATM90E36)
#endif

  pinMode(_cs, OUTPUT);

  /* Enable SPI */
  SPI.begin();

  Serial.print("Connecting to the ");

#if ATM90DEVICE == ATM90E32_DEVICE
  Serial.println("ATM90E32");
#endif

#if ATM90DEVICE == ATM90E36_DEVICE
  Serial.println("ATM90E36");
#endif

  // calculation for voltage sag threshold - assumes we do not want to go under 90v for split phase and 190v otherwise
  // determine proper low and high frequency threshold
  unsigned short vSagTh;
  unsigned short sagV;
  unsigned short FreqHiThresh;
  unsigned short FreqLoThresh;
  if (_lineFreq == 4485 || _lineFreq == 5231)
  {
    sagV = 90;
    FreqHiThresh = 61 * 100;
    FreqLoThresh = 59 * 100;
  }
  else
  {
    sagV = 190;
    FreqHiThresh = 51 * 100;
    FreqLoThresh = 49 * 100;
  }

  vSagTh = (sagV * 100 * sqrt(2)) / (2 * _ugain1 / 32768);

  // **************** Initialize registers ****************
  CommEnergyIC(WRITE, SoftReset, 0x789A); // 70 Perform soft reset

#if ATM90DEVICE == ATM90E36_DEVICE
  // SagTh = Vth * 100 * sqrt(2) / (2 * Ugain / 32768)
  CommEnergyIC(WRITE, FuncEn0, 0x0000); // Voltage sag
  CommEnergyIC(WRITE, FuncEn1, 0x0000); // Voltage sag
  CommEnergyIC(WRITE, SagTh, 0x0001);   // Voltage sag threshold
#endif

  // **************** Status registers ****************

#if ATM90DEVICE == ATM90E32_DEVICE
  CommEnergyIC(WRITE, CfgRegAccEn, 0x55AA); // 7F enable register config access
  CommEnergyIC(WRITE, MeterEn, 0x0001);     // 00 Enable Metering

  CommEnergyIC(WRITE, SagPeakDetCfg, 0x143F);  // 05 Sag and Voltage peak detect period set to 20ms
  CommEnergyIC(WRITE, SagTh, vSagTh);          // 08 Voltage sag threshold
  CommEnergyIC(WRITE, FreqHiTh, FreqHiThresh); // 0D High frequency threshold
  CommEnergyIC(WRITE, FreqLoTh, FreqLoThresh); // 0C Lo frequency threshold
  CommEnergyIC(WRITE, EMMIntEn0, 0xB76F);      // 75 Enable interrupts
  CommEnergyIC(WRITE, EMMIntEn1, 0xDDFD);      // 76 Enable interrupts
  CommEnergyIC(WRITE, EMMIntState0, 0x0001);   // 73 Clear interrupt flags
  CommEnergyIC(WRITE, EMMIntState1, 0x0001);   // 74 Clear interrupt flags
  CommEnergyIC(WRITE, ZXConfig, 0xD654);       // 07 ZX2, ZX1, ZX0 pin config - set to current channels, all polarity
#endif

// **************** Set metering config values (CONFIG) ****************
#if ATM90DEVICE == ATM90E32_DEVICE
  CommEnergyIC(WRITE, PLconstH, 0x0861);  // 31 PL Constant MSB (default) - Meter Constant = 3200 - PL Constant = 140625000
  CommEnergyIC(WRITE, PLconstL, 0xC468);  // 32 PL Constant LSB (default) - this is 4C68 in the application note, which is incorrect
  CommEnergyIC(WRITE, MMode0, _lineFreq); // 33 Mode Config (frequency set in main program)
  CommEnergyIC(WRITE, MMode1, _pgagain);  // 34 PGA Gain Configuration for Current Channels - 0x002A (x4) // 0x0015 (x2) // 0x0000 (1x)
  CommEnergyIC(WRITE, PStartTh, 0x1D4C);  // 35 All phase Active Startup Power Threshold - 50% of startup current = 0.02A/0.00032 = 7500
  CommEnergyIC(WRITE, QStartTh, 0x1D4C);  // 36 All phase Reactive Startup Power Threshold
  CommEnergyIC(WRITE, SStartTh, 0x1D4C);  // 37 All phase Apparent Startup Power Threshold
  CommEnergyIC(WRITE, PPhaseTh, 0x02EE);  // 38 Each phase Active Phase Threshold = 10% of startup current = 0.002A/0.00032 = 750
  CommEnergyIC(WRITE, QPhaseTh, 0x02EE);  // 39 Each phase Reactive Phase Threshold
  CommEnergyIC(WRITE, SPhaseTh, 0x02EE);  // 3A Each phase Apparent Phase Threshold
#endif

#if ATM90DEVICE == ATM90E36_DEVICE
  CommEnergyIC(WRITE, ConfigStart, 0x5678); // Metering calibration startup
  CommEnergyIC(WRITE, PLconstH, 0x0861);    // PL Constant MSB (default)
  CommEnergyIC(WRITE, PLconstL, 0xC468);    // PL Constant LSB (default)
  CommEnergyIC(WRITE, MMode0, _lineFreq);   // 0x1087.  Mode Config (60 Hz, 3P4W)
  CommEnergyIC(WRITE, MMode1, _pgagain);    // 0x1500.  0x5555 (x2) // 0x0000 (1x)
  CommEnergyIC(WRITE, PStartTh, 0x0000);    // Active Startup Power Threshold
  CommEnergyIC(WRITE, QStartTh, 0x0000);    // Reactive Startup Power Threshold
  CommEnergyIC(WRITE, SStartTh, 0x0000);    // Apparent Startup Power Threshold
  CommEnergyIC(WRITE, PPhaseTh, 0x0000);    // Active Phase Threshold
  CommEnergyIC(WRITE, QPhaseTh, 0x0000);    // Reactive Phase Threshold
  CommEnergyIC(WRITE, SPhaseTh, 0x0000);    // Apparent  Phase Threshold
  CommEnergyIC(WRITE, CSZero, 0x4741);      // Checksum 0
#endif

// **************** Set Metering Calibration Register Values (CALIBRATION) ****************
#if ATM90DEVICE == ATM90E32_DEVICE
  CommEnergyIC(WRITE, PQGainA, 0x0000);  // 47 Line calibration gain
  CommEnergyIC(WRITE, PhiA, 0x0000);     // 48 Line calibration angle
  CommEnergyIC(WRITE, PQGainB, 0x0000);  // 49 Line calibration gain
  CommEnergyIC(WRITE, PhiB, 0x0000);     // 4A Line calibration angle
  CommEnergyIC(WRITE, PQGainC, 0x0000);  // 4B Line calibration gain
  CommEnergyIC(WRITE, PhiC, 0x0000);     // 4C Line calibration angle
  CommEnergyIC(WRITE, PoffsetA, 0x0000); // 41 A line active power offset FFDC
  CommEnergyIC(WRITE, QoffsetA, 0x0000); // 42 A line reactive power offset
  CommEnergyIC(WRITE, PoffsetB, 0x0000); // 43 B line active power offset
  CommEnergyIC(WRITE, QoffsetB, 0x0000); // 44 B line reactive power offset
  CommEnergyIC(WRITE, PoffsetC, 0x0000); // 45 C line active power offset
  CommEnergyIC(WRITE, QoffsetC, 0x0000); // 46 C line reactive power offset
#endif

#if ATM90DEVICE == ATM90E36_DEVICE
  CommEnergyIC(WRITE, CalStart, 0x5678); // Metering calibration startup
  CommEnergyIC(WRITE, GainA, 0x0000);    // Line calibration gain
  CommEnergyIC(WRITE, PhiA, 0x0000);     // Line calibration angle
  CommEnergyIC(WRITE, GainB, 0x0000);    // Line calibration gain
  CommEnergyIC(WRITE, PhiB, 0x0000);     // Line calibration angle
  CommEnergyIC(WRITE, GainC, 0x0000);    // Line calibration gain
  CommEnergyIC(WRITE, PhiC, 0x0000);     // Line calibration angle
  CommEnergyIC(WRITE, PoffsetA, 0x0000); // A line active power offset
  CommEnergyIC(WRITE, QoffsetA, 0x0000); // A line reactive power offset
  CommEnergyIC(WRITE, PoffsetB, 0x0000); // B line active power offset
  CommEnergyIC(WRITE, QoffsetB, 0x0000); // B line reactive power offset
  CommEnergyIC(WRITE, PoffsetC, 0x0000); // C line active power offset
  CommEnergyIC(WRITE, QoffsetC, 0x0000); // C line reactive power offset
  CommEnergyIC(WRITE, CSOne, 0x0000);    // Checksum 1
#endif

// **************** FUNDAMENTAL/HARMONIC & ENERGY CALIBRATION REGISTERS ****************
#if ATM90DEVICE == ATM90E32_DEVICE
  CommEnergyIC(WRITE, POffsetAF, 0x0000); // 51 A Fund. active power offset
  CommEnergyIC(WRITE, POffsetBF, 0x0000); // 52 B Fund. active power offset
  CommEnergyIC(WRITE, POffsetCF, 0x0000); // 53 C Fund. active power offset
  CommEnergyIC(WRITE, PGainAF, 0x0000);   // 54 A Fund. active power gain
  CommEnergyIC(WRITE, PGainBF, 0x0000);   // 55 B Fund. active power gain
  CommEnergyIC(WRITE, PGainCF, 0x0000);   // 56 C Fund. active power gain
#endif

#if ATM90DEVICE == ATM90E36_DEVICE
  CommEnergyIC(WRITE, HarmStart, 0x5678); // Metering calibration startup
  CommEnergyIC(WRITE, POffsetAF, 0x0000); // A Fund. active power offset
  CommEnergyIC(WRITE, POffsetBF, 0x0000); // B Fund. active power offset
  CommEnergyIC(WRITE, POffsetCF, 0x0000); // C Fund. active power offset
  CommEnergyIC(WRITE, PGainAF, 0x0000);   // A Fund. active power gain
  CommEnergyIC(WRITE, PGainBF, 0x0000);   // B Fund. active power gain
  CommEnergyIC(WRITE, PGainCF, 0x0000);   // C Fund. active power gain
  CommEnergyIC(WRITE, CSTwo, 0x0000);     // Checksum 2
#endif

// **************** MEASUREMENT CALIBRATION REGISTERS ****************
#if ATM90DEVICE == ATM90E32_DEVICE
  // A
  CommEnergyIC(WRITE, UgainA, _ugain1);  // 61 A Voltage rms gain
  CommEnergyIC(WRITE, IgainA, _igainA);  // 62 A line current gain
  CommEnergyIC(WRITE, UoffsetA, 0x0000); // 63 A Voltage offset - 61A8
  CommEnergyIC(WRITE, IoffsetA, 0x0000); // 64 A line current offset - FE60
  // B
  CommEnergyIC(WRITE, UgainB, _ugain2);  // 65 B Voltage rms gain
  CommEnergyIC(WRITE, IgainB, _igainB);  // 66 B line current gain
  CommEnergyIC(WRITE, UoffsetB, 0x0000); // 67 B Voltage offset - 1D4C
  CommEnergyIC(WRITE, IoffsetB, 0x0000); // 68 B line current offset - FE60
  // C
  CommEnergyIC(WRITE, UgainC, _ugain3);  // 69 C Voltage rms gain
  CommEnergyIC(WRITE, IgainC, _igainC);  // 6A C line current gain
  CommEnergyIC(WRITE, UoffsetC, 0x0000); // 6B C Voltage offset - 1D4C
  CommEnergyIC(WRITE, IoffsetC, 0x0000); // 6C C line current offset
#endif

#if ATM90DEVICE == ATM90E36_DEVICE
  CommEnergyIC(WRITE, AdjStart, 0x5678); // Measurement calibration

  // A
  CommEnergyIC(WRITE, UgainA, _ugain1);  // A SVoltage rms gain
  CommEnergyIC(WRITE, IgainA, _igainA);  // A line current gain.
  CommEnergyIC(WRITE, UoffsetA, 0x0000); // A Voltage offset
  CommEnergyIC(WRITE, IoffsetA, 0x0000); // A line current offset
  // B
  CommEnergyIC(WRITE, UgainB, _ugain2);  // B Voltage rms gain.
  CommEnergyIC(WRITE, IgainB, _igainB);  // B line current gain
  CommEnergyIC(WRITE, UoffsetB, 0x0000); // B Voltage offset
  CommEnergyIC(WRITE, IoffsetB, 0x0000); // B line current offset
  // C
  CommEnergyIC(WRITE, UgainC, _ugain3);  // C Voltage rms gain
  CommEnergyIC(WRITE, IgainC, _igainC);  // C line current gain
  CommEnergyIC(WRITE, UoffsetC, 0x0000); // C Voltage offset
  CommEnergyIC(WRITE, IoffsetC, 0x0000); // C line current offset
  // N
  CommEnergyIC(WRITE, IgainN, 0xFD7F); // D line current gain

  CommEnergyIC(WRITE, CSThree, 0x02F6); // Checksum 3
#endif

#if ATM90DEVICE == ATM90E32_DEVICE
  Serial.print("ATM90E32");
#endif

#if ATM90DEVICE == ATM90E36_DEVICE
  Serial.print("ATM90E36");
#endif

  Serial.println(" Connected - OK");

// **************** DEFINE EMM STATUS REGISTERS ****************
#if ATM90DEVICE == ATM90E32_DEVICE
  CommEnergyIC(WRITE, CfgRegAccEn, 0x0000); // 7F end configuration
#endif
}
