Chamil1983/SM-GE3222M-Smart-Energy-Monitor/(commit log)

2026-02-06 Implement ATM90E36Driver - Complete low-level SPI driver for energy IC
    - Created ATM90E36Driver.h with complete interface (313 lines)
    - Created ATM90E36Driver.cpp with full implementation (822 lines)
    - Ported all functionality from V1.0 EnergyATM90E3x class
    - Core Features:
    * SPI communication with 3-retry mechanism
    * Full initialization with calibration parameters
    * All voltage/current/power measurements
    * THD measurements for all phases
    * Active/Reactive/Apparent power readings
    * Fundamental and harmonic power measurements
    * Power factor and phase angle measurements
    * Energy accumulation (import/export, active/reactive/apparent)
    * Status registers and calibration error ch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
2026-02-06 Complete Energy subsystem with EnergyMeter, Calibration, PowerQuality, and EnergyAccumulator classes
2026-02-06 Implement Storage subsystem for SM-GE3222M V2.0
    - NVStorage: ESP32 NVS wrapper with Preferences library
    - SPIFFSManager: SPIFFS filesystem management
    - ConfigManager: JSON configuration with validation and backup
    - DataLogger: CSV data logging with auto-rotation
2026-02-06 Add Communication subsystem Part 2: MQTT, Modbus, and OTA
    Implemented:
    - MQTTClient: Full MQTT 3.1.1 client with Home Assistant discovery
    - ModbusRTUServer: RS-485 Modbus RTU slave on UART2
    - ModbusTCPServer: Modbus TCP server on port 502
    - OTAManager: Firmware update via HTTP and ArduinoOTA
    All classes use singleton pattern and integrate with ErrorHandler
2026-02-06 Implement security subsystem and web interface for SM-GE3222M V2.0
    - Add AuthManager with session/API key management, rate limiting, CSRF protection
    - Create modern responsive web dashboard with real-time WebSocket updates
    - Add configuration page with all system settings
    - Implement Chart.js gauges and power history visualization
    - Add dark/light theme support with localStorage persistence
    - Include firmware upload and factory reset functionality
2026-02-07 Implement missing V2.0 firmware components: WebSocketServer, TCPDataServer, DisplayManager, ButtonHandler, ExportManager, AccessControl
2026-02-08 Add thread-safe Logger class with ring buffer for SM-GE3222M
2026-02-08 Add SPIBus singleton with thread-safe ATM90E36 protocol
2026-02-08 Add I2CBus and GPIOManager singleton classes with thread-safe operations
2026-02-08 feat: Add ATM90E36Driver.cpp - Complete port of V1.0 driver
    - Complete 587-line port from V1.0 EnergyATM90E36.cpp (~800 lines)
    - Singleton pattern implementation
    - SPIBus::getInstance() for thread-safe SPI operations
    - Logger integration for diagnostics
    - Full initialization sequence with soft reset
    - 4-phase calibration (Config, Cal, Harmonic, Measurement)
    - Checksum calculation and verification
    - All register reading methods: voltages, currents, powers, PF, angles, THD
    - 32-bit power register support (active, reactive, apparent)
    - Energy counter methods (forward/reverse active energy)
    - Frequency and temperature readings
    - Optimized readAll() for bulk data capture
    - Uses RegisterMap.h for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
2026-02-08 fix: Correct THD scaling and include path in ATM90E36Driver
    - Fix getCurrentTHDA/B/C to use THD_SCALE (100.0) instead of CURRENT_SCALE (1000.0)
    - Fix include path from "core/DataTypes.h" to "DataTypes.h"
    - Addresses code review findings
2026-02-08 Add CalibrationManager, EnergyMeter, and EnergyAccumulator modules
2026-02-08 Add SystemMonitor and WatchdogManager modules for V2.0
    Implements comprehensive system monitoring and watchdog management:
    SystemMonitor.h/.cpp:
    - Singleton pattern with thread-safe operations
    - init() to initialize monitoring with NVS persistence
    - update() to refresh all metrics (called every 5s from DiagnosticsTask)
    - getSystemStatus() returns complete SystemStatus struct
    - Tracks: free/min heap, CPU freq, uptime, WiFi RSSI, task stack watermarks, errors, boot count
    - getUptimeString() formats uptime as "Xd Yh Zm"
    - resetErrorCount() and error tracking methods
    WatchdogManager.h/.cpp:
    - Singleton pattern using ESP32 Task WDT (esp_task_wdt.h)
    - init(timeoutSeconds) with configurable timeo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
2026-02-08 Update V2 firmware docs to use Arduino IDE instead of PlatformIO
2026-02-08 Add Services layer for VB.NET Core library with MeterDataService, CalibrationService, ConfigurationService, and DataLoggerService
