Chamil1983/SM-GE3222M-Smart-Energy-Monitor/(notices)

Notices in the files:
README.md:
License: MIT
